jochenalt/Pentapod-Design/Readme.md

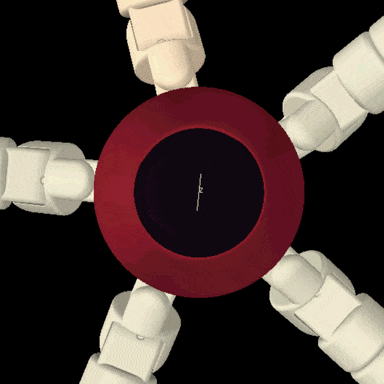
[picture p1: docs/videos/logo.gif]
work in progress
