jochenalt/Pentapod-Design/docs/kinematics.md

Kinematics is about computation of the toe’s point out of the joint angles and vice versa. First is simple, latter is tricky. 

The coordinate systems are illustrated as follows, to properly derive the Denavit Hardenberg transformation. 

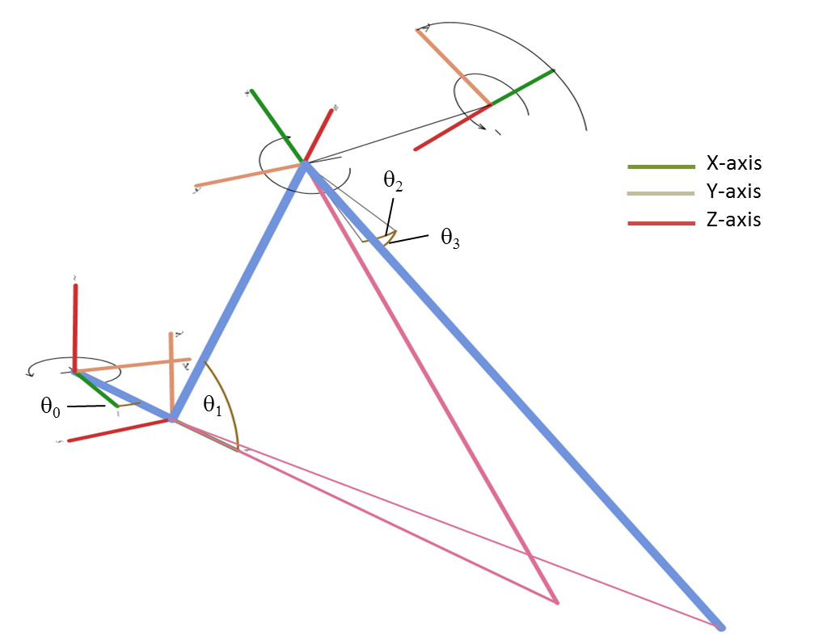
[picture p2: docs/images/image003.png]


The transformation from *angle<sub>i</sub>* to *angle<sub>i+1</sub>* is given via 

1. rotation around the x-axis by *α*

2. translation along the x-axis by *α*

3. translation along the z-axis by *d*, and

4. rotation around the z-axis by *θ*

So, the Denavit Hardenberg parameters are:

| Joint | a[°] | d[mm] | a[mm] | θ[°] |
|---  | ---| --- | --- | --- |
| Hip | *90°* | *d<sub>0</sub>* | *0* | θ<sub>0</sub>  |
| Thigh | *90°* | *d<sub>1</sub>* | *0* | θ<sub>1</sub>  |
| Knee | *90°+θ<sub>2</sub>* | *0* | *0* | *0* | |
| Foot | *0* | *d<sub>3</sub>* | *0* | θ<sub>3</sub>  |

According to the coordinate system above, θ<sub>2</sub> has an offset of 90°. The general definition of a Denavit-Hardenberg (DH) transformation is

&nbsp;&nbsp;&nbsp;&nbsp;  

which is a homogeneous matrix with two rotations (*x*,*z*) and two translations (*x*,*z*).
Combined with the DH parameters, the following DH matrixes define the transformation from one joint to its successor:

  
  
  
  

## Forward Kinematics of a Leg

With the *DH* transformation matrixes at hand, computation of the leg’s pose out of the joint angles is straight forward. The matrix representing the toe’s pose  is 

&nbsp;&nbsp;&nbsp;&nbsp; 

By multiplying the transformation matrix with the origin (as homogeneous vector), we get the absolute coordinates of the toe point (*TP*) centre point in world coordinate system (i.e. relative to the legs’s base).

&nbsp;&nbsp;&nbsp;&nbsp;

That was easy. The tricky part comes now.

## Inverse Kinematics of a Leg

Inverse kinematics denotes the computation of all joint angles out of the toe’s position (*TP*). Since the leg has four joints, it is becomes clear that there is an infinite number of solutions for that, so I need to predefine one angle with an arbitrary definition. Having the objective in mind of moving the higher limbs of the leg as little as possible, I arbitrarily chose *θ<sub>0</sub>* and set it as angle bisector of the toe to the hip (from bird’s perspective):

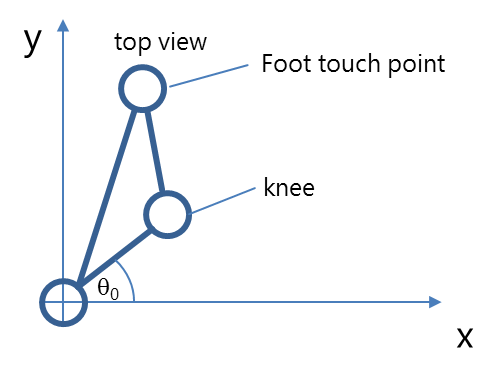
[picture p3: docs/images/image013.png]
&nbsp;&nbsp;&nbsp;&nbsp;

We get 

&nbsp;&nbsp;&nbsp;&nbsp;

Later on, we will need the coordinates of end of the first limb (*A*) which is 

Computation of the second angle *θ<sub>1</sub>*  at point *A* requires a geometric analysis. The leg is denoted in blue, all construction lines are red.

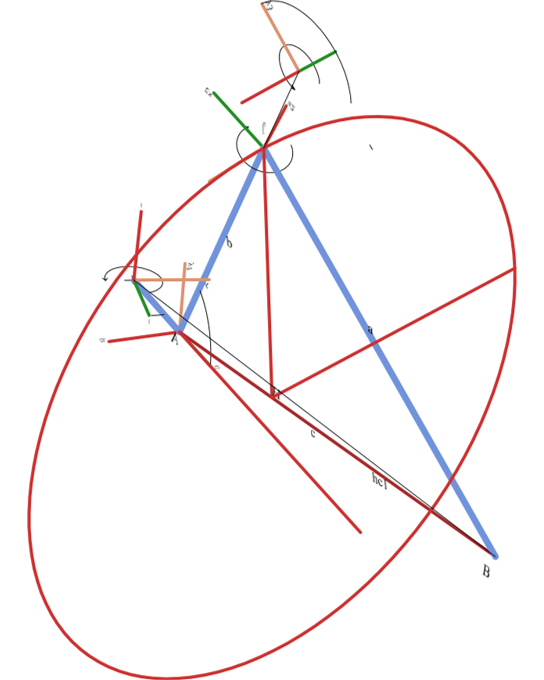
[picture p4: docs/images/image016.png]
&nbsp;&nbsp;&nbsp;&nbsp;

We consider the triangle from *A*, *B* and *C*. The two lines  and  are of fixed length. So, the point *C* is upon the circle with the centre H and the radius of the triangle’s height. Additionally, *C* is defined as function of *θ<sub>0</sub>* and *θ<sub>1</sub>*, so we should be able to derive *θ<sub>1</sub>* by intersecting the circle with *C(θ<sub>0</sub> ,θ<sub>1</sub>)*.

The only thing we need to do is to express that in terms of coordinates. First, we compute the length of *a*, *b* and *c*:

&nbsp;&nbsp;&nbsp;&nbsp;

&nbsp;&nbsp;&nbsp;&nbsp;

&nbsp;&nbsp;&nbsp;&nbsp;

Now that the triangle is defined, we can compute the height  by Herons formula

&nbsp;&nbsp;&nbsp;&nbsp;

The base of the height *H* is defined by 

&nbsp;&nbsp;&nbsp;&nbsp;

Now we need to define the circle *K* with radius *h* and centre *H*. This is done by *K = H sin(α) + T cos(α)* with *S* and *T* orthogonal to  as well as *S* and *T* being orthogonal to each other.

&nbsp;&nbsp;&nbsp;&nbsp;

So, with the arbitrary assumption  and the length  we get 

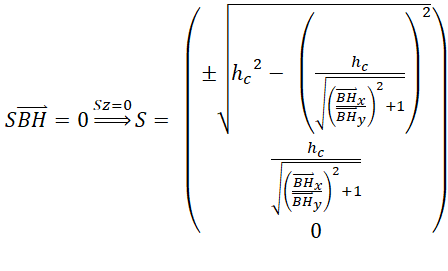
[picture p5: docs/images/image030.png]
&nbsp;&nbsp;&nbsp;&nbsp;

(This equation could be simplified, but this way programming is easier by computing the y coordinate and deriving the x coordinate)
There are two possibilities for *S*, representing two configuration with knee up and knee down. We always take the healthy one where the knee is above the toe point. Finally, T is defined by its orthogonality to *S* and its length :

&nbsp;&nbsp;&nbsp;&nbsp;

Having the circle defined, we need to intersect it with the possible positions of *C*:

&nbsp;&nbsp;&nbsp;&nbsp;

Hereby denotes  . We consider only the equations of *x* and *y* coordinates and solve these for *d<sub>1</sub>c<sub>1<sub>*. Equating gives

&nbsp;&nbsp;&nbsp;&nbsp;

This needs to be solved by in order to get point *C*. Unfortunately, we have *sin* and *cos* in the equation, but luckily with the same parameter. Wikipedia helps with sinusoids:

&nbsp;&nbsp;&nbsp;&nbsp;

This is used to solve the equation above for *α*:

&nbsp;&nbsp;&nbsp;&nbsp;

&nbsp;&nbsp;&nbsp;&nbsp;

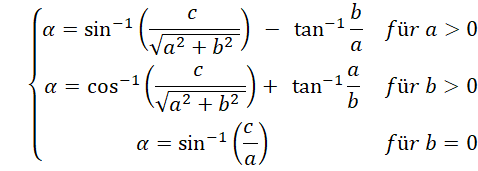
[picture p6: docs/images/image040.png]
&nbsp;&nbsp;&nbsp;&nbsp;

Out of *α* we get *C* by , out of *C* we compute *θ<sub>1</sub>* by considering the z-coordinate of *C*:

&nbsp;&nbsp;&nbsp;&nbsp;

which results in 

&nbsp;&nbsp;&nbsp;&nbsp;

The first angle is always the hardest, time for a beer.

We leave the knee-turn-angle *θ<sub>2</sub>* aside for a while and continue with the tibia *θ<sub>3</sub>*. This is done by considering the triangle *ABC*, and the angle at the point *C* represents *θ<sub>3</sub>*. In a fully elongated leg *θ<sub>3</sub>* is 0.
Therefore,  

The last angle *θ<sub>2</sub>* is computed by use of

&nbsp;&nbsp;&nbsp;&nbsp;

So, let’s have a closer look into the transformation matrix  and check if there are some useful equations considering that we already have all other angles. Annoying multiplication results in

&nbsp;&nbsp;&nbsp;&nbsp;

Since we need to compare this to the toe point, it is not necessary to compute the full matrix, the right column is sufficient. We are lucky, the third line has only one expression that depends on *θ<sub>2</sub>*, so we get

&nbsp;&nbsp;&nbsp;&nbsp;

Again, *arcsin* results in two solutions, so we need the other coordinates as well to check which solution is valid.
That’s it. Surprisingly complex for a leg with only 4 degrees of freedom.

# Body Kinematics

Attaching 5 legs around the body requires a transformation as well, plus we might want to translate and rotate the belly. Since the leg kinematics computes the limb angles out of the toe in the hip's coordinate system, we need to translate each leg’s toe point into the hip’s coordinate system.

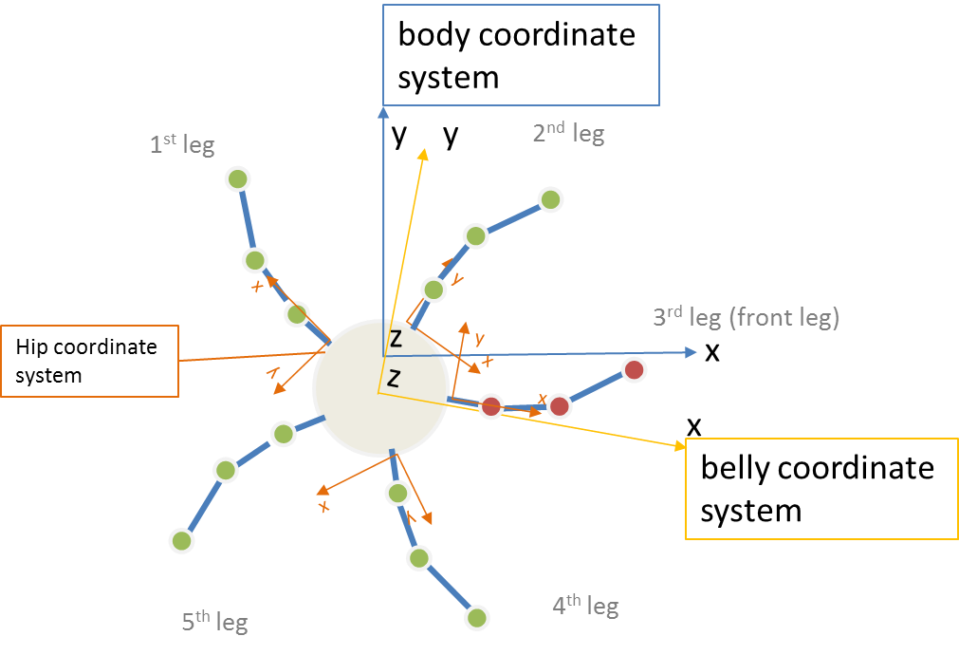
[picture p7: docs/images/image049.png]
&nbsp;&nbsp;&nbsp;&nbsp;

The pentapod’s pose is given in the body’s coordinate system, which origin is on the ground right below the body. The next coordinate system is owned by the belly which origin is the belly button. When the pentapod is in the default position, the belly coordinate system is translated in the z-axis by z-translation along the height of the belly. Finally, we have 5 hip coordinate systems which are x-translated by the distance of the belly to the hip and z-rotated by , where *n* is the number of the leg.
We define the transformation matrix *Belly* that defines the belly coordinate system out of the body coordinate system, that is a 3D rotation matrix plus a translation along the belly coordinates:

&nbsp;&nbsp;&nbsp;&nbsp;

For each leg we have an own transformation matrix which is a rotation θ in the *xy*-pane around the  *z*-axis:

&nbsp;&nbsp;&nbsp;&nbsp;

Having a point in one coordinate system and watching it from another one is done by multiplying it with the inverse transformation matrix. So, the toe point from the hips coordinate system *toe<sub>hip</sub>* is computed out of the toe point from the body’s coordinate system by 

&nbsp;&nbsp;&nbsp;&nbsp;

Computing-wise, the inverse matrix is done by Gauss or similar approaches with a complexity of *o(nm/2)*, which might be bad for the performance. Luckily, the inverse of a symmetric rotation matrix is the transposed matrix, and the rest can be computed by 

&nbsp;&nbsp;&nbsp;&nbsp;

which is much simpler.
