jochenalt/Pentapod-Design/docs/gait.md

Unfortunately, there's no real creature I am aware of that walks with five legs. You need three legs to stand, so two legs can leave the ground at the same time. This means that one leg is 60% of its time in the air above the ground. A tripod gait is not possible, a wave gait is really slow, but a ripple gait in a modified version for 5 legs is reasonable. The order of legs moving is 1,3,5,2,4:

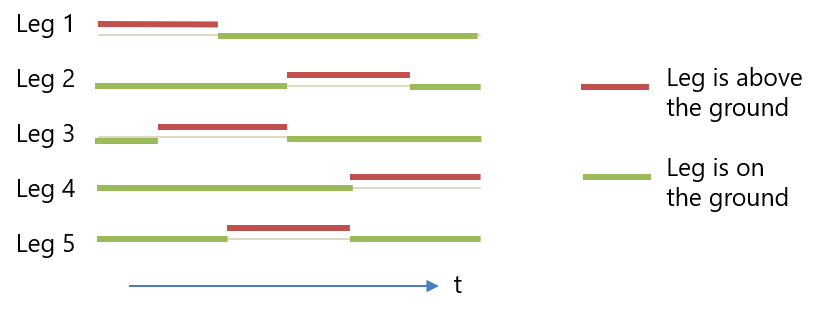
[picture p19: docs/images/ripple-gait.png]


The animation shows a red triangle that indicates the area where the bot is standing on. The sequence above leads to a slowly turning triangle.

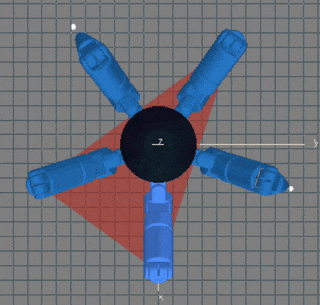
[picture p20: docs/videos/gaittimeshift.gif]


Still, it might be a need to have one spare leg to do something yukky. In that case a wave gait is the only alternative:

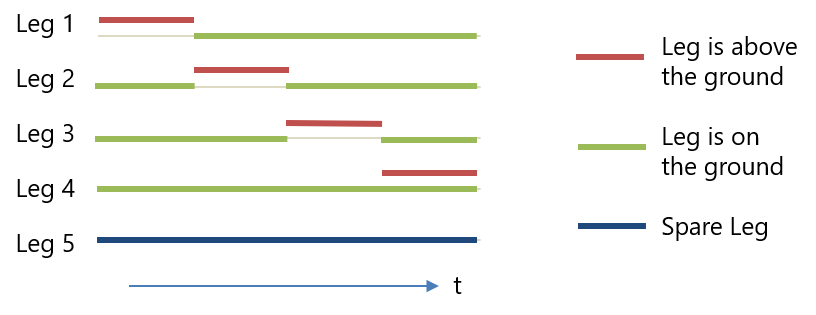
[picture p21: docs/images/wave-gait-with-spare-leg.png]


Being aware that the hips are now asymmetrically arranged, the body needs to be translated to be located above the supporting area. To avoid being on the edge of this area, the body swings towards the middle of this area:

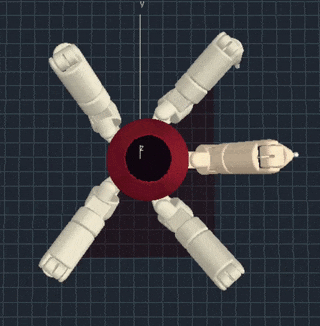
[picture p22: docs/videos/wave-gait-with-one-spare-leg.gif]


The leg movement is modelled with a cubic bezier curve with the first support point in the middle of the gait and the second one right above the touch point. This gives a bent curve accelerating when leaving the ground, and braking before touching the ground again.

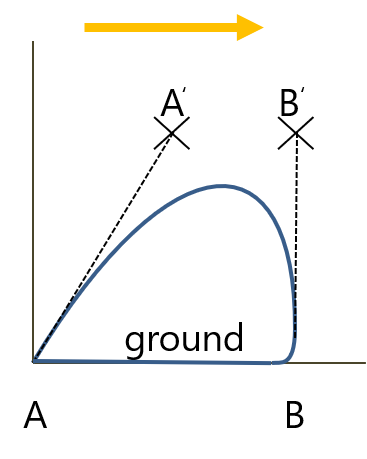
[picture p23: docs/images/leg-movement.png]


In real life this looks like this. Right before touching the ground the leg starts moving backwards. This is helpful to avoid a jolt giving an impulse to the body against the walking direction. 

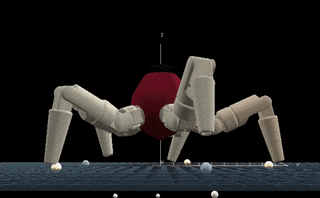
[picture p24: docs/videos/leg-movement.gif]


If the ground is not plain, the distance sensors in the leg detect that. After the zenith of the movement, the current distance to the ground is constantly compared to the expected distance according to the gait curve above2. The z-coordinate of the touch point is adapted accordingly leading to a compressed or stretched second half of the movement:

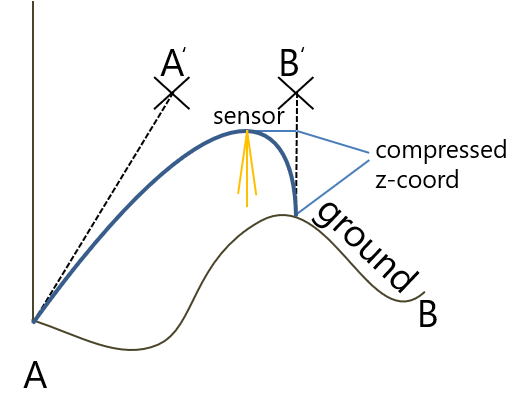
[picture p25: docs/images/leg-movement-terrain.png]
