jochenalt/Pentapod-Design/theory/Kinematic.pptx

lCoxa

m

lfemur

lTibia

ServoFemur

ServoTibia
