jochenalt/Pentapod-Design/docs/Images.pptx

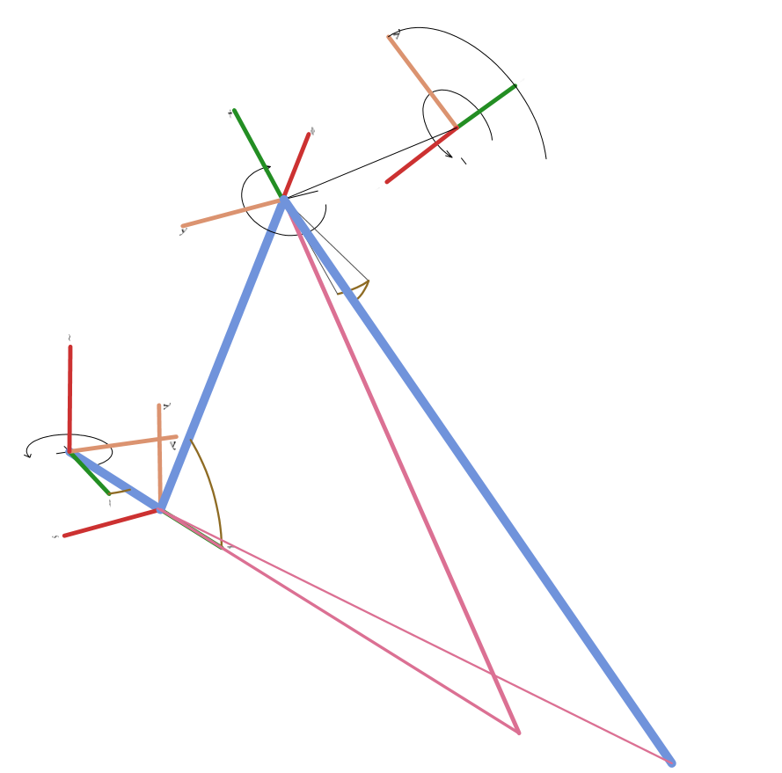
[picture p38: figure]

θ2

X-axis
Y-axis
Z-axis

θ3

θ0

θ1

## Slide 2

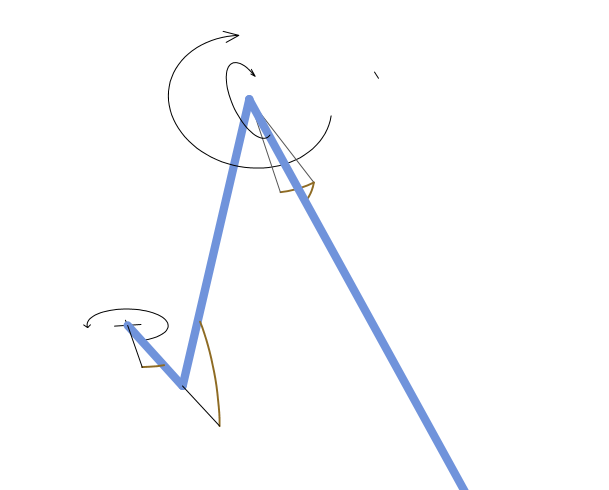
[picture p39: figure]

knee

foot

turning knee

hip

thigh

toe

## Slide 3


## Slide 4

body coordinate
system

z

2nd leg

y

x

y

x

y

x

z

1st leg

y

y

y

x

3rd leg (front leg)

Hip coordinate
system

x

x

belly coordinate
system

5th leg

4th leg

## Slide 5

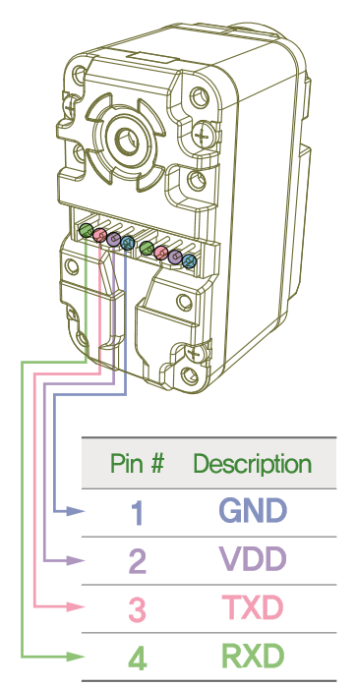
[picture p40: figure]
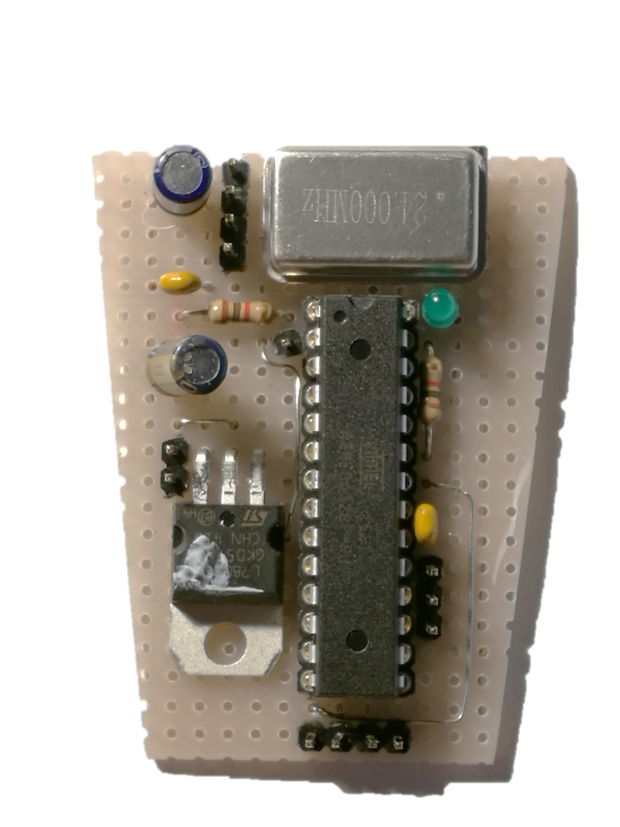
[picture p41: figure]

Herkulex
Servo Out

GND o
VDD o
TXD o
RXD o

RST o

GND o
5V o

AVR-ISP

o SCL
o MISO
o MOSI

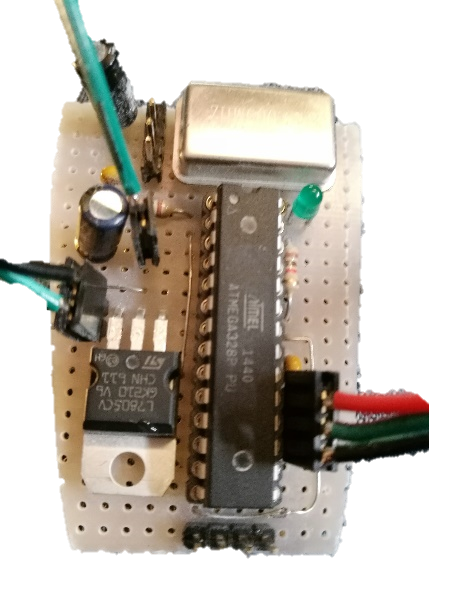
[picture p42: figure]

GND o
5V o
SDA o
Scl o

VL6180X

## Slide 6

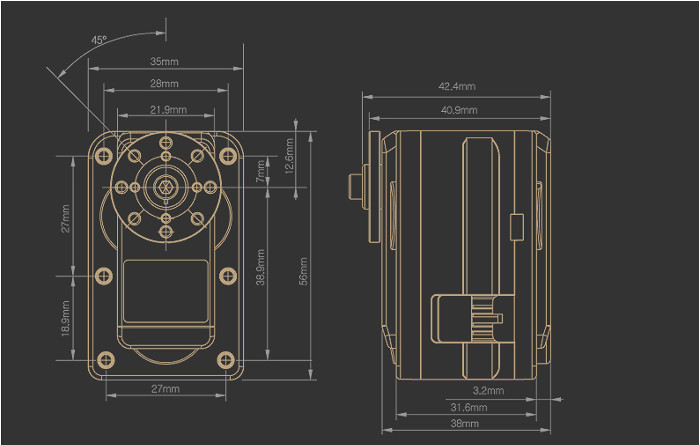
[picture p43: figure]

## Slide 7

Odroid
Linux/ROS

ROS node rplidarNode

ROS node hector_mapping

ROS node pentapod_engine

Teensy 3.5,
Arm M4, 120 Mhz

Legs

Leg 1..5

Leg

Leg

Leg

Leg

ROS node pentapod_server

RPLidar Driver

Hector SLAM

UART
/dev/ttyS1

Lidar

Cortex
Servo Control, IMU Data Grabber,
Distance Sensor Grabber

I2C1

UART2

UART3

Servo Thigh

Servo
Hip

UART4

Distance
Sensor
VL6180

Servo Knee

Servo Foot

Webserver REST
Mongoose

UART5

Servo Sensor
Adapter

UART6

I2C0

IMU
BNO055

Engine

I2C
/dev/i2c-1

Software
Module

Hardware, Sensor, Motor

Protocol,
Adapter

## Slide 8

Odroid
Linux/ROS

node „Server“

node „SLAM“

SLAM

Webserver

map

Lidar

Planning

Odometry

target

move

node „Engine“

Engine

map

state

state

move

move
