jochenalt/Pentapod-Design/theory/Denavit-Hartenberg.pdf

## Denavit-Hartenberg-Konventionen

Die Denavit-Hartenberg-Konventionen sind weit verbreitet und sollen die Durchführung der kinematischen Vorwärts- und Rückwärtstrans-formation erleichtern. Sie bestehen aus folgenden Teilen:

●DH-Konventionen zur Festlegung der Koordinatensysteme
●DH-Transformationen zur Erzeugung der Koordinatensysteme
●DH-Parametern aus den Transformationen

## Denavit-Hartenberg-Konventionen Festlegung der Koordinatensysteme

Die Festlegung der Koordinatensysteme erfolgt nach festen Regeln, um die nachfolgenden Schritte problemlos (?!) durchführen zu können.

Eine gewisse Wahlfreiheit bleibt trotzdem erhalten.

Diese Wahlfreiheit sollte so genutzt werden, dass möglichst viele DH-Parameter gleich Null werden. Dadurch werden die nachfolgenden Gleichungen und Berechnungen vereinfacht.

### Festlegung des Koordinatensystems K0

### (Sockel)

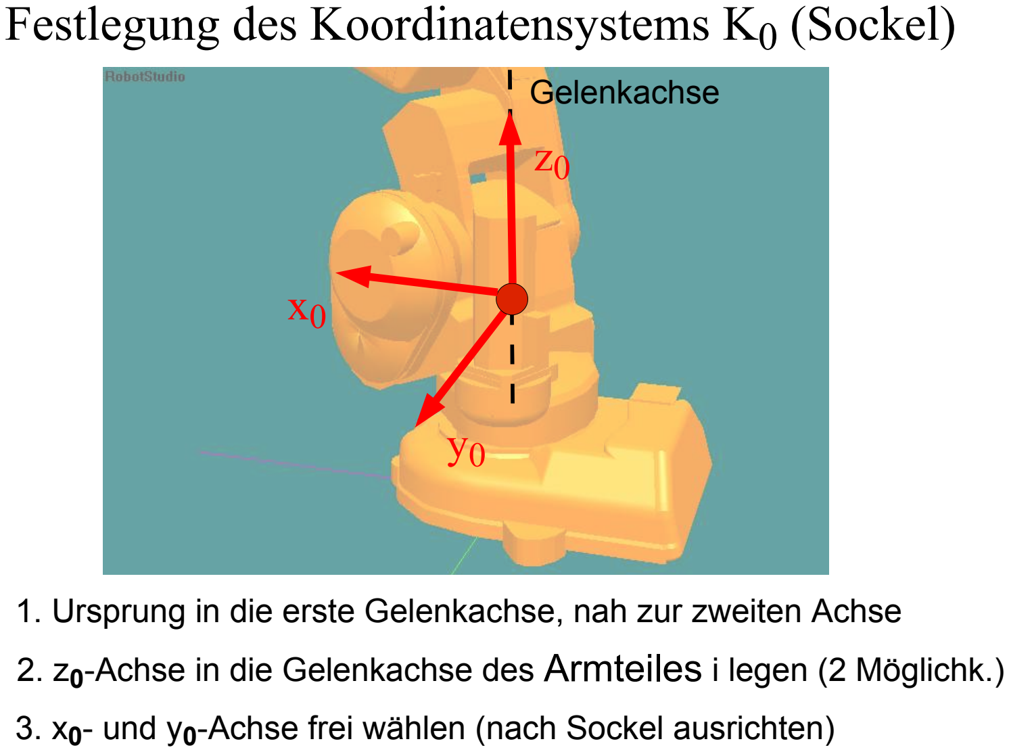
[picture p44: page 3]

Gelenkachse

1. Ursprung in die erste Gelenkachse, nah zur zweiten Achse
2. z0-Achse in die Gelenkachse des Armteiles i legen (2 Möglichk.)

y0

3. x0- und y0-Achse frei wählen (nach Sockel ausrichten)

z0

x0

### Festlegung des Koordinatensystems Ki

### bei

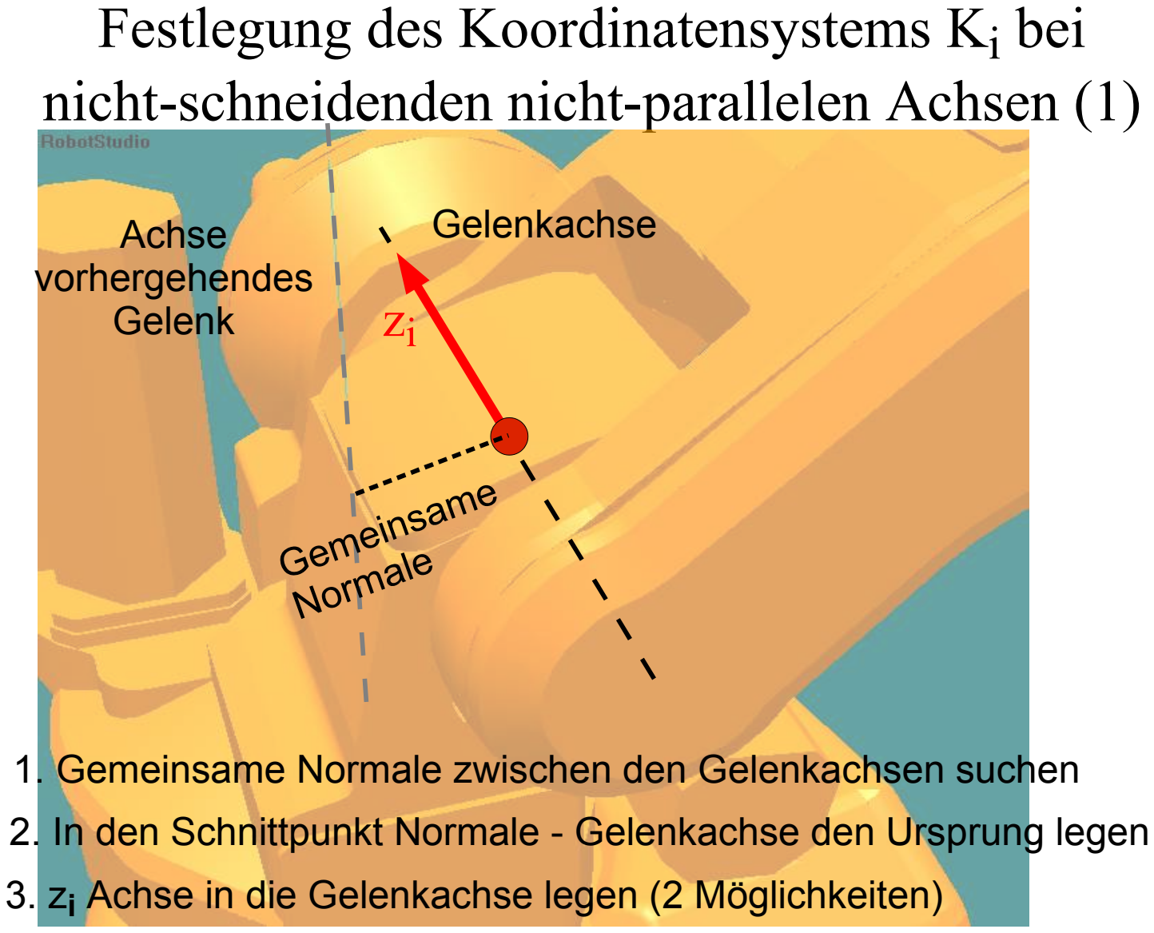
[picture p45: page 4]

### nicht-schneidenden nicht-parallelen Achsen (1)

1. Gemeinsame Normale zwischen den Gelenkachsen suchen
2. In den Schnittpunkt Normale - Gelenkachse den Ursprung legen

Gelenkachse
zi

Achse
vorhergehendes
Gelenk
3. zi Achse in die Gelenkachse legen (2 Möglichkeiten)

Gemeinsame
Normale

### Festlegung des Koordinatensystems Ki

### bei

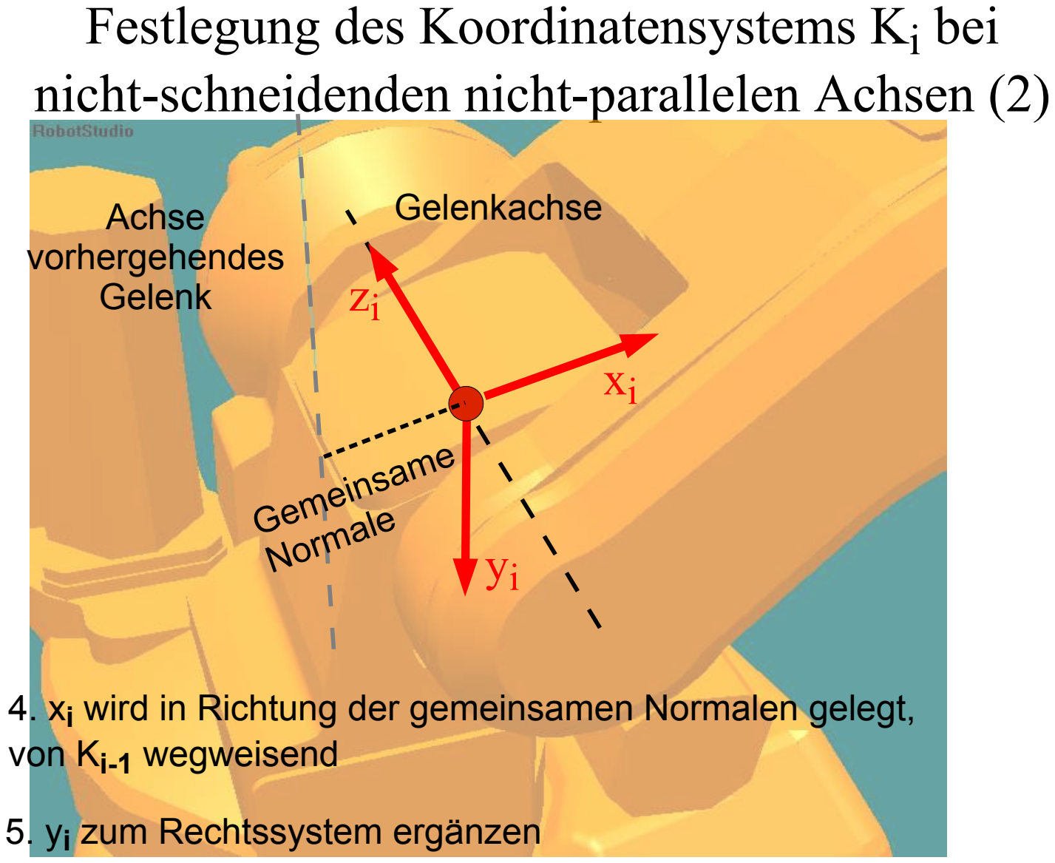
[picture p46: page 5]

### nicht-schneidenden nicht-parallelen Achsen (2)

4. xi wird in Richtung der gemeinsamen Normalen gelegt, von Ki-1 wegweisend
5. yi zum Rechtssystem ergänzen

Gelenkachse

yi

zi
xi

Achse
vorhergehendes
Gelenk

Gemeinsame
Normale

### Festlegung des Koordinatensystems Ki

### bei

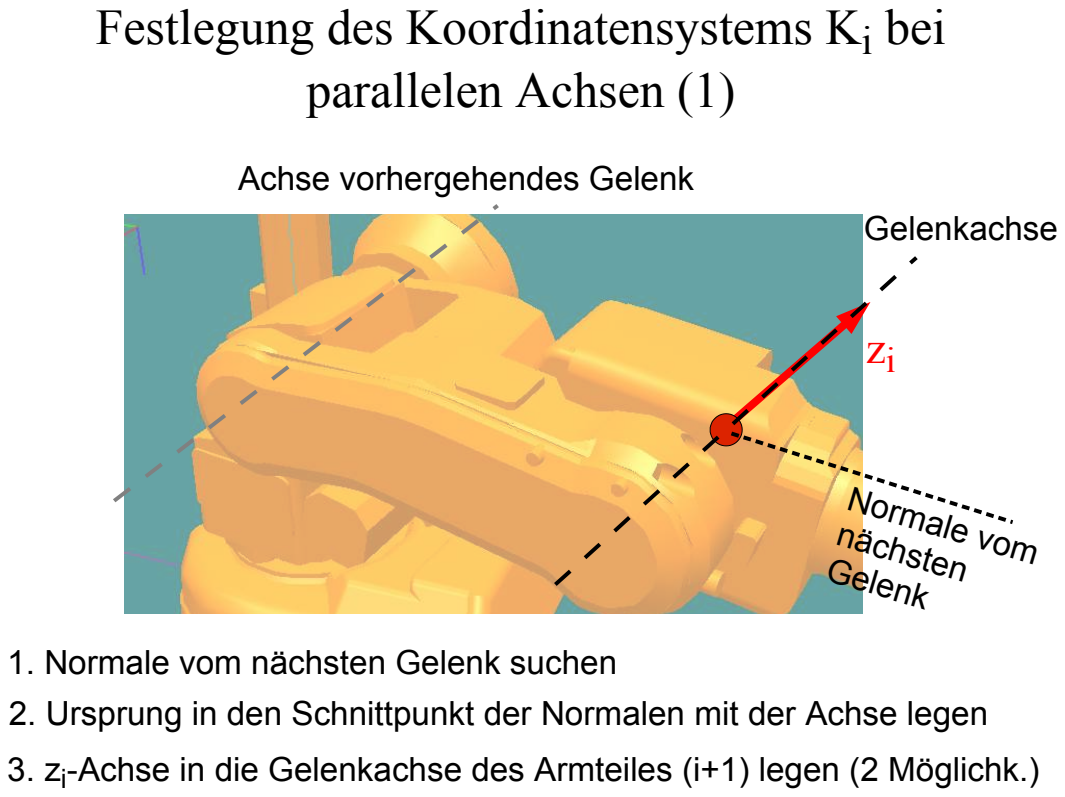
[picture p47: page 6]
parallelen Achsen (1); Gelenkachse; Normal nä; e vom; chst; en elenk

Achse vorhergehendes Gelenk

1. Normale vom nächsten Gelenk suchen
2. Ursprung in den Schnittpunkt der Normalen mit der Achse legen

-Achse in die Gelenkachse des Armteiles (i+1) legen (2 Möglichk.)

### Festlegung des Koordinatensystems Ki

### bei

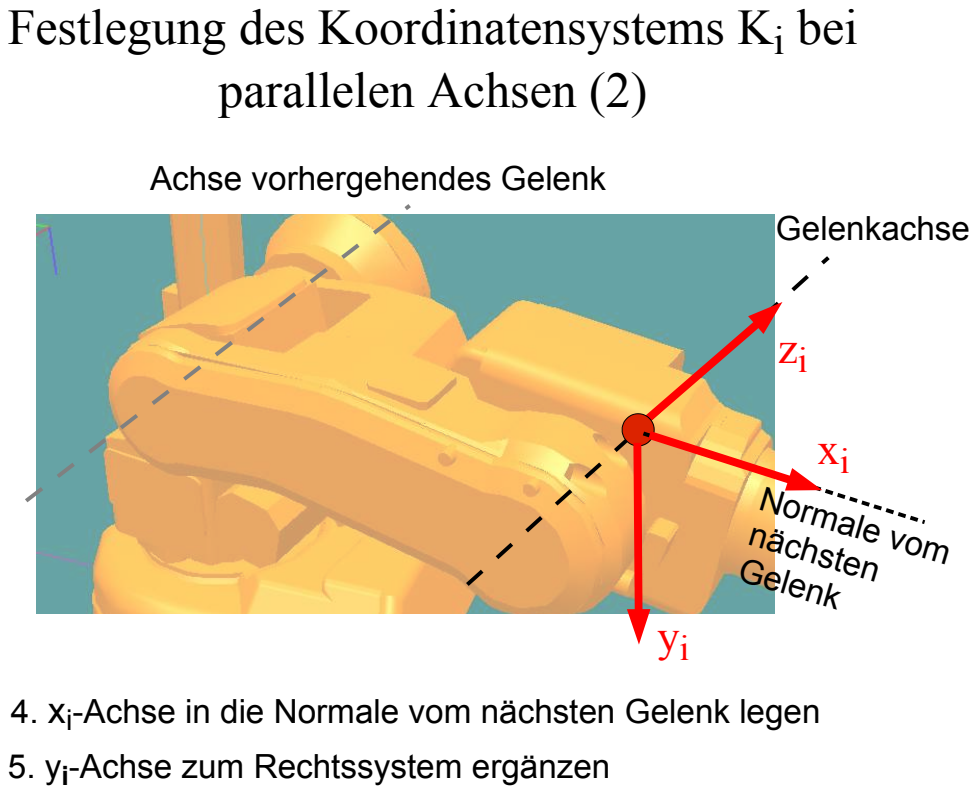
[picture p48: page 7]
parallelen Achsen (2); Gelenkachse; Normal nä; e vom; chst; en elenk

Achse vorhergehendes Gelenk

-Achse in die Normale vom nächsten Gelenk legen

-Achse zum Rechtssystem ergänzen

### Festlegung des Koordinatensystems Ki

### bei

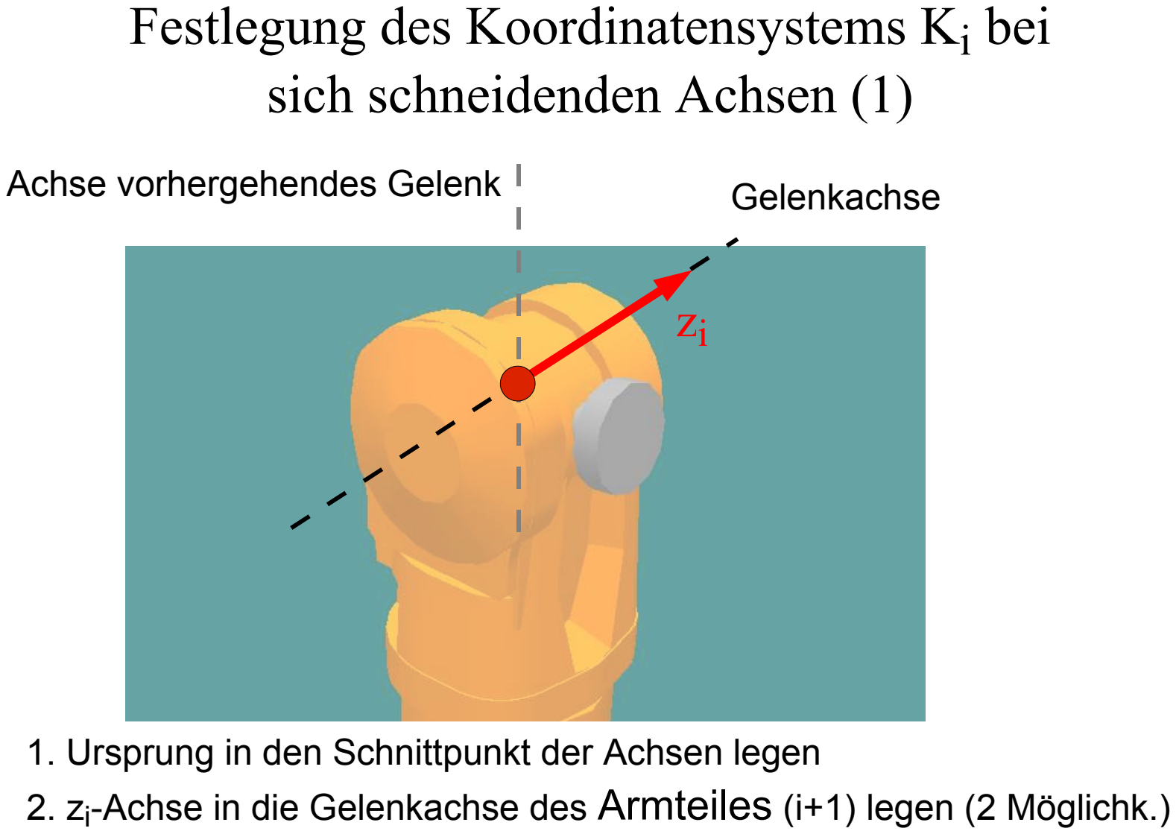
[picture p49: page 8]

### sich schneidenden Achsen (1)

Gelenkachse

zi

Achse vorhergehendes Gelenk

1. Ursprung in den Schnittpunkt der Achsen legen
2. zi

-Achse in die Gelenkachse des Armteiles (i+1) legen (2 Möglichk.)

### Festlegung des Koordinatensystems Ki

### bei

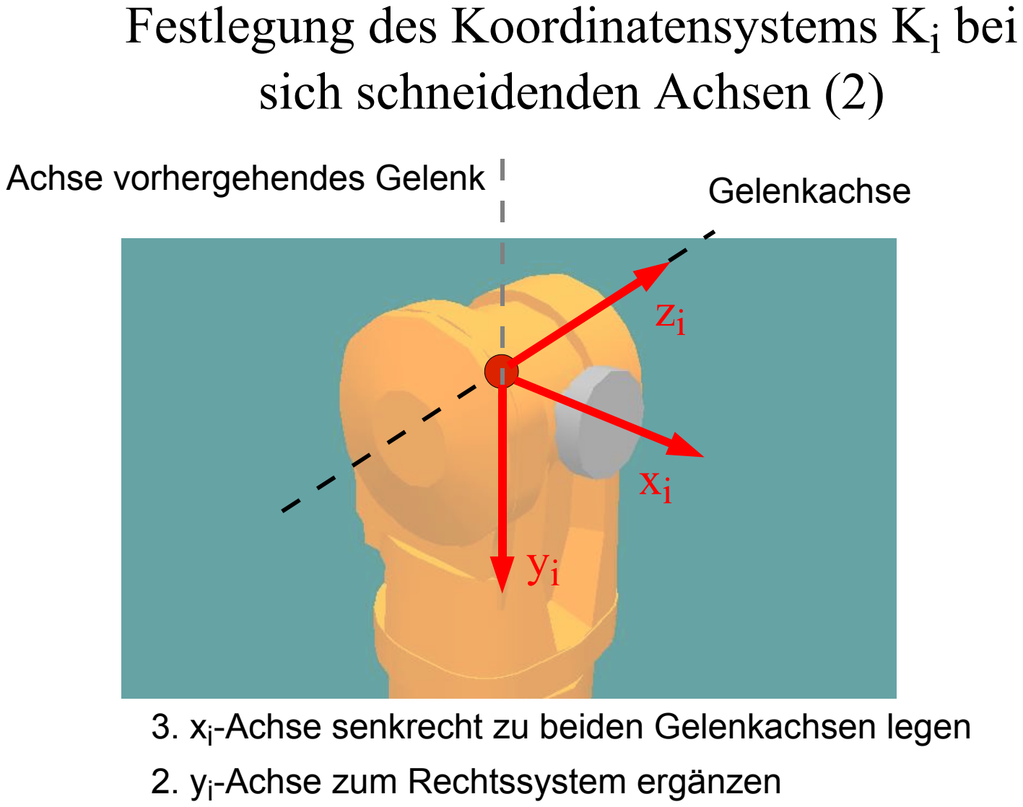
[picture p50: page 9]

### sich schneidenden Achsen (2)

Achse vorhergehendes Gelenk | Gelenkachse

zi

3. xi

-Achse senkrecht zu beiden Gelenkachsen legen
2. yi

-Achse zum Rechtssystem ergänzen

xi
yi

### Festlegung der Handflanschkoordinaten KN

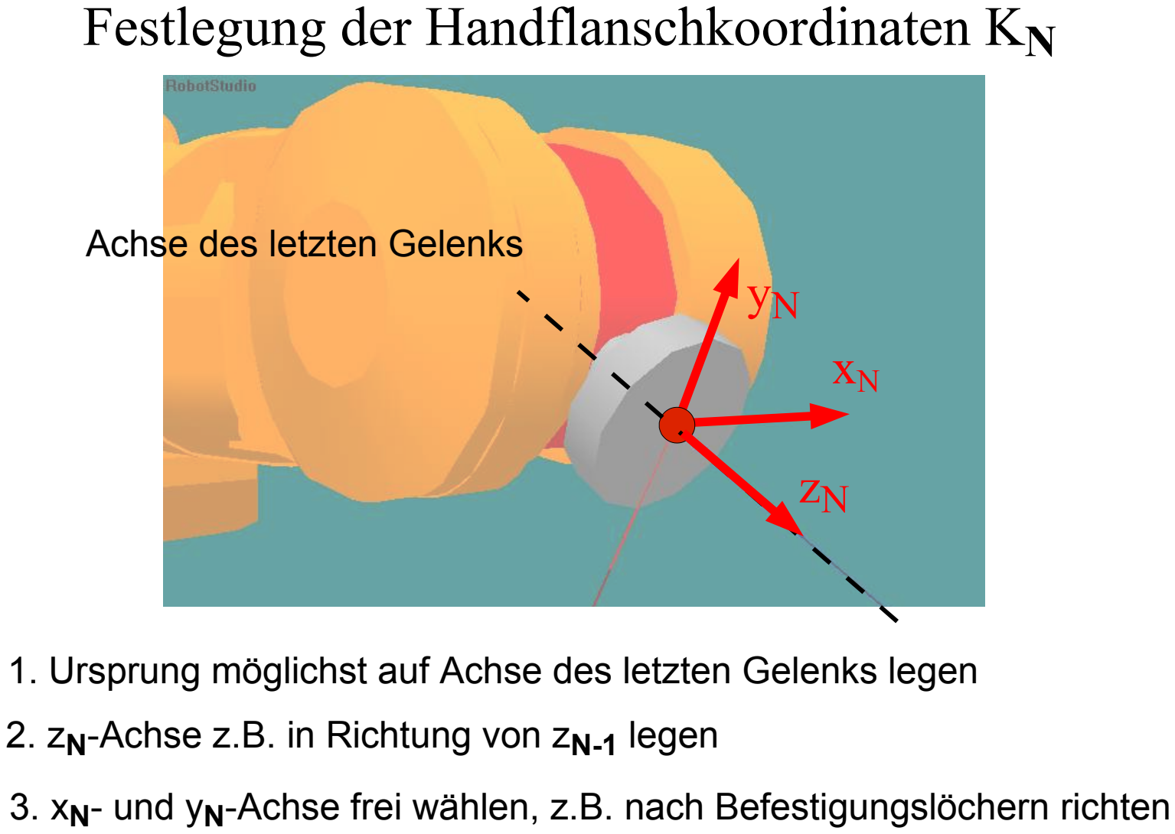
[picture p51: page 10]

1. Ursprung möglichst auf Achse des letzten Gelenks legen
2. zN-Achse z.B. in Richtung von zN-1 legen
3. xN- und yN-Achse frei wählen, z.B. nach Befestigungslöchern richten

xN

yN

Achse des letzten Gelenks

zN

### Die Denavit-Hartenberg- Transformation

Nach der Festlegung der Koordinatensysteme werden die Denavit Hartenberg-Transformationen bestimmt. Sie erzeugen jedes Koordinatensystem (außer dem ersten) aus dem vorhergehenden.

So ergibt sich eine kinematische Kette: AT0 – AT1 – AT2 – AT3 – AT4 – AT5 – AT6

(AT=Armteil)

### Die Denavit-Hartenberg- Transformation

Jede Denavit-Hartenberg-Transformation besteht aus vier elementarenTransformationen:

1. Rotation um die x-Achse um αi
2. Translation entlang x-Achse um ai
3. Translation entlang z-Achse um di
4. Rotation um die z-Achse um θi

xi

zi

yi

### 1. Rotation um die x-Achse um αi

## Denavit-Hartenberg -Transformation

## Denavit-Hartenberg -Transformation

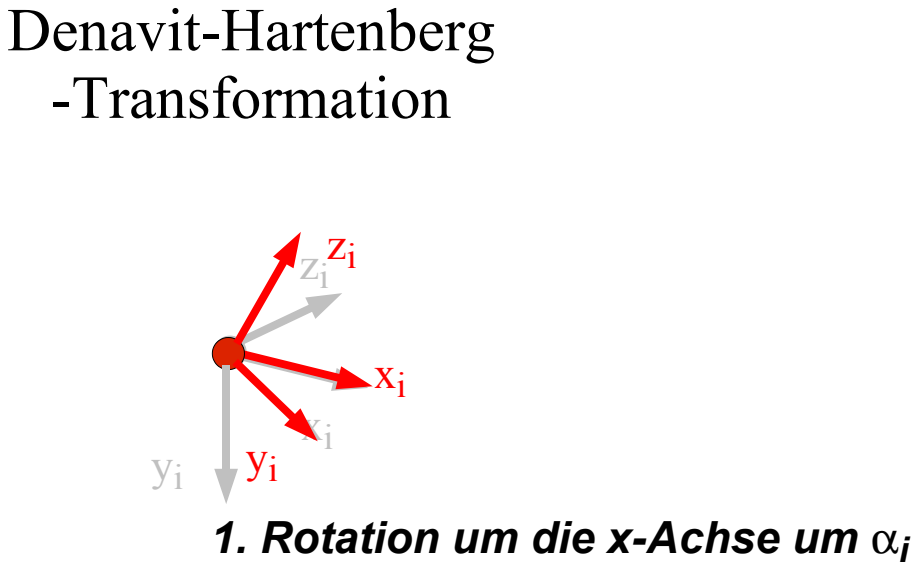
[picture p52: page 14]

1. Rotation um die x-Achse um αi

## Denavit-Hartenberg -Transformation

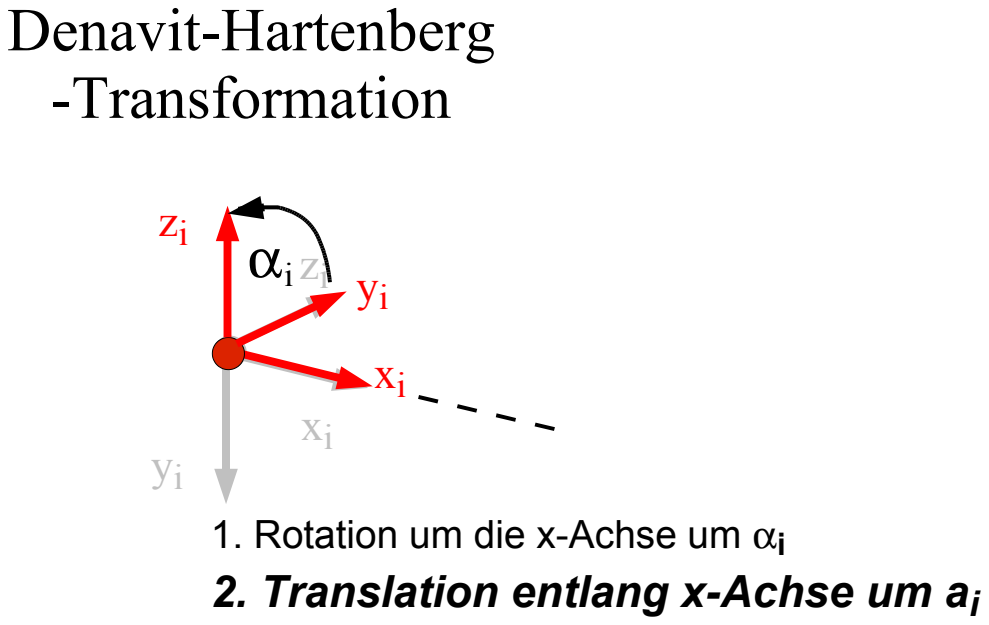
[picture p53: page 15]

1. Rotation um die x-Achse um αi
2. Translation entlang x-Achse um ai

## Denavit-Hartenberg -Transformation

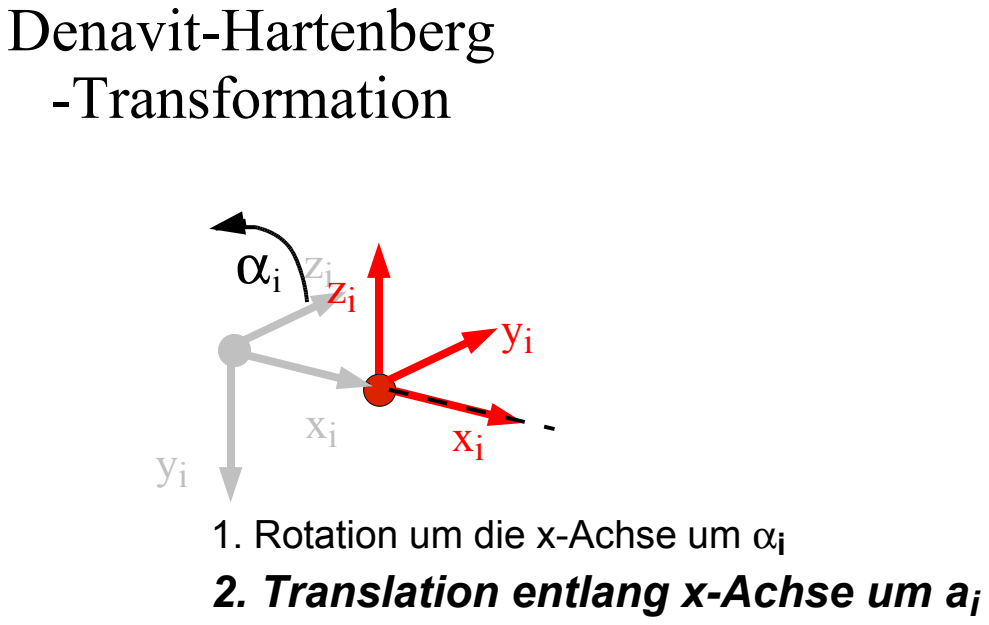
[picture p54: page 16]

1. Rotation um die x-Achse um αi
2. Translation entlang x-Achse um ai

## Denavit-Hartenberg -Transformation

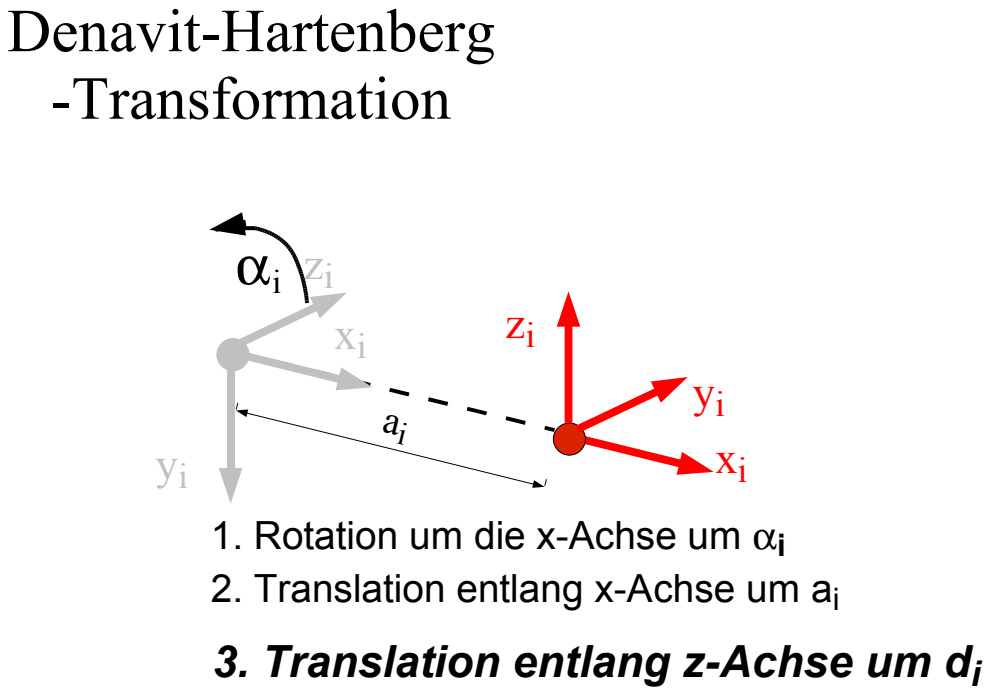
[picture p55: page 17]

1. Rotation um die x-Achse um αi
2. Translation entlang x-Achse um ai
3. Translation entlang z-Achse um di

## Denavit-Hartenberg -Transformation

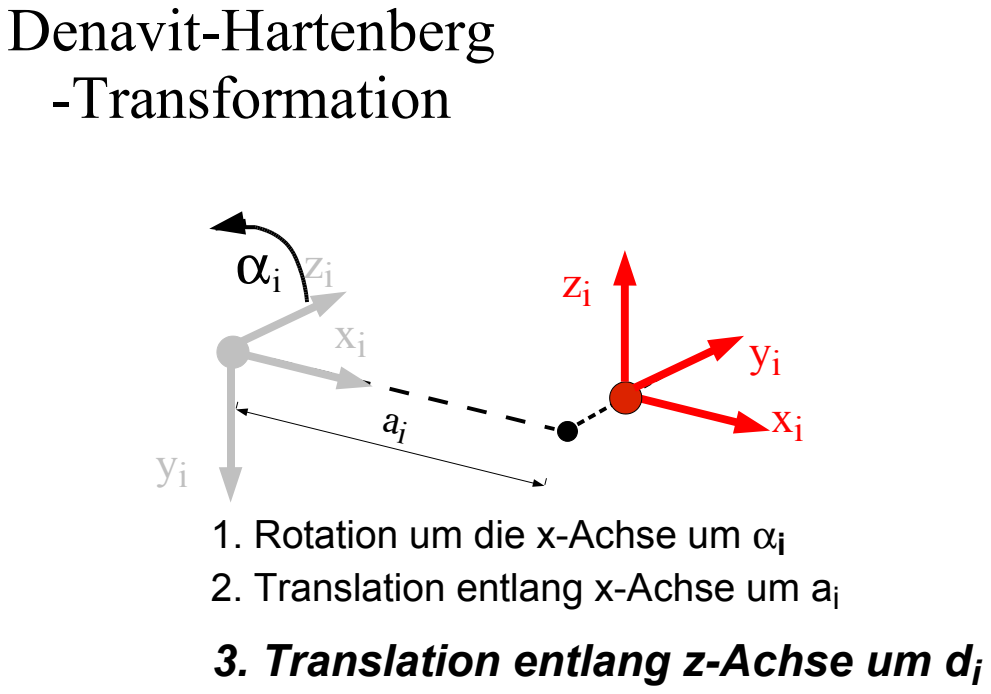
[picture p56: page 18]

1. Rotation um die x-Achse um αi
2. Translation entlang x-Achse um ai
3. Translation entlang z-Achse um di

## Denavit-Hartenberg -Transformation

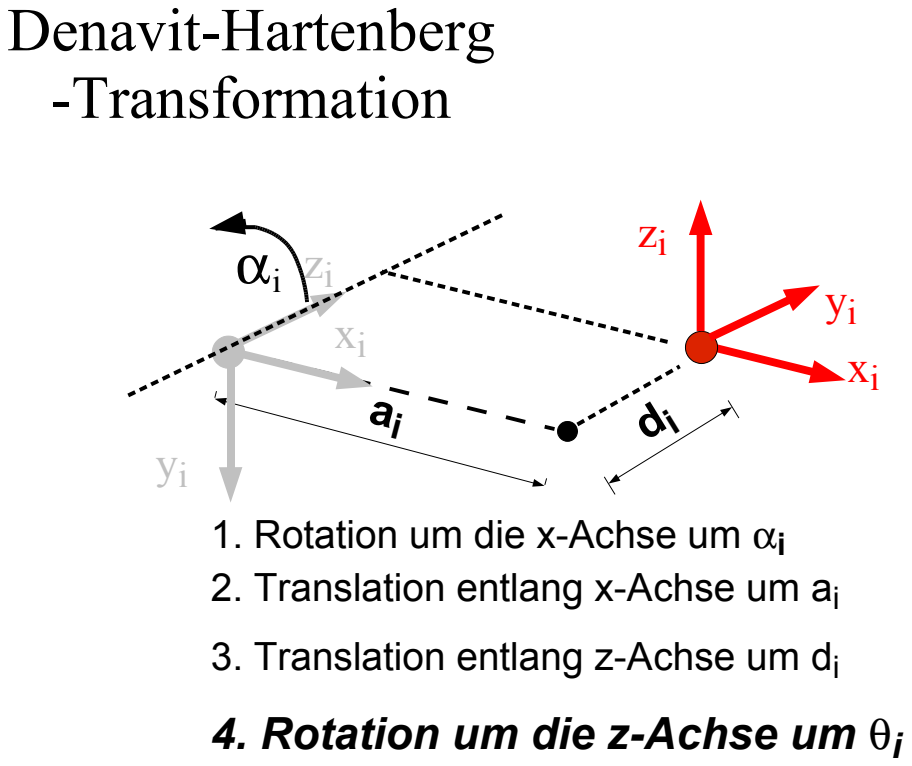
[picture p57: page 19]

1. Rotation um die x-Achse um αi
2. Translation entlang x-Achse um ai
3. Translation entlang z-Achse um di
4. Rotation um die z-Achse um θi

## Denavit-Hartenberg -Transformation

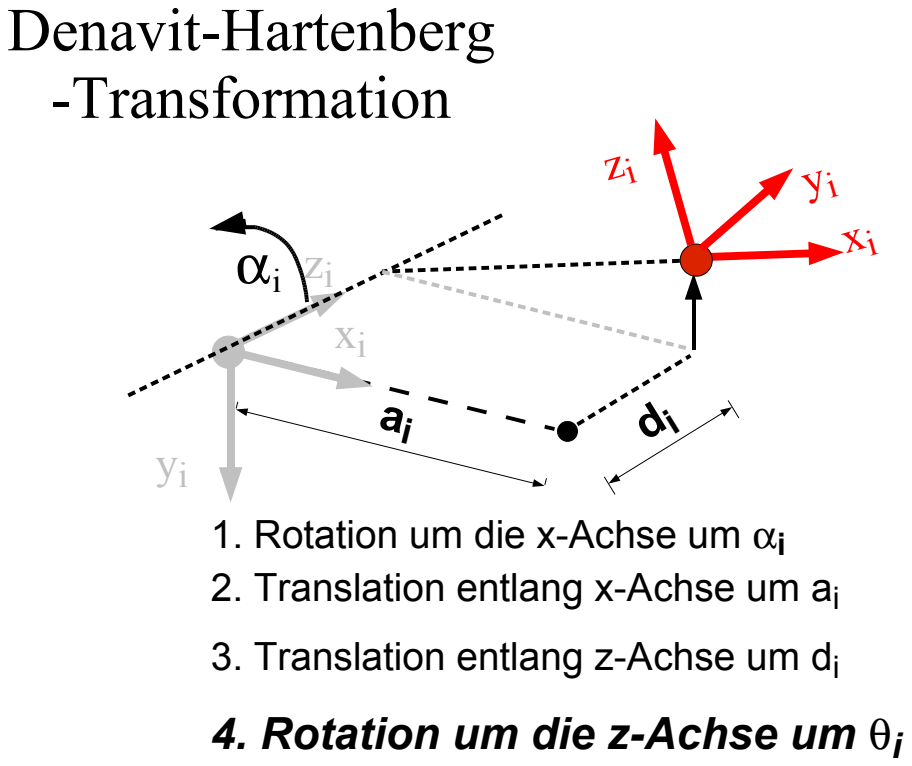
[picture p58: page 20]

1. Rotation um die x-Achse um αi
2. Translation entlang x-Achse um ai
3. Translation entlang z-Achse um di
4. Rotation um die z-Achse um θi

## Denavit-Hartenberg -Transformation

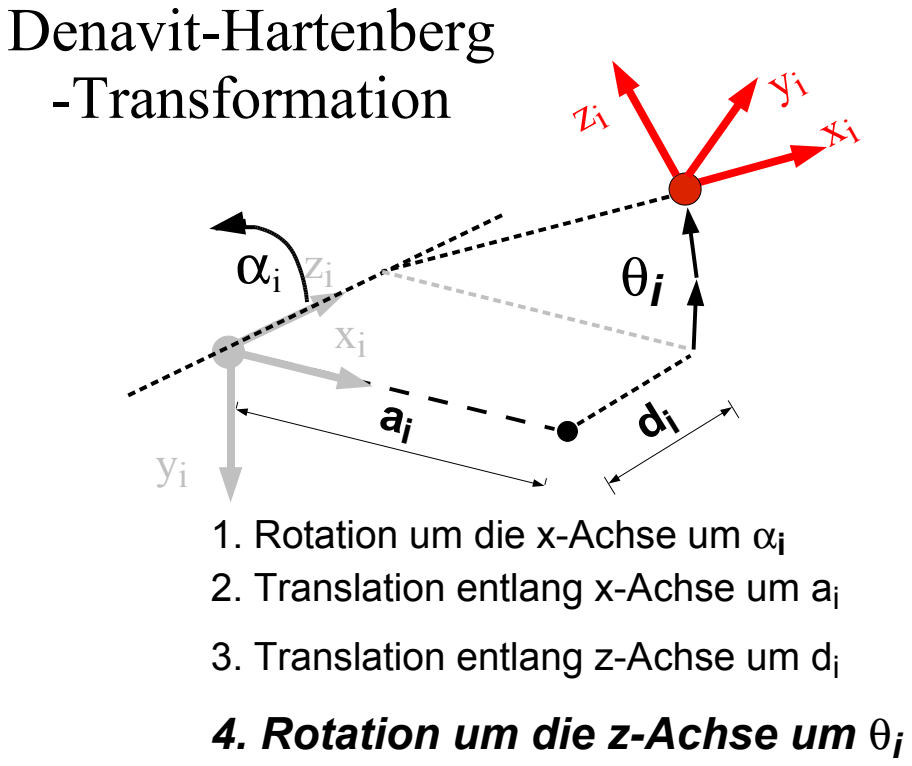
[picture p59: page 21]

1. Rotation um die x-Achse um αi
2. Translation entlang x-Achse um ai
3. Translation entlang z-Achse um di
4. Rotation um die z-Achse um θi

### Die Denavit-Hartenberg-Parameter

Die Denavit-Hartenberg-Transformation wird durch vier Parameter beschrieben:

1. αi : konstruktiver Parameter
2. ai : konstruktiver Parameter
3. di : konstruktiver Parameter bei Rotationsgelenken,

variabel bei Lineargelenken
4. θi : konstruktiver Parameter bei Lineargelenken, variabel

bei Rotationsgelenken

### Die Denavit-Hartenberg-Parameter

Wenn die Koordinatensysteme festgelegt sind, müssen die Denavit-Hartenberg-Parameter bzw. die dazu gehörenden Transformationen gefunden werden.

Tipps:
●Die beiden Translationen werden so gewählt, dass der Ursprung von Ki-1 mit der abschließenden Rotation um zi-1 in den Ursprung von Ki gelangt.
●Die erste Rotation (um xi-1) muss so verlaufen, dass eine evtl. Achse in Richtung von zi-1 schon ihre Endlage erreicht.
