jochenalt/Pentapod-Design/docs/images/coordinatesystem.pdf

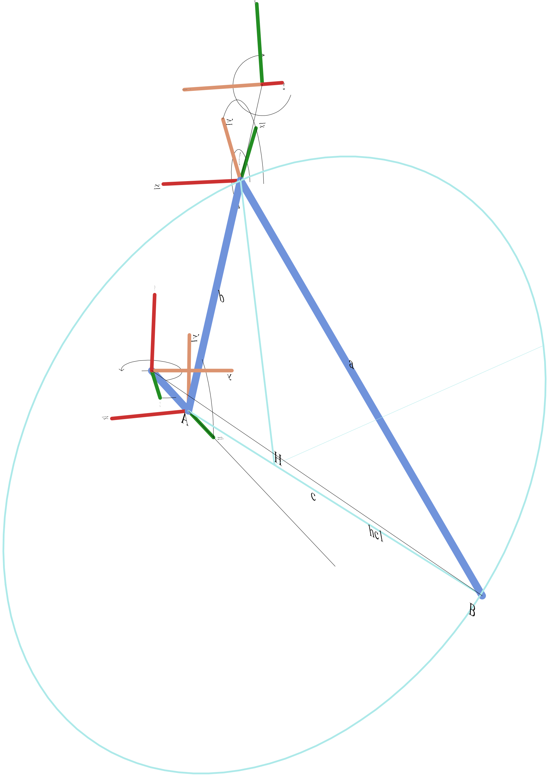
[picture p60: figure]
