jochenalt/Pentapod-Design/docs/images/coordinatesystems.pdf

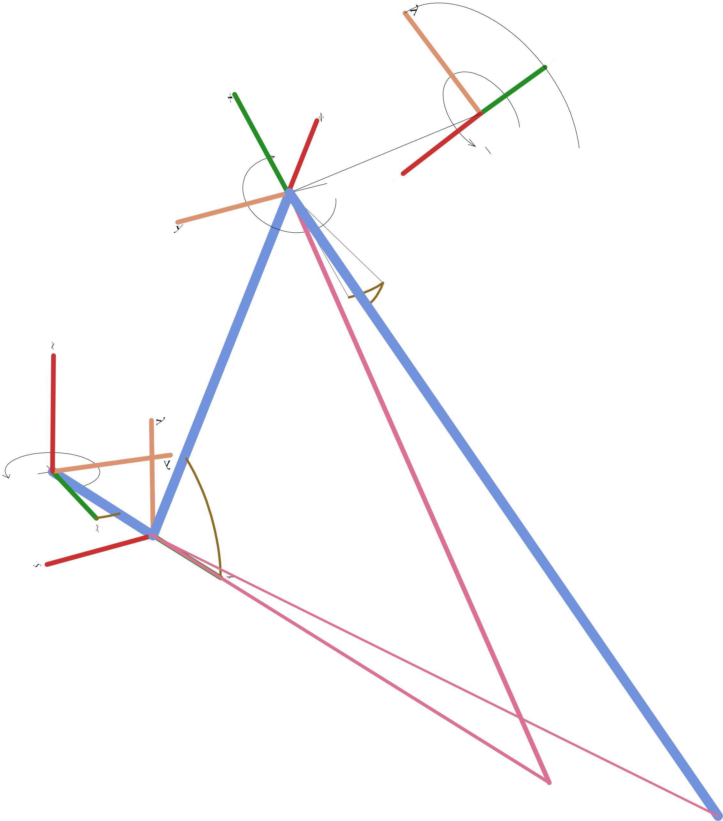
[picture p61: figure]
