jochenalt/Pentapod-Design/docs/images/IK femur computation.pdf

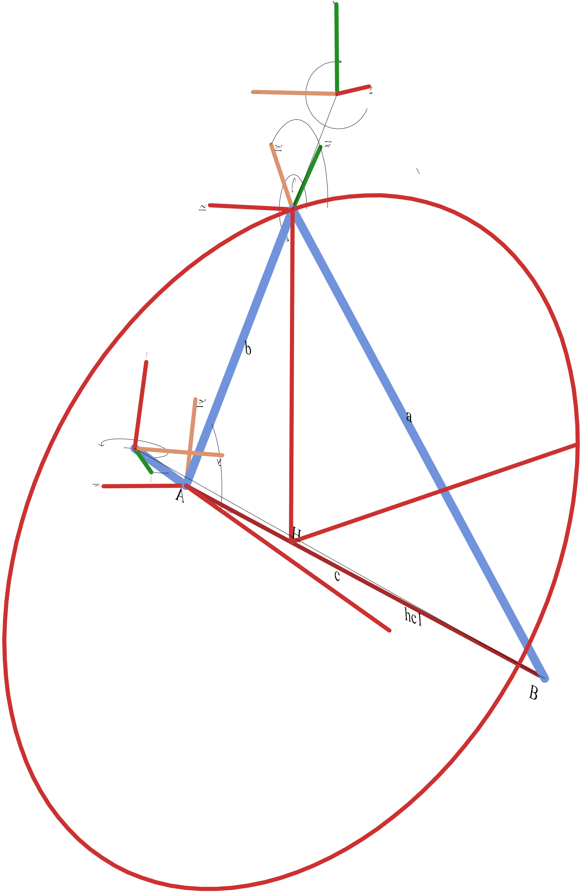
[picture p62: figure]
