jochenalt/Pentapod-Design/docs/images/IK tibia computation.pdf

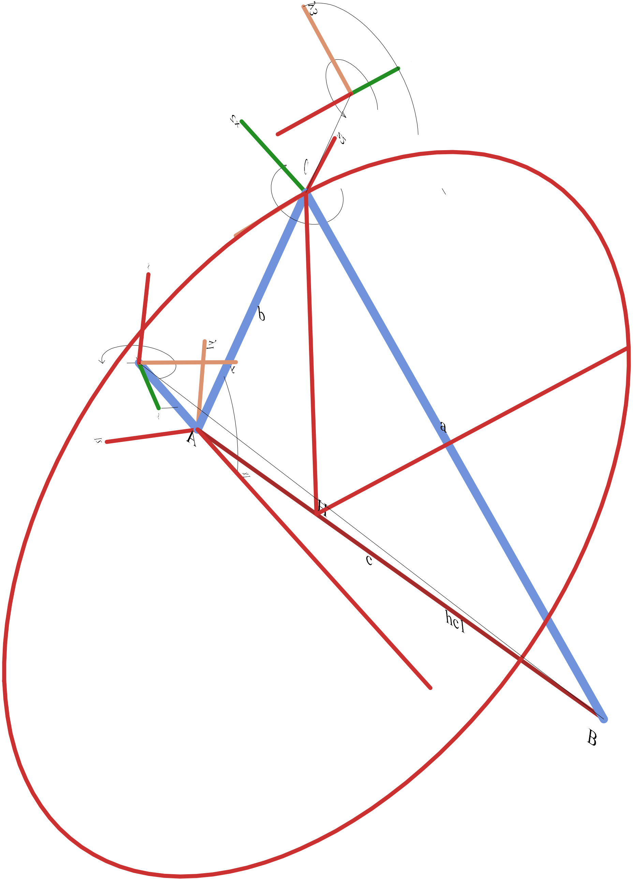
[picture p63: figure]
