jochenalt/Pentapod-Design/docs/images/illustration.pdf

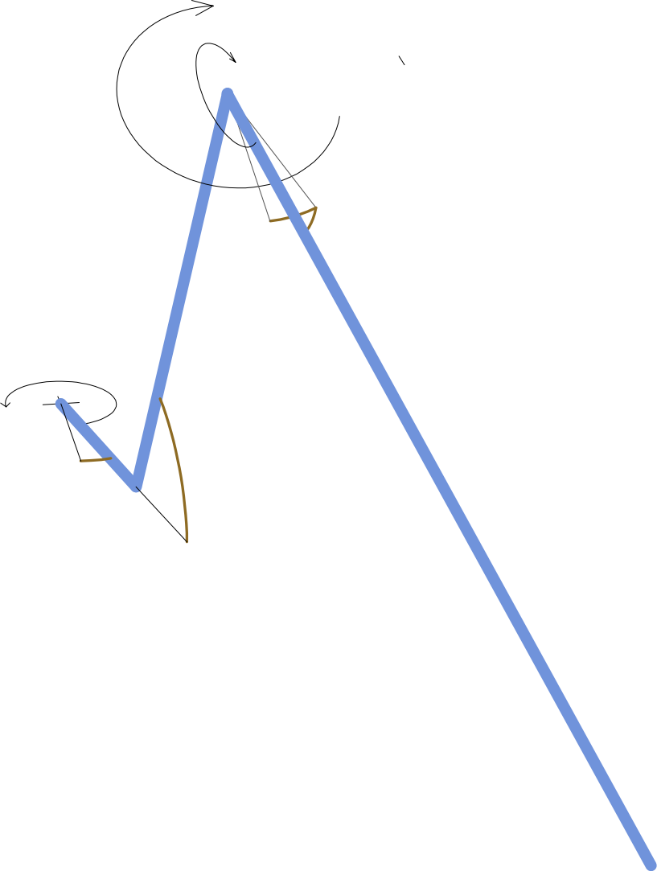
[picture p64: figure]
