jochenalt/Pentapod-Design/theory/Kinematik.xlsx

Sheet: Leg Kinematic 2
Forward kinematics
 |  |  |  |  |  |  |  |  |  |  |  |  |  |  |  |  |  |  |  | Top view
 |  |  |  |  |  |  |  |  |  |  |  |  |  |  |  |  |  |  |  | x | 0 | 29.1 | 87.6 | 87.6 | #VALUE!
 |  |  |  |  |  |  |  |  |  |  |  |  |  |  |  |  |  |  |  | y | 0 | -34.7 | -104.4 | -104.4 | #VALUE!
 |  |  |  |  |  |  |  |  |  |  |  |  |  |  |  |  |  |  |  | Front view
 |  |  |  |  |  |  |  |  |  |  |  |  |  |  |  |  |  |  |  | x | 0 | 29.1 | 87.6 | 87.6 | #VALUE!
 |  |  |  |  |  |  |  |  |  |  |  |  |  |  |  |  |  |  |  | z | 0 | 0.0 | -108.4 | -108.4 | #VALUE!
 |  |  |  |  |  |  |  |  |  |  |  |  |  |  |  |  |  |  |  |  |  | Achtung: in Excel ARCTAN2(x;y) entspricht ARCTAN(y/x) (falschrum!)
 |  |  |  |  |  |  |  |  |  |  |  |  |  |  |  |  |  |  |  |  | H | C | S | T
 |  |  |  |  |  |  |  |  |  |  |  |  |  |  |  |  |  |  |  | x | #VALUE! | #VALUE! | #VALUE! | #VALUE!
 |  |  |  |  |  |  |  |  |  |  |  |  |  |  |  |  |  |  |  | y | #VALUE! | #VALUE! | #VALUE! | #VALUE!
 |  |  |  |  |  |  |  |  |  |  |  |  |  |  |  |  |  |  |  | z | #VALUE! | #VALUE! | #VALUE! | #VALUE!
 |  |  |  |  | Inverse Kinematics |  |  |  | Euler Angles
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
