jochenalt/Pentapod-Design/datasheets/Adafruit_BNO055_Pin_Layout.jpg

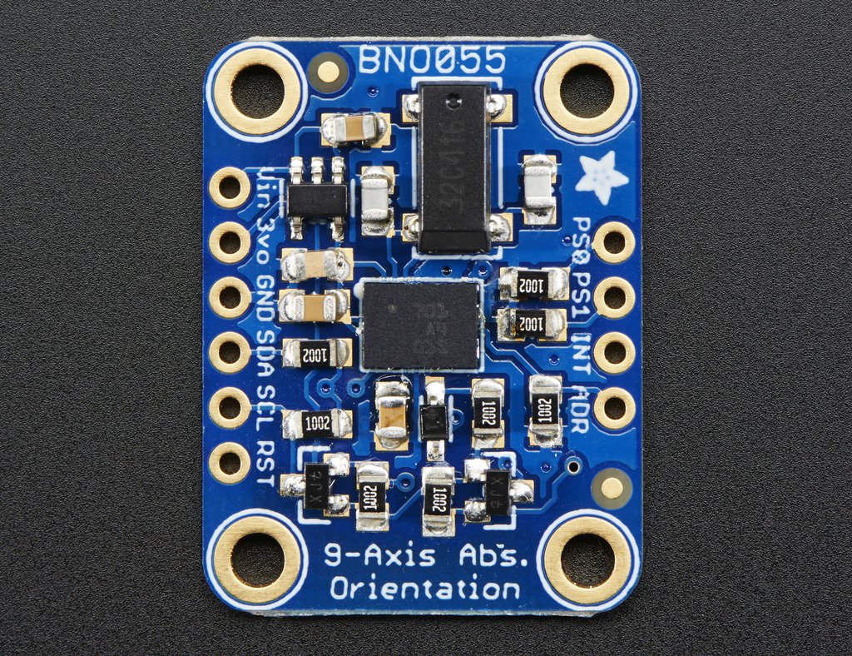
datasheets/Adafruit_BNO055_Pin_Layout.jpg
