jochenalt/Pentapod-Design/datasheets/ATMEGA328-900 PINs.png

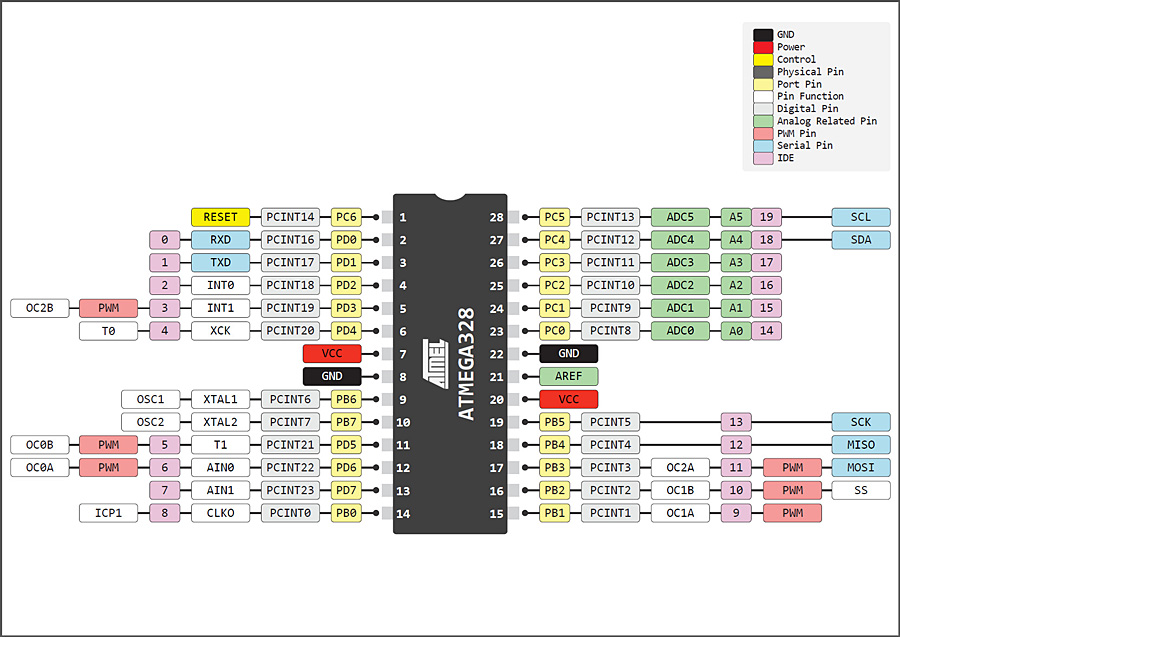
datasheets/ATMEGA328-900 PINs.png
