jochenalt/Pentapod-Design/datasheets/Odroid xu4 con10 30-pin socket Layout.png

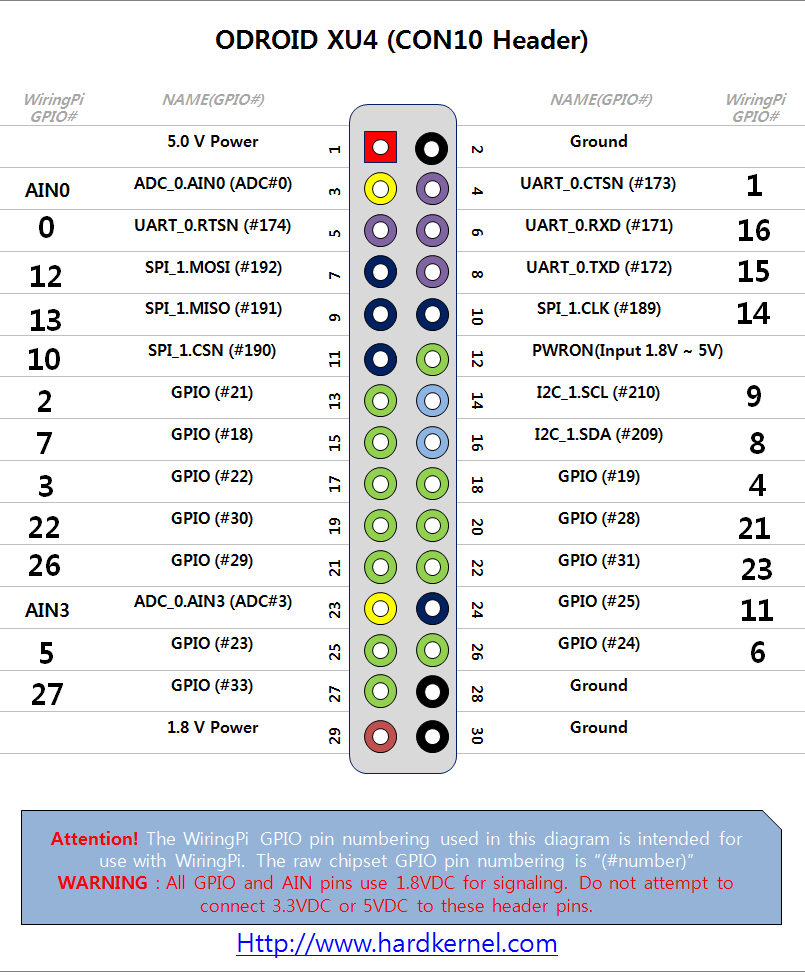
datasheets/Odroid xu4 con10 30-pin socket Layout.png
