jochenalt/Pentapod-Design/datasheets/Odroid xu4 con11 12-pin socket Layout.png

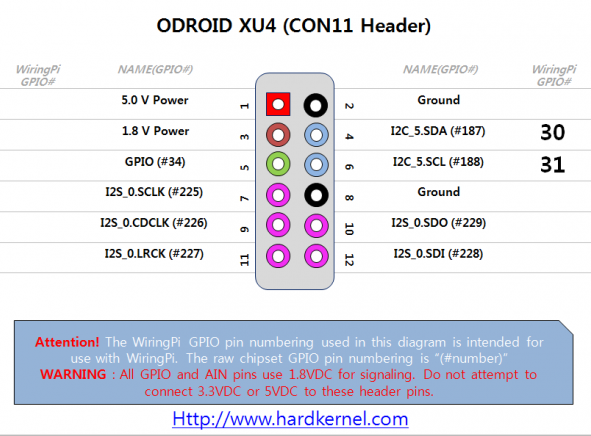
datasheets/Odroid xu4 con11 12-pin socket Layout.png
