jochenalt/Pentapod-Design/docs/images/cad-leg-total-cut.png

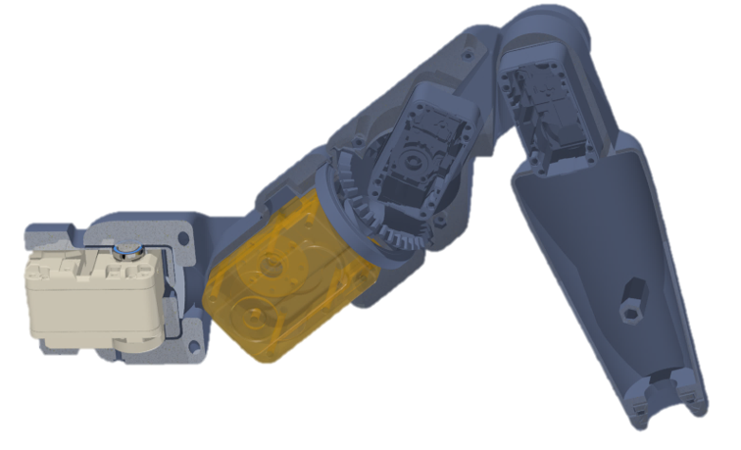
docs/images/cad-leg-total-cut.png
