jochenalt/Pentapod-Design/docs/images/Herkulex-0401-Socket.png

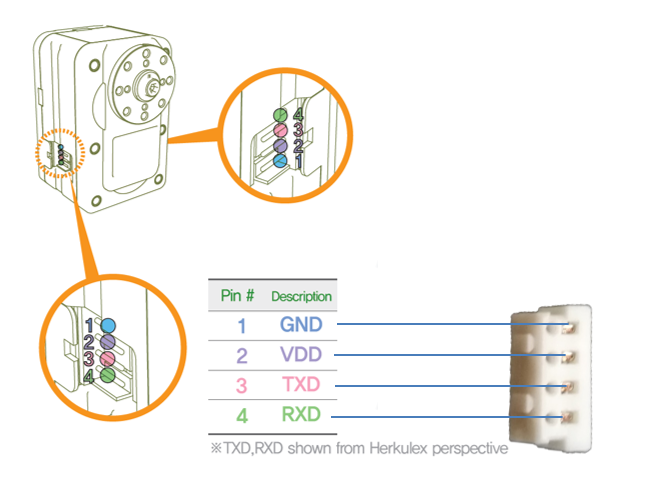
docs/images/Herkulex-0401-Socket.png
