jochenalt/Pentapod-Design/docs/images/SensorAdapter PCB.jpg

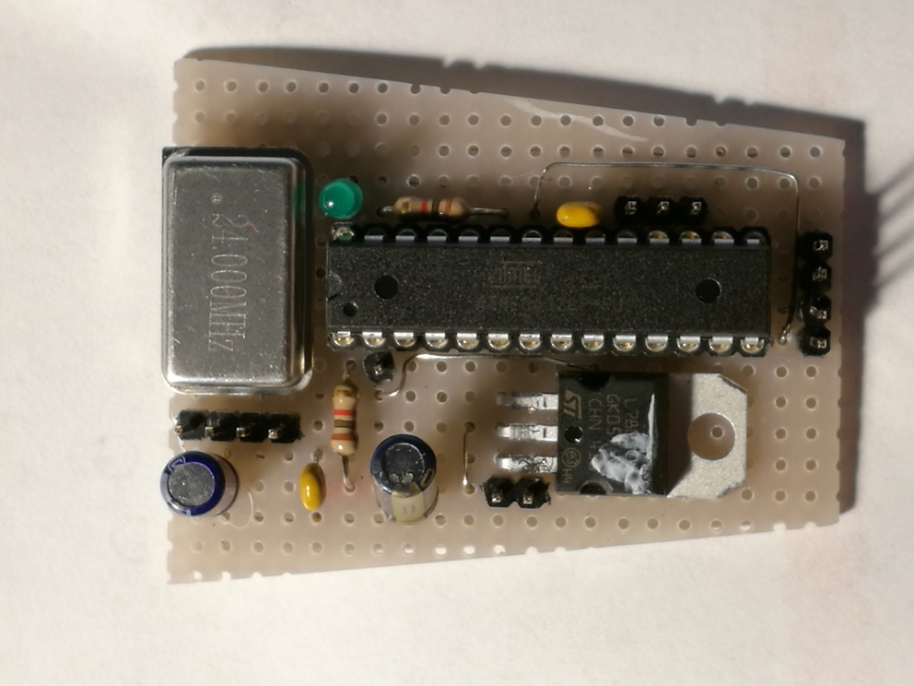
docs/images/SensorAdapter PCB.jpg
