jochenalt/Pentapod-Design/docs/images/wave-gait.png

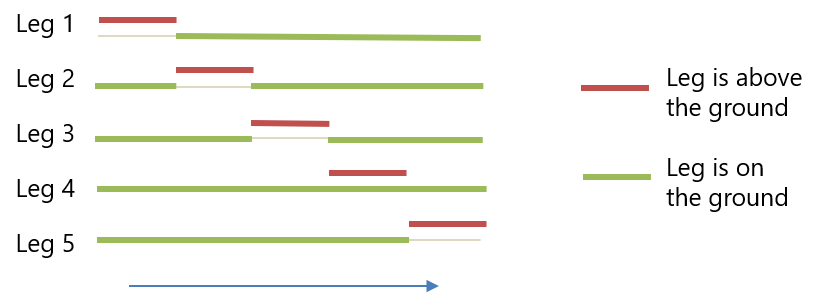
docs/images/wave-gait.png
