jochenalt/Pentapod-Design/docs/bill-of-material.md

## Components

|Category |  #| What | | Supplier |
|:---|--:|:---|:---|:---|
|3D Print | 1 | ABS 3D printer |  | [Zortrax M200](https://store.zortrax.com/M200) |
| | | Petroleum, Acetone |  | Local Dealer | 																																			 |
|Electronics | 1 | ODroid C2, 1.5 GHz Quadcore board |  |  [ODroid C2](http://www.hardkernel.com/main/products/prdt_info.php?g_code=G145457216438) |
| | 1 | Teensy 3.5, Arm M4 board |  | [Teensy 3.5](https://www.pjrc.com/store/teensy35.html ) |
| | 5 | Distance Sensors VL6180X						 |  | [Adafruit VL6180X](https://www.adafruit.com/product/3316  ) |
| | 1 | Step down voltage converter, 5V, 5A |  | [Pololu D24V50F5](https://www.pololu.com/product/2851 )  |
| | 1 | Step down voltage converter, 5A, adjustable | | [XL4016](http://www.xcluma.com/xl4015-5a-dc-dc-step-down-adjustable-power-supply-buck-module)  |
| | 1 | IMU BNO055 |  | [Adafruit  BNO055](https://www.adafruit.com/product/2472 )  |
|Servos |10 | Hip and Knee Servo, 1.2 Nm 						 |  | [HerkuleX DRS-0101](http://www.francerobotique.com/servomoteurs-intelligents/175-herkulex-drs-0101.html )  |
| | 5 | Foot Servo 2.4 Nm 					 |  | [Herkulex DRS-0201](http://www.francerobotique.com/servomoteurs-intelligents/176-herkulex-drs-0201.html) |
| | 5 | Thigh Servo, 5.2Nm 							 |  | [Herkulex DRS-0401](http://www.francerobotique.com/servomoteurs-intelligents/177-herkulex-drs-0401.html)  |
| | 10 | Additional Servo Cables 300mm  					 |  | [Cable 300mm](http://www.francerobotique.com/connectiques-c%C3%A2bles/236-4-c%C3%A2bles-4p-300mm.html) |
| | 10 | Additional Servo Cables 200mm			 	 |  | [Cable 200mm](http://www.francerobotique.com/connectiques-c%C3%A2bles/235-8-c%C3%A2bles-4p-200mm.html) |
|Mechanical Stuff |30 | distance sleeve M2 5mm							 |  | [M2 5mm](https://www.tme.eu/de/details/tff-m2x5_dr111/distanzelemente-aus-metall/dremec/111x05/) |
| |20 | deep groove ball bearing  11x7x3 mm				 |  | [11x7x3](https://www.kugellager-express.de/miniatur-kugellager-mr117-zz-7x11x3-mm) |
| |5 | deep groove ball bearing 35x44x5 mm				 |  | [35x44x5](https://www.kugellager-express.de/rillenkugellager-6707-2rs-61707-2rs-35x44x5-mm) |
| |some| allen screws M2 of length 6,8,10 	 |   | [allen screws](http://www.ebay.de/itm/272073684666?var=571251898594) |
| |40| allen screws M2.6 x 4mm (for DRS-0401 servo, they should be included. They are hard to get, 2.6x5mm works too) |  | [allen screws](https://www.graupner.de/Zylinderkopf-Schraube-M2-6x5-Innensechskant-10-Stueck/H32205/) |
| Batteries |4 | LiPO Battery, size 18650 |  | [3500mAh,3C,10A ](https://www.akkuteile.de/lg-inr18650mj1-3500mah-3-75v-lithium-akku/a-100697/) |
| |4 | battery clips | | [clips](https://www.amazon.de/gp/product/B00GN3PN46/ref=oh_aui_detailpage_o00_s00?ie=UTF8&psc=1) |

## Source code

|Category |  Description | Source |
|:---|:---|:---|
|CAD Model | Inventor: Body and leg design | [Github Pentapod CAD](https://github.com/jochenalt/Pentapod-Design/tree/master/cad/Inventor) |
| | 3D printable files of body and legs parts | [Github Pentapod STL](https://github.com/jochenalt/Pentapod-Design/tree/master/cad/stl) |
| | Simplified STL files to be used in openGL | [Github Pentapod Simplified STL](https://github.com/jochenalt/Pentapod-Design/tree/master/cad/simplified) |
|Electronics | KiCad Schematics and PCB of Cortex and Power Supply | [Github Cortex Schematics](https://github.com/jochenalt/Pentapod-Design/tree/master/schematics/CortexBoard%2040x) |
| | KiCad Schematics and PCB of Sensor Board | [Github Sensor Schematics](https://github.com/jochenalt/Pentapod-Design/tree/master/schematics/SensorAdapter) |
|Source Code | Sensor: Arduino C++ code running on ATMega8, IDE Atmel Studio | [Github SensorAdapter](https://github.com/jochenalt/Pentapod-Code/tree/master/Sensor) |
| | Cortex: Arduino C++ code running on Teensy 3.5, IDE Eclipse Sloeber | [Github Cortex](https://github.com/jochenalt/Pentapod-Code/tree/master/Cortex) |
| | Brain: ROS/Ubuntu C++ code running on Odroid C2, IDE Eclipse | [Github ROS Nodes](https://github.com/jochenalt/Pentapod-Code/tree/master/ros/src) |

## Tools
|Category |  Description | Source |
|:---|:---|:---|
|Herkulex Manager | Tool to setup a HerkuleX servo. |  [HerkuleX Manager](http://www.dongburobot.com/jsp/board/boardDown.jsp?bseq=6783)  |
|IDE for Teensy | Eclipse derivate to develop and deploy in C++ on Teensy |  [Eclipse Sloeber](http://eclipse.baeyens.it) |
|IDE for Senor Board | Visual Studio derivate to develop on Atmel/AVR |  [Atmel Studio](http://www.atmel.com/microsite/atmel-studio/) |
|ROS Kinetic | ROS Version I used. Although the newer *lunar* is out for a while, some tools required (e.g. hector slam) are not yet available on Lunar. So, I went with the elder version |  [ROS Kinetic](http://wiki.ros.org/kinetic) |
