jochenalt/Pentapod-Design/Pentapod Bom.xlsx

Sheet: BOM
# | What | What for | Source | Pieces in Pack | Price | Sum
1 | Odroid C2 Quadcore 1.5Ghz | SLAM, trajectory planning | http://www.pollin.de/shop/dt/ODA1OTgxOTk-/Bauelemente_Bauteile/Entwicklerboards/Odroid/ODROID_C2_Einplatinen_Computer_1_5_GHz_QuadCore_2_GB_RAM_4x_USB.html | 1 | 59.00 € | 59.00 €
5 | Proximity Sensor | Foot distance sensor | http://www.exp-tech.de/adafruit-vl6180x-time-of-flight-distance-ranging-sensor-vl6180 | 1 | 13.95 € | 69.75 €
1 | Adafruit BNO055 | IMU to keep lidar horizontal | http://www.exp-tech.de/adafruit-9-dof-absolute-orientation-imu-fusion-breakout-bno055 | 1 | 39.95 € | 39.95 €
1 | Teensy 3.5 | Servo control | http://www.exp-tech.de/teensy-3-5 | 1 | 29.95 € | 29.95 €
1 | Step Down Voltage Regulator 5V 5A | Odroid and Teensy power supply | http://www.exp-tech.de/pololu-5v-5a-step-down-voltage-regulator-d24v50f5 | 1 | 14.95 € | 14.95 €
1 | Step Down Voltage Regulator adjustable 5A, approx. 10V for all servos besides DRS-0401 | Odroid and Teensy power supply | http://www.ebay.de/itm/DC-DC-5V-36V-to-3-3V-6V-9V-12V-24V-5A-Adjustable-Buck-Module-Step-down-Converter-/272794310331 | 1 | 14.95 € | 14.95 €
5 | Herkulex Servo DRS-0401 | Servo Thigh | http://www.francerobotique.com/servomoteurs-intelligents/177-herkulex-drs-0401.html | 1 | 212.40 € | 1062.00 €
5 | Herkulex Servo DRS-0201 | Servo Foot | http://www.francerobotique.com/servomoteurs-intelligents/176-herkulex-drs-0201.html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 | 1 | 132.00 € | 660.00 €
10 | Herkulex Servo DRS-0101 | Servo Hip and Knee | http://www.francerobotique.com/servomoteurs-intelligents/175-herkulex-drs-0101.html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 | 1 | 36.90 € | 369.00 €
2 | Servo Cables | Additional Servo cables for customized wires | http://www.francerobotique.com/connectiques-c%C3%A2bles/235-8-c%C3%A2bles-4p-200mm.html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 | 8 | 12.00 € | 24.00 €
30 | M2 10mm Distanzmuffe |  | http://www.tme.eu/de/details/tff-m2x10_dr121/distanzelemente-aus-metall/dremec/121x10/ | 1 | 0.10 € | 3.00 €
40 | M2 5mm Distanzmuffe |  | http://www.tme.eu/de/details/tff-m2x5_dr111/distanzelemente-aus-metall/dremec/111x05/ | 1 | 0.10 € | 4.00 €
20 | Rillenkugellager 11x7x3 | bearing of servo axes | https://www.kugellager-express.de/miniatur-kugellager-mr117-zz-7x11x3-mm | 1 | 1.01 € | 20.20 €
5 | Rillenkugellager 35x44x5 mm | bearing of knee | https://www.kugellager-express.de/rillenkugellager-6707-2rs-61707-2rs-35x44x5-mm | 5 | 5.66 € | 28.30 €
1 | M2 Innensechskantschrauben DIN 912 8mm |  | http://www.ebay.de/itm/272073684666?var=571251898594 | 50 | 1.49 € | 1.49 €
1 | M2 Innensechskantschrauben DIN 912 12mm |  | http://www.ebay.de/itm/272073684666?var=571251898594 | 50 | 1.49 € | 1.49 €
1 | M2 Innensechskantschrauben DIN 912 16mm |  | http://www.ebay.de/itm/272073684666?var=571251898594 | 50 | 1.49 € | 1.49 €
1 | M2 Innensechskantschrauben DIN 912 16mm |  | http://www.ebay.de/itm/272073684666?var=571251898594 | 50 | 1.49 € | 1.49 €
1 | M2 Innensechskantschrauben DIN 912 20mm |  | http://www.ebay.de/itm/272073684666?var=571251898594 | 50 | 1.49 € | 1.49 €
4 | LiPO Battery size 18650 3,7V, 3500mAh, 3C/10A continous load |  | https://www.akkuteile.de/lg-inr18650mj1-3500mah-3-75v-lithium-akku/a-100697/ | 4 | 5.90 € | 23.60 €
1 | Battery clips |  | https://www.amazon.de/gp/product/B00GN3PN46/ref=oh_aui_detailpage_o00_s00?ie=UTF8&psc=1 | 10 | 3.38 | 3.38 €
 |  |  | https://www.akkuteile.de/lithium-ionen-akkus/18650/efest/efest-purple-imr-18650-3500mah-3-6v-3-7v-li-ionen-flattop-ungeschuetzt/a-100612/
2 | hammertone paint black |  | https://spraydosen-online.de/epages/163795ab-5a18-407e-a089-66d03db69af9.sf/de_DE/ | 1 | 6.10 € | 12.20 €
1 | hammertone paint copper |  | https://spraydosen-online.de/epages/163795ab-5a18-407e-a089-66d03db69af9.sf/de_DE/ | 1 | 6.10 € | 6.10 €
 |  |  |  |  |  | 2451.78 €

Sheet: FootPrint
Computation of footprint (used in _common_params.yaml)
Radius | 0.4 | [m]
 | alpha
leg | 0 | 1 | 2 | 3 | 4
 | -144 | -72 | 0 | 72 | 144
x | -0.32 | 0.12 | 0.40 | 0.12 | -0.32
y | -0.24 | -0.38 | 0.00 | 0.38 | 0.24
footprint: [ [-0,32,-0,24], [0,12,-0,38], [0,4,0], [0,12,0,38], [-0,32,0,24]]

Sheet: DIN
Kugelkopf M3 2 mm Duraluminium

Sheet: RAL-Basic
1000 | Green beige | 204 204 153
 |  | CCCC99
1001 | Beige | 210 170 90
 |  | D2AA5A
1002 | Sand yellow | 208 168 24
 |  | D0A818
1003 | Signal yellow | 255 204 0
 |  | FFCC00
1004 | Golden yellow | 224 176 0
 |  | E0B000
1005 | Honey yellow | 201 135 33
 |  | C98721
1006 | Maize yellow | 227 167 41
 |  | E3A729
1007 | Daffodil yellow | 221 159 35
 |  | DD9F23
1011 | Brown beige | 173 122 41
 |  | AD7A29
1012 | Lemon yellow | 227 184 56
 |  | E3B838
1013 | Oyster white | 255 245 227
 |  | FFF5E3
1014 | Ivory | 240 214 171
 |  | F0D6AB
1015 | Light ivory | 252 235 204
 |  | FCEBCC
1016 | Sulfur yellow | 255 245 66
 |  | FFF542
1017 | Saffron yellow | 255 171 89
 |  | FFAB59
1018 | Zinc yellow | 255 214 77
 |  | FFD64D
1019 | Grey beige | 163 140 122
 |  | A38C7A
1020 | Olive yellow | 156 143 97
 |  | 9C8F61
1021 | Rape yellow | 252 189 31
 |  | FCBD1F
1023 | Traffic yellow | 252 189 31
 |  | FCBD1F
1024 | Ochre yellow | 181 140 79
 |  | B58C4F
1026 | Luminous yellow | 255 255 10
 |  | FFFF0A
1027 | Curry | 153 117 33
 |  | 997521
1028 | Melon yellow | 255 140 26
 |  | FF8C1A
1032 | Broom yellow | 227 163 41
 |  | E3A329
1033 | Dahlia yellow | 255 148 54
 |  | FF9436
1034 | Pastel yellow | 247 153 92
 |  | F7995C
2000 | Yellow orange | 224 94 31
 |  | E05E1F
2001 | Red orange | 186 46 33
 |  | BA2E21
2002 | Vermilion | 204 36 28
 |  | CC241C
2003 | Pastel orange | 255 99 54
 |  | FF6336
2004 | Pure orange | 242 59 28
 |  | F23B1C
2005 | Luminous orange | 252 28 20
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
 |  | A6ABB5
9007 | Grey aluminium | 125 122 120
 |  | 7D7A78
9010 | Pure white | 250 255 255
 |  | FAFFFF
9011 | Graphite black | 13 18 26
 |  | 0D121A
9016 | Traffic white | 252 255 255
 |  | FCFFFF
9017 | Traffic black | 20 23 28
 |  | 14171C
9018 | Papyrus white | 219 227 222
 |  | DBE3DE

Sheet: RAL
# | Name | Name | Name |  | Red | Blue | Green
1000 | Green beige | GreenBeige | GreenBeige | 204 204 153 | 204 | 204 | 153 | Green beige | #define GreenBeige ((204<<16) + ( 204<<8) + 153 )
1001 | Beige | Beige | Beige | 210 170 90 | 210 | 170 | 90 | Beige | #define Beige ((210<<16) + ( 170<<8) + 90 )
1002 | Sand yellow | SandYellow | SandYellow | 208 168 24 | 208 | 168 | 24 | Sand yellow | #define SandYellow ((208<<16) + ( 168<<8) + 24 )
1003 | Signal yellow | SignalYellow | SignalYellow | 255 204 0 | 255 | 204 | 0 | Signal yellow | #define SignalYellow ((255<<16) + ( 204<<8) + 0 )
1004 | Golden yellow | GoldenYellow | GoldenYellow | 224 176 0 | 224 | 176 | 0 | Golden yellow | #define GoldenYellow ((224<<16) + ( 176<<8) + 0 )
1005 | Honey yellow | HoneyYellow | HoneyYellow | 201 135 33 | 201 | 135 | 33 | Honey yellow | #define HoneyYellow ((201<<16) + ( 135<<8) + 33 )
1006 | Maize yellow | MaizeYellow | MaizeYellow | 227 167 41 | 227 | 167 | 41 | Maize yellow | #define MaizeYellow ((227<<16) + ( 167<<8) + 41 )
1007 | Daffodil yellow | DaffodilYellow | DaffodilYellow | 221 159 35 | 221 | 159 | 35 | Daffodil yellow | #define DaffodilYellow ((221<<16) + ( 159<<8) + 35 )
1011 | Brown beige | BrownBeige | BrownBeige | 173 122 41 | 173 | 122 | 41 | Brown beige | #define BrownBeige ((173<<16) + ( 122<<8) + 41 )
1012 | Lemon yellow | LemonYellow | LemonYellow | 227 184 56 | 227 | 184 | 56 | Lemon yellow | #define LemonYellow ((227<<16) + ( 184<<8) + 56 )
1013 | Oyster white | OysterWhite | OysterWhite | 255 245 227 | 255 | 245 | 227 | Oyster white | #define OysterWhite ((255<<16) + ( 245<<8) + 227 )
1014 | Ivory | Ivory | Ivory | 240 214 171 | 240 | 214 | 171 | Ivory | #define Ivory ((240<<16) + ( 214<<8) + 171 )
1015 | Light ivory | LightIvory | LightIvory | 252 235 204 | 252 | 235 | 204 | Light ivory | #define LightIvory ((252<<16) + ( 235<<8) + 204 )
1016 | Sulfur yellow | SulfurYellow | SulfurYellow | 255 245 66 | 255 | 245 | 66 | Sulfur yellow | #define SulfurYellow ((255<<16) + ( 245<<8) + 66 )
1017 | Saffron yellow | SaffronYellow | SaffronYellow | 255 171 89 | 255 | 171 | 89 | Saffron yellow | #define SaffronYellow ((255<<16) + ( 171<<8) + 89 )
1018 | Zinc yellow | ZincYellow | ZincYellow | 255 214 77 | 255 | 214 | 77 | Zinc yellow | #define ZincYellow ((255<<16) + ( 214<<8) + 77 )
1019 | Grey beige | GreyBeige | GreyBeige | 163 140 122 | 163 | 140 | 122 | Grey beige | #define GreyBeige ((163<<16) + ( 140<<8) + 122 )
1020 | Olive yellow | OliveYellow | OliveYellow | 156 143 97 | 156 | 143 | 97 | Olive yellow | #define OliveYellow ((156<<16) + ( 143<<8) + 97 )
1021 | Rape yellow | RapeYellow | RapeYellow | 252 189 31 | 252 | 189 | 31 | Rape yellow | #define RapeYellow ((252<<16) + ( 189<<8) + 31 )
1023 | Traffic yellow | TrafficYellow | TrafficYellow | 252 189 31 | 252 | 189 | 31 | Traffic yellow | #define TrafficYellow ((252<<16) + ( 189<<8) + 31 )
1024 | Ochre yellow | OchreYellow | OchreYellow | 181 140 79 | 181 | 140 | 79 | Ochre yellow | #define OchreYellow ((181<<16) + ( 140<<8) + 79 )
1026 | Luminous yellow | LuminousYellow | LuminousYellow | 255 255 10 | 255 | 255 | 10 | Luminous yellow | #define LuminousYellow ((255<<16) + ( 255<<8) + 10 )
1027 | Curry | Curry | Curry | 153 117 33 | 153 | 117 | 33 | Curry | #define Curry ((153<<16) + ( 117<<8) + 33 )
1028 | Melon yellow | MelonYellow | MelonYellow | 255 140 26 | 255 | 140 | 26 | Melon yellow | #define MelonYellow ((255<<16) + ( 140<<8) + 26 )
1032 | Broom yellow | BroomYellow | BroomYellow | 227 163 41 | 227 | 163 | 41 | Broom yellow | #define BroomYellow ((227<<16) + ( 163<<8) + 41 )
1033 | Dahlia yellow | DahliaYellow | DahliaYellow | 255 148 54 | 255 | 148 | 54 | Dahlia yellow | #define DahliaYellow ((255<<16) + ( 148<<8) + 54 )
1034 | Pastel yellow | PastelYellow | PastelYellow | 247 153 92 | 247 | 153 | 92 | Pastel yellow | #define PastelYellow ((247<<16) + ( 153<<8) + 92 )
2000 | Yellow orange | YellowOrange | YellowOrange | 224 94 31 | 224 | 94 | 31 | Yellow orange | #define YellowOrange ((224<<16) + ( 94<<8) + 31 )
2001 | Red orange | RedOrange | RedOrange | 186 46 33 | 186 | 46 | 33 | Red orange | #define RedOrange ((186<<16) + ( 46<<8) + 33 )
2002 | Vermilion | Vermilion | Vermilion | 204 36 28 | 204 | 36 | 28 | Vermilion | #define Vermilion ((204<<16) + ( 36<<8) + 28 )
2003 | Pastel orange | PastelOrange | PastelOrange | 255 99 54 | 255 | 99 | 54 | Pastel orange | #define PastelOrange ((255<<16) + ( 99<<8) + 54 )
2004 | Pure orange | PureOrange | PureOrange | 242 59 28 | 242 | 59 | 28 | Pure orange | #define PureOrange ((242<<16) + ( 59<<8) + 28 )
2005 | Luminous orange | LuminousOrange | LuminousOrange | 252 28 20 | 252 | 28 | 20 | Luminous orange | #define LuminousOrange ((252<<16) + ( 28<<8) + 20 )
2007 | Luminous bright orange | LuminousBright orange | LuminousBrightOrange | 255 117 33 | 255 | 117 | 33 | Luminous bright orange | #define LuminousBrightOrange ((255<<16) + ( 117<<8) + 33 )
2008 | Bright red orange | BrightRed orange | BrightRedOrange | 250 79 41 | 250 | 79 | 41 | Bright red orange | #define BrightRedOrange ((250<<16) + ( 79<<8) + 41 )
2009 | Traffic orange | TrafficOrange | TrafficOrange | 235 59 28 | 235 | 59 | 28 | Traffic orange | #define TrafficOrange ((235<<16) + ( 59<<8) + 28 )
2010 | Signal orange | SignalOrange | SignalOrange | 212 69 41 | 212 | 69 | 41 | Signal orange | #define SignalOrange ((212<<16) + ( 69<<8) + 41 )
2011 | Deep orange | DeepOrange | DeepOrange | 237 92 0 | 237 | 92 | 0 | Deep orange | #define DeepOrange ((237<<16) + ( 92<<8) + 0 )
2012 | Salmon orange | SalmonOrange | SalmonOrange | 222 82 71 | 222 | 82 | 71 | Salmon orange | #define SalmonOrange ((222<<16) + ( 82<<8) + 71 )
3000 | Flame red | FlameRed | FlameRed | 171 31 28 | 171 | 31 | 28 | Flame red | #define FlameRed ((171<<16) + ( 31<<8) + 28 )
3001 | Signal red | SignalRed | SignalRed | 163 23 26 | 163 | 23 | 26 | Signal red | #define SignalRed ((163<<16) + ( 23<<8) + 26 )
3002 | Carmine red | CarmineRed | CarmineRed | 163 26 26 | 163 | 26 | 26 | Carmine red | #define CarmineRed ((163<<16) + ( 26<<8) + 26 )
3003 | Ruby red | RubyRed | RubyRed | 138 18 20 | 138 | 18 | 20 | Ruby red | #define RubyRed ((138<<16) + ( 18<<8) + 20 )
3004 | Purple red | PurpleRed | PurpleRed | 105 15 20 | 105 | 15 | 20 | Purple red | #define PurpleRed ((105<<16) + ( 15<<8) + 20 )
3005 | Wine red | WineRed | WineRed | 79 18 26 | 79 | 18 | 26 | Wine red | #define WineRed ((79<<16) + ( 18<<8) + 26 )
3007 | Black red | BlackRed | BlackRed | 46 18 26 | 46 | 18 | 26 | Black red | #define BlackRed ((46<<16) + ( 18<<8) + 26 )
3009 | Oxide red | OxideRed | OxideRed | 94 33 33 | 94 | 33 | 33 | Oxide red | #define OxideRed ((94<<16) + ( 33<<8) + 33 )
3011 | Brown red | BrownRed | BrownRed | 120 20 23 | 120 | 20 | 23 | Brown red | #define BrownRed ((120<<16) + ( 20<<8) + 23 )
3012 | Beige red | BeigeRed | BeigeRed | 204 130 115 | 204 | 130 | 115 | Beige red | #define BeigeRed ((204<<16) + ( 130<<8) + 115 )
3013 | Tomato red | TomatoRed | TomatoRed | 150 31 28 | 150 | 31 | 28 | Tomato red | #define TomatoRed ((150<<16) + ( 31<<8) + 28 )
3014 | Antique pink | AntiquePink | AntiquePink | 217 102 117 | 217 | 102 | 117 | Antique pink | #define AntiquePink ((217<<16) + ( 102<<8) + 117 )
3015 | Light pink | LightPink | LightPink | 232 156 181 | 232 | 156 | 181 | Light pink | #define LightPink ((232<<16) + ( 156<<8) + 181 )
3016 | Coral red | CoralRed | CoralRed | 166 36 38 | 166 | 36 | 38 | Coral red | #define CoralRed ((166<<16) + ( 36<<8) + 38 )
3017 | Rose | Rose | Rose | 209 54 84 | 209 | 54 | 84 | Rose | #define Rose ((209<<16) + ( 54<<8) + 84 )
3018 | Strawberry red | StrawberryRed | StrawberryRed | 207 41 66 | 207 | 41 | 66 | Strawberry red | #define StrawberryRed ((207<<16) + ( 41<<8) + 66 )
3020 | Traffic red | TrafficRed | TrafficRed | 199 23 18 | 199 | 23 | 18 | Traffic red | #define TrafficRed ((199<<16) + ( 23<<8) + 18 )
3022 | Salmon pink | SalmonPink | SalmonPink | 217 89 79 | 217 | 89 | 79 | Salmon pink | #define SalmonPink ((217<<16) + ( 89<<8) + 79 )
3024 | Luminous red | LuminousRed | LuminousRed | 252 10 28 | 252 | 10 | 28 | Luminous red | #define LuminousRed ((252<<16) + ( 10<<8) + 28 )
3026 | Luminous bright red | LuminousBright red | LuminousBrightRed | 252 20 20 | 252 | 20 | 20 | Luminous bright red | #define LuminousBrightRed ((252<<16) + ( 20<<8) + 20 )
3027 | Raspberry red | RaspberryRed | RaspberryRed | 181 18 51 | 181 | 18 | 51 | Raspberry red | #define RaspberryRed ((181<<16) + ( 18<<8) + 51 )
3031 | Orient red | OrientRed | OrientRed | 166 28 46 | 166 | 28 | 46 | Orient red | #define OrientRed ((166<<16) + ( 28<<8) + 46 )
4001 | Red lilac | RedLilac | RedLilac | 130 64 48 | 130 | 64 | 48 | Red lilac | #define RedLilac ((130<<16) + ( 64<<8) + 48 )
4002 | Red violet | RedViolet | RedViolet | 143 38 64 | 143 | 38 | 64 | Red violet | #define RedViolet ((143<<16) + ( 38<<8) + 64 )
4003 | Heather violet | HeatherViolet | HeatherViolet | 201 56 140 | 201 | 56 | 140 | Heather violet | #define HeatherViolet ((201<<16) + ( 56<<8) + 140 )
4004 | Claret violet | ClaretViolet | ClaretViolet | 92 8 43 | 92 | 8 | 43 | Claret violet | #define ClaretViolet ((92<<16) + ( 8<<8) + 43 )
4005 | Blue lilac | BlueLilac | BlueLilac | 99 61 156 | 99 | 61 | 156 | Blue lilac | #define BlueLilac ((99<<16) + ( 61<<8) + 156 )
4006 | Traffic purple | TrafficPurple | TrafficPurple | 145 15 102 | 145 | 15 | 102 | Traffic purple | #define TrafficPurple ((145<<16) + ( 15<<8) + 102 )
4007 | Purple violet | PurpleViolet | PurpleViolet | 56 10 46 | 56 | 10 | 46 | Purple violet | #define PurpleViolet ((56<<16) + ( 10<<8) + 46 )
4008 | Signal violet | SignalViolet | SignalViolet | 125 31 122 | 125 | 31 | 122 | Signal violet | #define SignalViolet ((125<<16) + ( 31<<8) + 122 )
4009 | Pastel violet | PastelViolet | PastelViolet | 158 115 148 | 158 | 115 | 148 | Pastel violet | #define PastelViolet ((158<<16) + ( 115<<8) + 148 )
4010 | Telemagenta | Telemagenta | Telemagenta | 191 23 115 | 191 | 23 | 115 | Telemagenta | #define Telemagenta ((191<<16) + ( 23<<8) + 115 )
5000 | Violet blue | VioletBlue | VioletBlue | 23 51 107 | 23 | 51 | 107 | Violet blue | #define VioletBlue ((23<<16) + ( 51<<8) + 107 )
5001 | Green blue | GreenBlue | GreenBlue | 10 51 84 | 10 | 51 | 84 | Green blue | #define GreenBlue ((10<<16) + ( 51<<8) + 84 )
5002 | Ultramarine blue | UltramarineBlue | UltramarineBlue | 0 15 117 | 0 | 15 | 117 | Ultramarine blue | #define UltramarineBlue ((0<<16) + ( 15<<8) + 117 )
5003 | Sapphire blue | SapphireBlue | SapphireBlue | 0 23 69 | 0 | 23 | 69 | Sapphire blue | #define SapphireBlue ((0<<16) + ( 23<<8) + 69 )
5004 | Black blue | BlackBlue | BlackBlue | 3 13 31 | 3 | 13 | 31 | Black blue | #define BlackBlue ((3<<16) + ( 13<<8) + 31 )
5005 | Signal blue | SignalBlue | SignalBlue | 0 46 122 | 0 | 46 | 122 | Signal blue | #define SignalBlue ((0<<16) + ( 46<<8) + 122 )
5007 | Brillant blue | BrillantBlue | BrillantBlue | 38 79 135 | 38 | 79 | 135 | Brillant blue | #define BrillantBlue ((38<<16) + ( 79<<8) + 135 )
5008 | Gray blue | GrayBlue | GrayBlue | 26 41 56 | 26 | 41 | 56 | Gray blue | #define GrayBlue ((26<<16) + ( 41<<8) + 56 )
5009 | Azure blue | AzureBlue | AzureBlue | 23 69 112 | 23 | 69 | 112 | Azure blue | #define AzureBlue ((23<<16) + ( 69<<8) + 112 )
5011 | Steel blue | SteelBlue | SteelBlue | 0 43 112 | 0 | 43 | 112 | Steel blue | #define SteelBlue ((0<<16) + ( 43<<8) + 112 )
5012 | Light blue | LightBlue | LightBlue | 41 115 184 | 41 | 115 | 184 | Light blue | #define LightBlue ((41<<16) + ( 115<<8) + 184 )
5013 | Cobalt blue | CobaltBlue | CobaltBlue | 0 18 69 | 0 | 18 | 69 | Cobalt blue | #define CobaltBlue ((0<<16) + ( 18<<8) + 69 )
5014 | Pigeon blue | PigeonBlue | PigeonBlue | 77 105 153 | 77 | 105 | 153 | Pigeon blue | #define PigeonBlue ((77<<16) + ( 105<<8) + 153 )
5015 | Sky blue | SkyBlue | SkyBlue | 23 97 171 | 23 | 97 | 171 | Sky blue | #define SkyBlue ((23<<16) + ( 97<<8) + 171 )
5017 | Traffic blue | TrafficBlue | TrafficBlue | 0 59 128 | 0 | 59 | 128 | Traffic blue | #define TrafficBlue ((0<<16) + ( 59<<8) + 128 )
5018 | Turquoise blue | TurquoiseBlue | TurquoiseBlue | 56 148 130 | 56 | 148 | 130 | Turquoise blue | #define TurquoiseBlue ((56<<16) + ( 148<<8) + 130 )
5019 | Capri blue | CapriBlue | CapriBlue | 10 66 120 | 10 | 66 | 120 | Capri blue | #define CapriBlue ((10<<16) + ( 66<<8) + 120 )
5020 | Steel blue | SteelBlue | SteelBlue | 5 51 51 | 5 | 51 | 51 | Steel blue | #define SteelBlue ((5<<16) + ( 51<<8) + 51 )
5021 | Water blue | WaterBlue | WaterBlue | 26 122 99 | 26 | 122 | 99 | Water blue | #define WaterBlue ((26<<16) + ( 122<<8) + 99 )
5022 | Night blue | NightBlue | NightBlue | 0 8 79 | 0 | 8 | 79 | Night blue | #define NightBlue ((0<<16) + ( 8<<8) + 79 )
5023 | Distant blue | DistantBlue | DistantBlue | 46 82 143 | 46 | 82 | 143 | Distant blue | #define DistantBlue ((46<<16) + ( 82<<8) + 143 )
5024 | Pastel blue | PastelBlue | PastelBlue | 87 140 171 | 87 | 140 | 171 | Pastel blue | #define PastelBlue ((87<<16) + ( 140<<8) + 171 )
6000 | Patina green | PatinaGreen | PatinaGreen | 51 120 84 | 51 | 120 | 84 | Patina green | #define PatinaGreen ((51<<16) + ( 120<<8) + 84 )
6001 | Emerald green | EmeraldGreen | EmeraldGreen | 38 102 81 | 38 | 102 | 81 | Emerald green | #define EmeraldGreen ((38<<16) + ( 102<<8) + 81 )
6002 | Leaf green | LeafGreen | LeafGreen | 38 87 33 | 38 | 87 | 33 | Leaf green | #define LeafGreen ((38<<16) + ( 87<<8) + 33 )
6003 | Olive green | OliveGreen | OliveGreen | 61 69 46 | 61 | 69 | 46 | Olive green | #define OliveGreen ((61<<16) + ( 69<<8) + 46 )
6004 | Blue green | BlueGreen | BlueGreen | 13 59 46 | 13 | 59 | 46 | Blue green | #define BlueGreen ((13<<16) + ( 59<<8) + 46 )
6005 | Moss green | MossGreen | MossGreen | 10 56 31 | 10 | 56 | 31 | Moss green | #define MossGreen ((10<<16) + ( 56<<8) + 31 )
6006 | Grey olive | GreyOlive | GreyOlive | 41 43 46 | 41 | 43 | 46 | Grey olive | #define GreyOlive ((41<<16) + ( 43<<8) + 46 )
6007 | Bottle green | BottleGreen | BottleGreen | 28 38 23 | 28 | 38 | 23 | Bottle green | #define BottleGreen ((28<<16) + ( 38<<8) + 23 )
6008 | Brown green | BrownGreen | BrownGreen | 33 33 26 | 33 | 33 | 26 | Brown green | #define BrownGreen ((33<<16) + ( 33<<8) + 26 )
6009 | Fir green | FirGreen | FirGreen | 23 41 28 | 23 | 41 | 28 | Fir green | #define FirGreen ((23<<16) + ( 41<<8) + 28 )
6010 | Grass green | GrassGreen | GrassGreen | 54 105 38 | 54 | 105 | 38 | Grass green | #define GrassGreen ((54<<16) + ( 105<<8) + 38 )
6011 | Reseda green | ResedaGreen | ResedaGreen | 94 125 79 | 94 | 125 | 79 | Reseda green | #define ResedaGreen ((94<<16) + ( 125<<8) + 79 )
6012 | Black green | BlackGreen | BlackGreen | 31 46 43 | 31 | 46 | 43 | Black green | #define BlackGreen ((31<<16) + ( 46<<8) + 43 )
6013 | Reed green | ReedGreen | ReedGreen | 117 115 79 | 117 | 115 | 79 | Reed green | #define ReedGreen ((117<<16) + ( 115<<8) + 79 )
6014 | Yellow olive | YellowOlive | YellowOlive | 51 48 38 | 51 | 48 | 38 | Yellow olive | #define YellowOlive ((51<<16) + ( 48<<8) + 38 )
6015 | Black olive | BlackOlive | BlackOlive | 41 43 38 | 41 | 43 | 38 | Black olive | #define BlackOlive ((41<<16) + ( 43<<8) + 38 )
6016 | Turquoise green | TurquoiseGreen | TurquoiseGreen | 15 112 51 | 15 | 112 | 51 | Turquoise green | #define TurquoiseGreen ((15<<16) + ( 112<<8) + 51 )
6017 | Yellow green | YellowGreen | YellowGreen | 64 130 54 | 64 | 130 | 54 | Yellow green | #define YellowGreen ((64<<16) + ( 130<<8) + 54 )
6018 | May green | MayGreen | MayGreen | 79 168 51 | 79 | 168 | 51 | May green | #define MayGreen ((79<<16) + ( 168<<8) + 51 )
6019 | Pastel green | PastelGreen | PastelGreen | 191 227 186 | 191 | 227 | 186 | Pastel green | #define PastelGreen ((191<<16) + ( 227<<8) + 186 )
6020 | Chrome green | ChromeGreen | ChromeGreen | 38 56 41 | 38 | 56 | 41 | Chrome green | #define ChromeGreen ((38<<16) + ( 56<<8) + 41 )
6021 | Pale green | PaleGreen | PaleGreen | 133 166 122 | 133 | 166 | 122 | Pale green | #define PaleGreen ((133<<16) + ( 166<<8) + 122 )
6022 | Olive drab | OliveDrab | OliveDrab | 43 38 28 | 43 | 38 | 28 | Olive drab | #define OliveDrab ((43<<16) + ( 38<<8) + 28 )
6024 | Traffic green | TrafficGreen | TrafficGreen | 36 145 64 | 36 | 145 | 64 | Traffic green | #define TrafficGreen ((36<<16) + ( 145<<8) + 64 )
6025 | Fern green | FernGreen | FernGreen | 74 110 51 | 74 | 110 | 51 | Fern green | #define FernGreen ((74<<16) + ( 110<<8) + 51 )
6026 | Opal green | OpalGreen | OpalGreen | 10 92 51 | 10 | 92 | 51 | Opal green | #define OpalGreen ((10<<16) + ( 92<<8) + 51 )
6027 | Light green | LightGreen | LightGreen | 125 204 189 | 125 | 204 | 189 | Light green | #define LightGreen ((125<<16) + ( 204<<8) + 189 )
6028 | Pine green | PineGreen | PineGreen | 38 74 51 | 38 | 74 | 51 | Pine green | #define PineGreen ((38<<16) + ( 74<<8) + 51 )
6029 | Mint green | MintGreen | MintGreen | 18 120 38 | 18 | 120 | 38 | Mint green | #define MintGreen ((18<<16) + ( 120<<8) + 38 )
6032 | Signal green | SignalGreen | SignalGreen | 41 138 64 | 41 | 138 | 64 | Signal green | #define SignalGreen ((41<<16) + ( 138<<8) + 64 )
6033 | Mint turquoise | MintTurquoise | MintTurquoise | 66 140 120 | 66 | 140 | 120 | Mint turquoise | #define MintTurquoise ((66<<16) + ( 140<<8) + 120 )
6034 | Pastel turquoise | PastelTurquoise | PastelTurquoise | 125 189 181 | 125 | 189 | 181 | Pastel turquoise | #define PastelTurquoise ((125<<16) + ( 189<<8) + 181 )
7000 | Squirrel grey | SquirrelGrey | SquirrelGrey | 115 133 145 | 115 | 133 | 145 | Squirrel grey | #define SquirrelGrey ((115<<16) + ( 133<<8) + 145 )
7001 | Silver grey | SilverGrey | SilverGrey | 135 148 166 | 135 | 148 | 166 | Silver grey | #define SilverGrey ((135<<16) + ( 148<<8) + 166 )
7002 | Olive grey | OliveGrey | OliveGrey | 122 117 97 | 122 | 117 | 97 | Olive grey | #define OliveGrey ((122<<16) + ( 117<<8) + 97 )
7003 | Moss grey | MossGrey | MossGrey | 112 112 97 | 112 | 112 | 97 | Moss grey | #define MossGrey ((112<<16) + ( 112<<8) + 97 )
7004 | Signal grey | SignalGrey | SignalGrey | 156 156 166 | 156 | 156 | 166 | Signal grey | #define SignalGrey ((156<<16) + ( 156<<8) + 166 )
7005 | Mouse grey | MouseGrey | MouseGrey | 97 105 105 | 97 | 105 | 105 | Mouse grey | #define MouseGrey ((97<<16) + ( 105<<8) + 105 )
7006 | Beige grey | BeigeGrey | BeigeGrey | 107 97 87 | 107 | 97 | 87 | Beige grey | #define BeigeGrey ((107<<16) + ( 97<<8) + 87 )
7008 | Khaki grey | KhakiGrey | KhakiGrey | 105 84 56 | 105 | 84 | 56 | Khaki grey | #define KhakiGrey ((105<<16) + ( 84<<8) + 56 )
7009 | Green grey | GreenGrey | GreenGrey | 77 82 74 | 77 | 82 | 74 | Green grey | #define GreenGrey ((77<<16) + ( 82<<8) + 74 )
7010 | Tarpaulin grey | TarpaulinGrey | TarpaulinGrey | 74 79 74 | 74 | 79 | 74 | Tarpaulin grey | #define TarpaulinGrey ((74<<16) + ( 79<<8) + 74 )
7011 | Iron grey | IronGrey | IronGrey | 64 74 84 | 64 | 74 | 84 | Iron grey | #define IronGrey ((64<<16) + ( 74<<8) + 84 )
7012 | Basalt grey | BasaltGrey | BasaltGrey | 74 84 89 | 74 | 84 | 89 | Basalt grey | #define BasaltGrey ((74<<16) + ( 84<<8) + 89 )
7013 | Brown grey | BrownGrey | BrownGrey | 71 66 56 | 71 | 66 | 56 | Brown grey | #define BrownGrey ((71<<16) + ( 66<<8) + 56 )
7015 | Slate grey | SlateGrey | SlateGrey | 61 66 82 | 61 | 66 | 82 | Slate grey | #define SlateGrey ((61<<16) + ( 66<<8) + 82 )
7016 | Anthracite grey | AnthraciteGrey | AnthraciteGrey | 38 46 56 | 38 | 46 | 56 | Anthracite grey | #define AnthraciteGrey ((38<<16) + ( 46<<8) + 56 )
7021 | Black grey | BlackGrey | BlackGrey | 26 33 41 | 26 | 33 | 41 | Black grey | #define BlackGrey ((26<<16) + ( 33<<8) + 41 )
7022 | Umbra grey | UmbraGrey | UmbraGrey | 61 61 59 | 61 | 61 | 59 | Umbra grey | #define UmbraGrey ((61<<16) + ( 61<<8) + 59 )
7023 | Concrete grey | ConcreteGrey | ConcreteGrey | 122 125 117 | 122 | 125 | 117 | Concrete grey | #define ConcreteGrey ((122<<16) + ( 125<<8) + 117 )
7024 | Graphite grey | GraphiteGrey | GraphiteGrey | 48 56 69 | 48 | 56 | 69 | Graphite grey | #define GraphiteGrey ((48<<16) + ( 56<<8) + 69 )
7026 | Granite grey | GraniteGrey | GraniteGrey | 38 51 56 | 38 | 51 | 56 | Granite grey | #define GraniteGrey ((38<<16) + ( 51<<8) + 56 )
7030 | Stone grey | StoneGrey | StoneGrey | 145 143 135 | 145 | 143 | 135 | Stone grey | #define StoneGrey ((145<<16) + ( 143<<8) + 135 )
7031 | Blue grey | BlueGrey | BlueGrey | 77 92 107 | 77 | 92 | 107 | Blue grey | #define BlueGrey ((77<<16) + ( 92<<8) + 107 )
7032 | Pebble grey | PebbleGrey | PebbleGrey | 189 186 171 | 189 | 186 | 171 | Pebble grey | #define PebbleGrey ((189<<16) + ( 186<<8) + 171 )
7033 | Cement grey | CementGrey | CementGrey | 122 130 117 | 122 | 130 | 117 | Cement grey | #define CementGrey ((122<<16) + ( 130<<8) + 117 )
7034 | Yellow grey | YellowGrey | YellowGrey | 143 135 112 | 143 | 135 | 112 | Yellow grey | #define YellowGrey ((143<<16) + ( 135<<8) + 112 )
7035 | Light grey | LightGrey | LightGrey | 212 217 219 | 212 | 217 | 219 | Light grey | #define LightGrey ((212<<16) + ( 217<<8) + 219 )
7036 | Platinum grey | PlatinumGrey | PlatinumGrey | 158 150 156 | 158 | 150 | 156 | Platinum grey | #define PlatinumGrey ((158<<16) + ( 150<<8) + 156 )
7037 | Dusty grey | DustyGrey | DustyGrey | 122 125 128 | 122 | 125 | 128 | Dusty grey | #define DustyGrey ((122<<16) + ( 125<<8) + 128 )
7038 | Agate grey | AgateGrey | AgateGrey | 186 189 186 | 186 | 189 | 186 | Agate grey | #define AgateGrey ((186<<16) + ( 189<<8) + 186 )
7039 | Quartz grey | QuartzGrey | QuartzGrey | 97 94 89 | 97 | 94 | 89 | Quartz grey | #define QuartzGrey ((97<<16) + ( 94<<8) + 89 )
7040 | Window grey | WindowGrey | WindowGrey | 158 163 176 | 158 | 163 | 176 | Window grey | #define WindowGrey ((158<<16) + ( 163<<8) + 176 )
7042 | Verkehrsgrau A | VerkehrsgrauA | VerkehrsgrauA | 143 150 153 | 143 | 150 | 153 | Verkehrsgrau A | #define VerkehrsgrauA ((143<<16) + ( 150<<8) + 153 )
7043 | Verkehrsgrau B | VerkehrsgrauB | VerkehrsgrauB | 64 69 69 | 64 | 69 | 69 | Verkehrsgrau B | #define VerkehrsgrauB ((64<<16) + ( 69<<8) + 69 )
7044 | Silk grey | SilkGrey | SilkGrey | 194 191 184 | 194 | 191 | 184 | Silk grey | #define SilkGrey ((194<<16) + ( 191<<8) + 184 )
7045 | Telegrau 1 | Telegrau1 | Telegrau1 | 143 148 158 | 143 | 148 | 158 | Telegrau 1 | #define Telegrau1 ((143<<16) + ( 148<<8) + 158 )
7046 | Telegrau 2 | Telegrau2 | Telegrau2 | 120 130 140 | 120 | 130 | 140 | Telegrau 2 | #define Telegrau2 ((120<<16) + ( 130<<8) + 140 )
7047 | Telegrau 4 | Telegrau4 | Telegrau4 | 217 214 219 | 217 | 214 | 219 | Telegrau 4 | #define Telegrau4 ((217<<16) + ( 214<<8) + 219 )
8000 | Green brown | GreenBrown | GreenBrown | 125 92 56 | 125 | 92 | 56 | Green brown | #define GreenBrown ((125<<16) + ( 92<<8) + 56 )
8001 | Ocher brown | OcherBrown | OcherBrown | 145 82 46 | 145 | 82 | 46 | Ocher brown | #define OcherBrown ((145<<16) + ( 82<<8) + 46 )
8002 | Signal brown | SignalBrown | SignalBrown | 110 59 58 | 110 | 59 | 58 | Signal brown | #define SignalBrown ((110<<16) + ( 59<<8) + 58 )
8003 | Clay brown | ClayBrown | ClayBrown | 115 59 36 | 115 | 59 | 36 | Clay brown | #define ClayBrown ((115<<16) + ( 59<<8) + 36 )
8004 | Copper brown | CopperBrown | CopperBrown | 133 56 43 | 133 | 56 | 43 | Copper brown | #define CopperBrown ((133<<16) + ( 56<<8) + 43 )
8007 | Fawn brown | FawnBrown | FawnBrown | 94 51 33 | 94 | 51 | 33 | Fawn brown | #define FawnBrown ((94<<16) + ( 51<<8) + 33 )
8008 | Olive brown | OliveBrown | OliveBrown | 99 61 36 | 99 | 61 | 36 | Olive brown | #define OliveBrown ((99<<16) + ( 61<<8) + 36 )
8011 | Nut brown | NutBrown | NutBrown | 71 38 28 | 71 | 38 | 28 | Nut brown | #define NutBrown ((71<<16) + ( 38<<8) + 28 )
8012 | Red brown | RedBrown | RedBrown | 84 31 31 | 84 | 31 | 31 | Red brown | #define RedBrown ((84<<16) + ( 31<<8) + 31 )
8014 | Sepia brown | SepiaBrown | SepiaBrown | 56 38 28 | 56 | 38 | 28 | Sepia brown | #define SepiaBrown ((56<<16) + ( 38<<8) + 28 )
8015 | Chestnut brown | ChestnutBrown | ChestnutBrown | 77 31 28 | 77 | 31 | 28 | Chestnut brown | #define ChestnutBrown ((77<<16) + ( 31<<8) + 28 )
8016 | Mahogany brown | MahoganyBrown | MahoganyBrown | 61 31 28 | 61 | 31 | 28 | Mahogany brown | #define MahoganyBrown ((61<<16) + ( 31<<8) + 28 )
8017 | Chocolate brown | ChocolateBrown | ChocolateBrown | 46 28 28 | 46 | 28 | 28 | Chocolate brown | #define ChocolateBrown ((46<<16) + ( 28<<8) + 28 )
8019 | Grey brown | GreyBrown | GreyBrown | 43 38 41 | 43 | 38 | 41 | Grey brown | #define GreyBrown ((43<<16) + ( 38<<8) + 41 )
8022 | Black brown | BlackBrown | BlackBrown | 13 8 13 | 13 | 8 | 13 | Black brown | #define BlackBrown ((13<<16) + ( 8<<8) + 13 )
8023 | Orange brown | OrangeBrown | OrangeBrown | 156 69 41 | 156 | 69 | 41 | Orange brown | #define OrangeBrown ((156<<16) + ( 69<<8) + 41 )
8024 | Beige brown | BeigeBrown | BeigeBrown | 110 64 48 | 110 | 64 | 48 | Beige brown | #define BeigeBrown ((110<<16) + ( 64<<8) + 48 )
8025 | Pale brown | PaleBrown | PaleBrown | 102 74 61 | 102 | 74 | 61 | Pale brown | #define PaleBrown ((102<<16) + ( 74<<8) + 61 )
8028 | Terra brown | TerraBrown | TerraBrown | 64 46 33 | 64 | 46 | 33 | Terra brown | #define TerraBrown ((64<<16) + ( 46<<8) + 33 )
9001 | Cream | Cream | Cream | 252 252 240 | 252 | 252 | 240 | Cream | #define Cream ((252<<16) + ( 252<<8) + 240 )
9002 | Grey white | GreyWhite | GreyWhite | 240 237 230 | 240 | 237 | 230 | Grey white | #define GreyWhite ((240<<16) + ( 237<<8) + 230 )
9003 | Signal white | SignalWhite | SignalWhite | 255 255 255 | 255 | 255 | 255 | Signal white | #define SignalWhite ((255<<16) + ( 255<<8) + 255 )
9004 | Signal black | SignalBlack | SignalBlack | 28 28 33 | 28 | 28 | 33 | Signal black | #define SignalBlack ((28<<16) + ( 28<<8) + 33 )
9005 | Jet black | JetBlack | JetBlack | 3 5 10 | 3 | 5 | 10 | Jet black | #define JetBlack ((3<<16) + ( 5<<8) + 10 )
9006 | White aluminium | WhiteAluminium | WhiteAluminium | 166 171 181 | 166 | 171 | 181 | White aluminium | #define WhiteAluminium ((166<<16) + ( 171<<8) + 181 )
9007 | Grey aluminium | GreyAluminium | GreyAluminium | 125 122 120 | 125 | 122 | 120 | Grey aluminium | #define GreyAluminium ((125<<16) + ( 122<<8) + 120 )
9010 | Pure white | PureWhite | PureWhite | 250 255 255 | 250 | 255 | 255 | Pure white | #define PureWhite ((250<<16) + ( 255<<8) + 255 )
9011 | Graphite black | GraphiteBlack | GraphiteBlack | 13 18 26 | 13 | 18 | 26 | Graphite black | #define GraphiteBlack ((13<<16) + ( 18<<8) + 26 )
9016 | Traffic white | TrafficWhite | TrafficWhite | 252 255 255 | 252 | 255 | 255 | Traffic white | #define TrafficWhite ((252<<16) + ( 255<<8) + 255 )
9017 | Traffic black | TrafficBlack | TrafficBlack | 20 23 28 | 20 | 23 | 28 | Traffic black | #define TrafficBlack ((20<<16) + ( 23<<8) + 28 )
9018 | Papyrus white | PapyrusWhite | PapyrusWhite | 219 227 222 | 219 | 227 | 222 | Papyrus white | #define PapyrusWhite ((219<<16) + ( 227<<8) + 222 )
