jochenalt/Pentapod-Design/cad/Inventor/Pololu Step down 5V 5A/Pololu 2843 5V Step Down Regulator.STEP

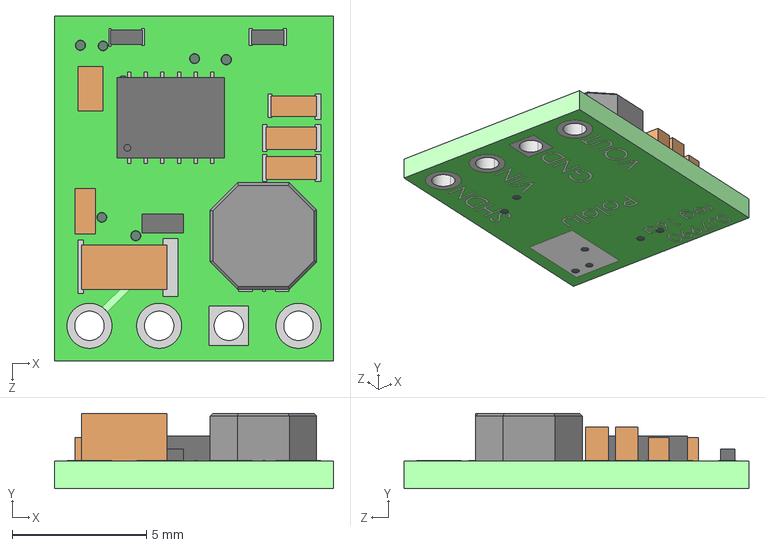
[picture p74: CAD file, 2017-08-30]
cad/Inventor/Pololu Step down 5V 5A/Pololu 2843 5V Step Down Regulator.STEP
10.4 x 2.80 x 12.8 mm
