jochenalt/Pentapod-Design/cad/Inventor/Teensy 3.5-3.6/Teensy 3.5 - 3.6.step

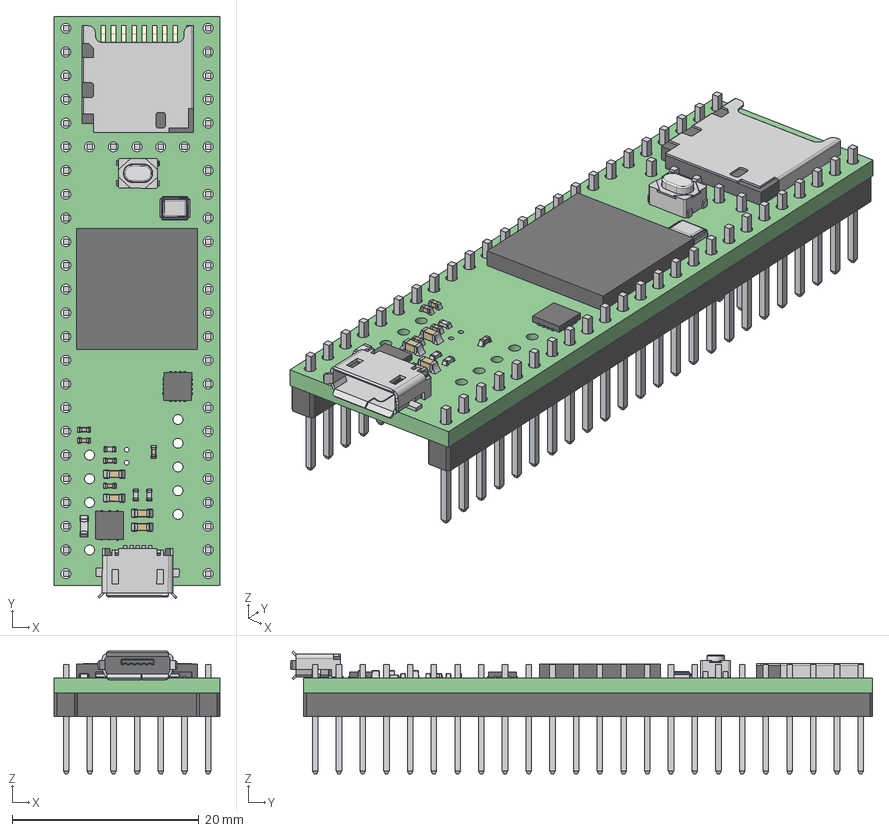
[picture p75: CAD file, 2017-08-30]
cad/Inventor/Teensy 3.5-3.6/Teensy 3.5 - 3.6.step
17.8 x 62.4 x 13.1 mm
micro_usb_plastic (1)
micro_usb_shell (1)
package
lead (1)
lead (2)
diode_0402 v1 x 4
cap0603_03 v3 x 5
cap0402 v2 (1) x 2
smt_led_0805 v2
cap0402 v2 x 5
resistor_0603 v3
Full Board
lead
Base
Case
