jochenalt/Pentapod-Design/cad/Inventor/VL6180X/VL6180X-Time_of_Flight_Sensor.stp

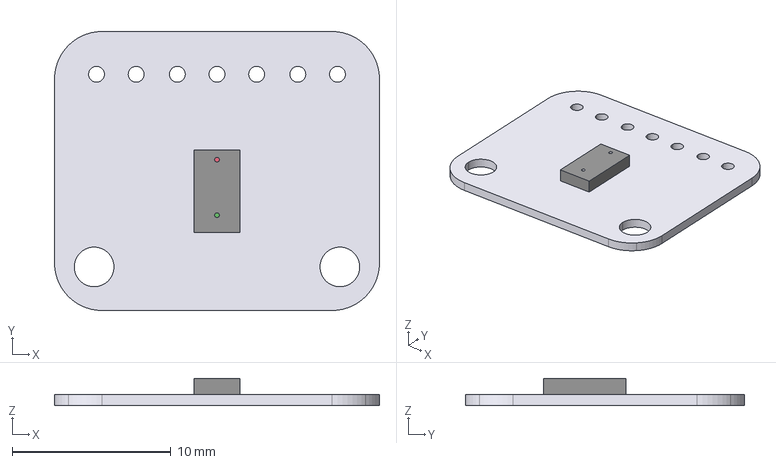
[picture p76: CAD file, 2017-08-30]
cad/Inventor/VL6180X/VL6180X-Time_of_Flight_Sensor.stp
20.5 x 17.6 x 1.71 mm
