jochenalt/Pentapod-Design/cad/stl/Knee-right.stl

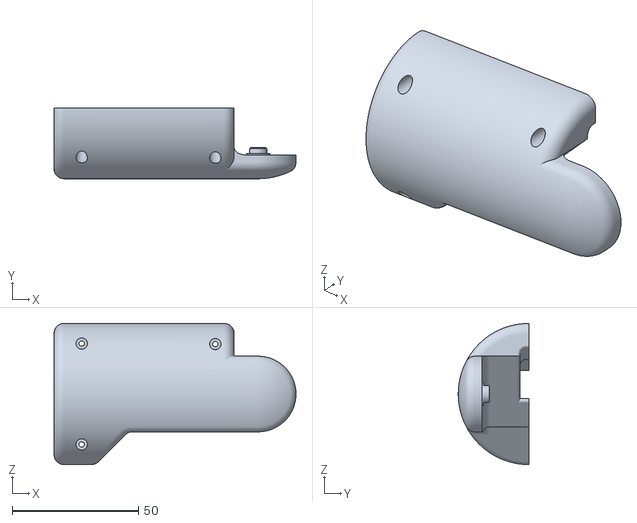
[picture p77: CAD file, 2017-12-29]
cad/stl/Knee-right.stl
96.0 x 28.0 x 56.0
