jochenalt/Pentapod-Design/cad/Inventor/Rillenkugellager 11x7x3 inafag smr117.stp

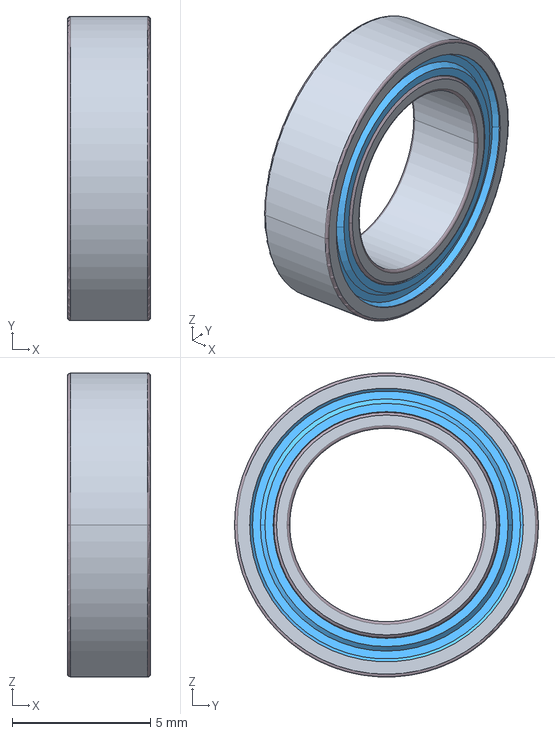
[picture p78: CAD file, 2017-08-30]
cad/Inventor/Rillenkugellager 11x7x3 inafag smr117.stp
3.00 x 11.0 x 11.0 mm
