jochenalt/Pentapod-Design/cad/stl/Foot-right.stl

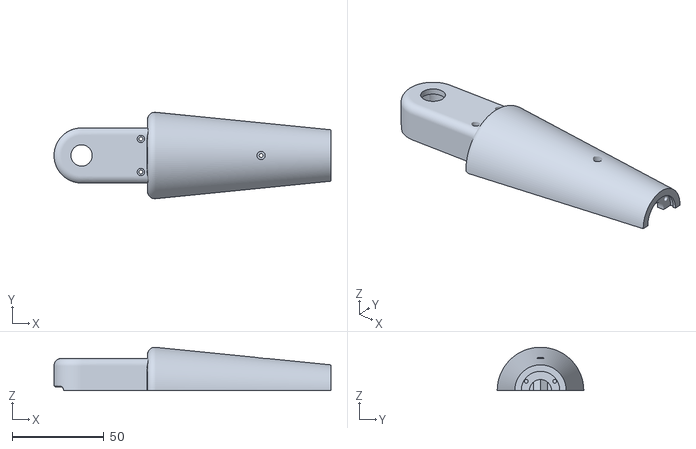
[picture p79: CAD file, 2017-12-29]
cad/stl/Foot-right.stl
150.9 x 47.2 x 23.7
