jochenalt/Pentapod-Design/cad/Inventor/W 61707-2RS1.stp

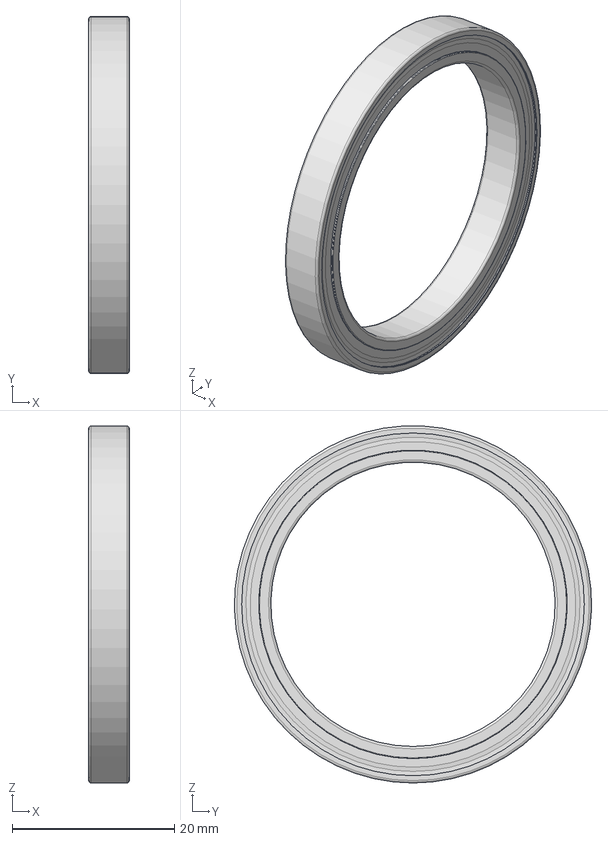
[picture p80: CAD file, 2017-08-30]
cad/Inventor/W 61707-2RS1.stp
5.00 x 44.0 x 44.0 mm
_W 61707-2RS1_PART1
_W 61707-2RS1_PART2
_W 61707-2RS1_PART3 x 26
