jochenalt/Pentapod-Design/cad/stl/Hip-bottom.stl

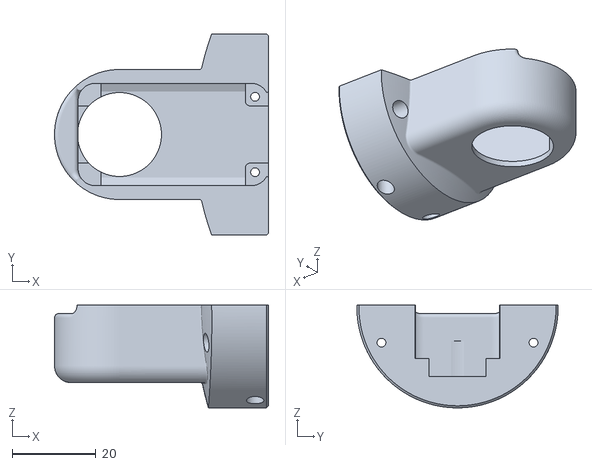
[picture p81: CAD file, 2017-12-29]
cad/stl/Hip-bottom.stl
51.0 x 48.0 x 24.5
