jochenalt/Pentapod-Design/cad/Inventor/Herkulex DRS-040x.dxf

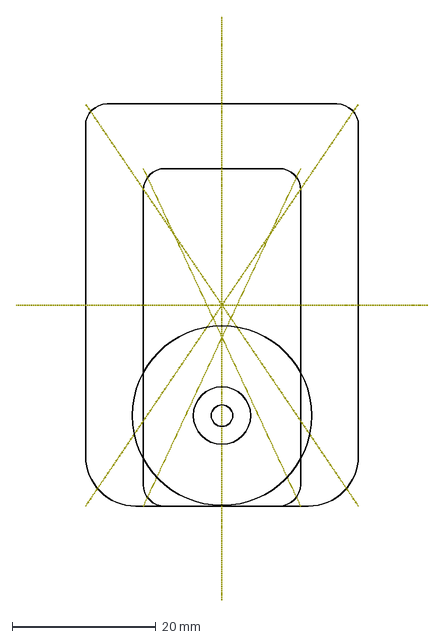
[picture p82: CAD file, 2017-08-30]
cad/Inventor/Herkulex DRS-040x.dxf
57.3 x 81.3 mm
