jochenalt/Pentapod-Design/cad/stl/HipJoint-right.stl

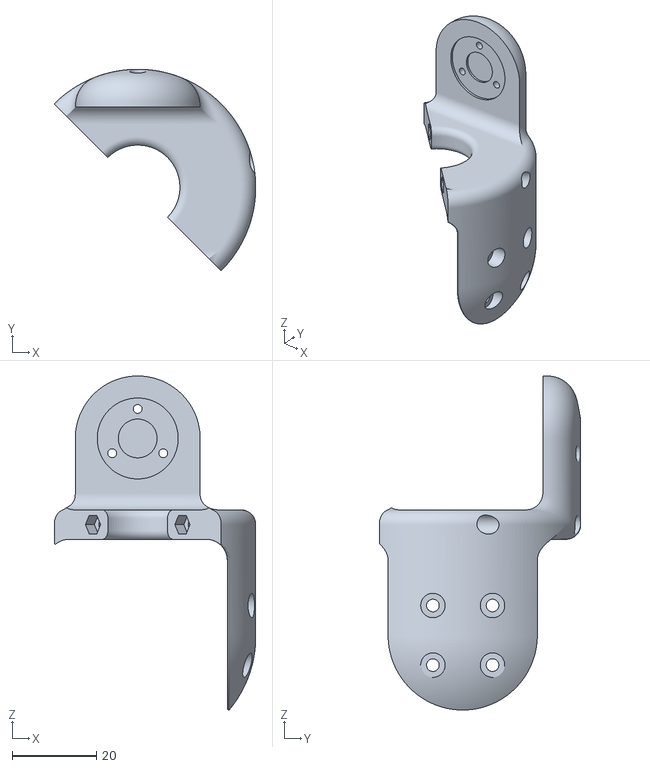
[picture p83: CAD file, 2017-12-29]
cad/stl/HipJoint-right.stl
47.8 x 47.8 x 79.2
