jochenalt/Pentapod-Design/cad/stl/Hip-top.stl

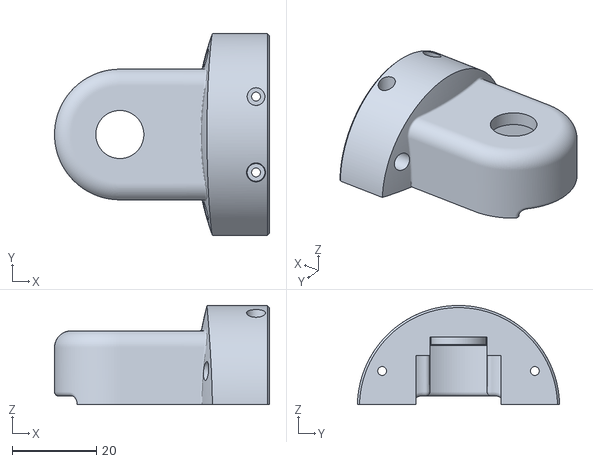
[picture p84: CAD file, 2017-12-29]
cad/stl/Hip-top.stl
51.0 x 48.0 x 23.5
