jochenalt/Pentapod-Design/cad/stl/Foot-left.stl

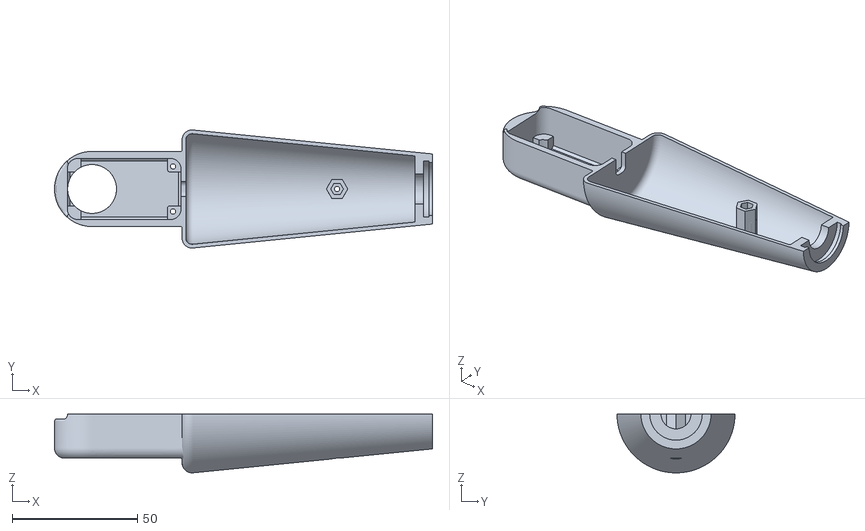
[picture p85: CAD file, 2017-12-29]
cad/stl/Foot-left.stl
150.9 x 47.2 x 23.5
