jochenalt/Pentapod-Design/cad/stl/Small-Bevel-Gear.stl

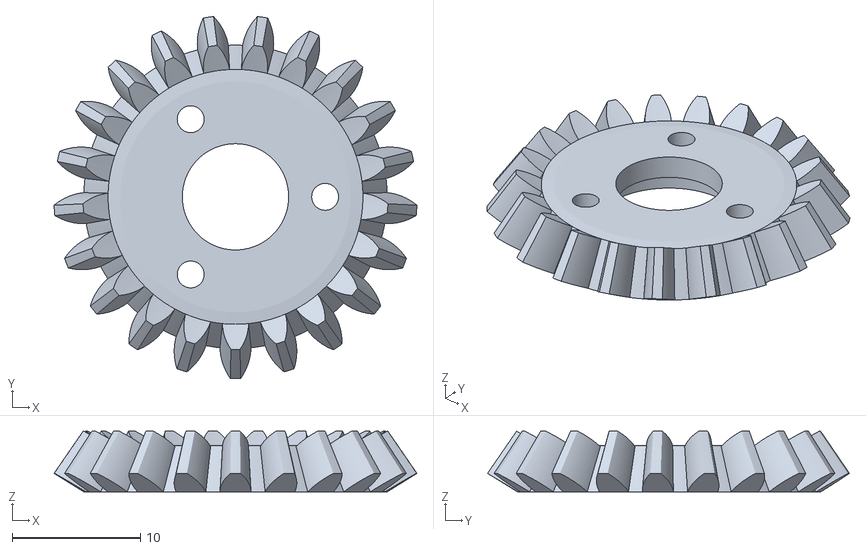
[picture p86: CAD file, 2017-12-09]
cad/stl/Small-Bevel-Gear.stl
28.3 x 28.3 x 4.74
