jochenalt/Pentapod-Design/cad/stl/Dampener-Holder.stl

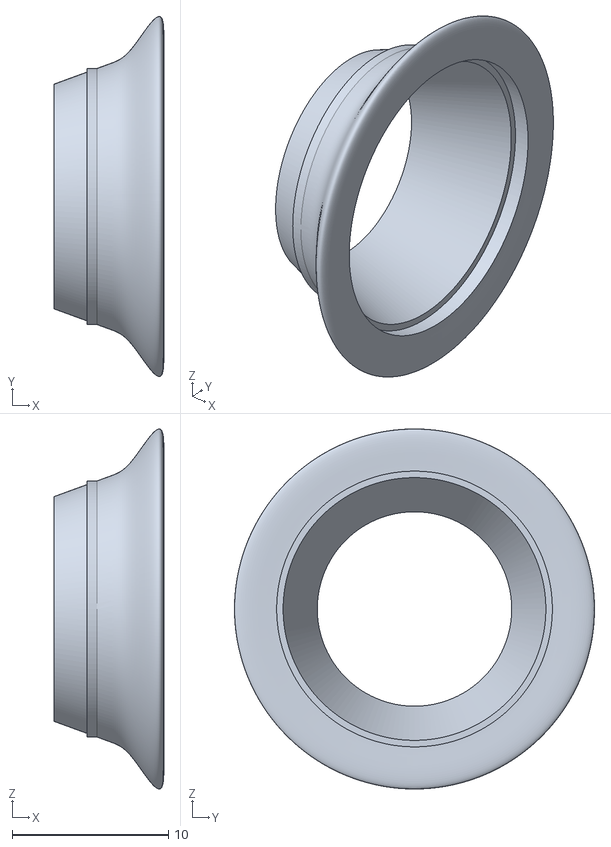
[picture p87: CAD file, 2017-11-05]
cad/stl/Dampener-Holder.stl
7.01 x 23.0 x 23.0
