jochenalt/Pentapod-Design/cad/stl/Dampener-disk.stl

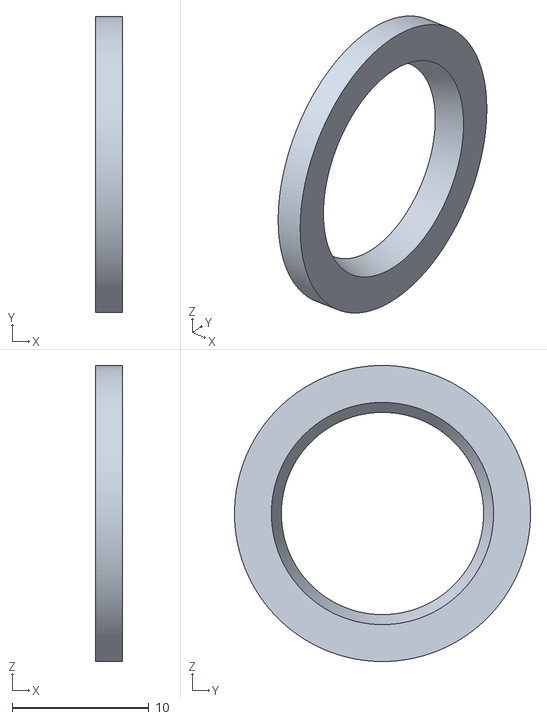
[picture p88: CAD file, 2017-11-05]
cad/stl/Dampener-disk.stl
2.00 x 21.7 x 21.7
