jochenalt/Pentapod-Design/cad/stl/Dampener-Shape-1.stl

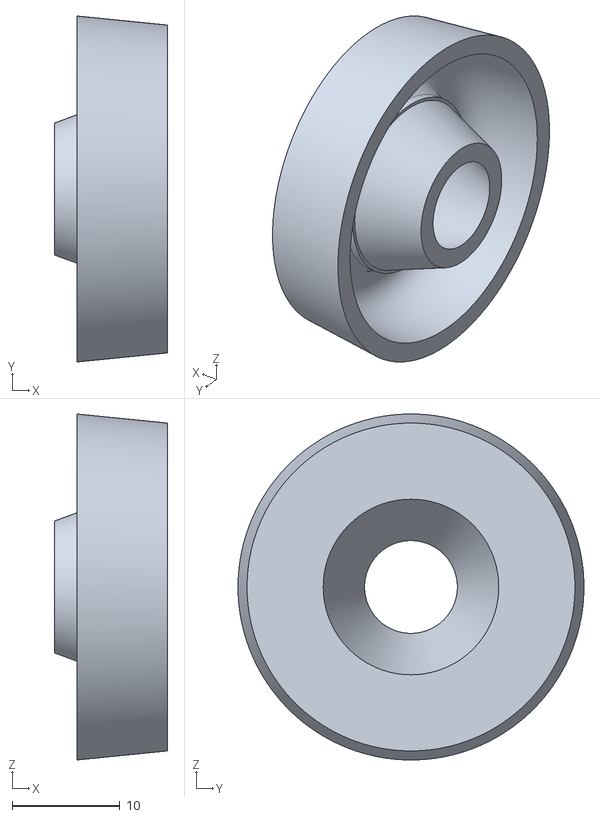
[picture p89: CAD file, 2017-11-05]
cad/stl/Dampener-Shape-1.stl
10.5 x 32.1 x 32.2
