jochenalt/Pentapod-Design/cad/stl/Dampener-Shape-2.stl

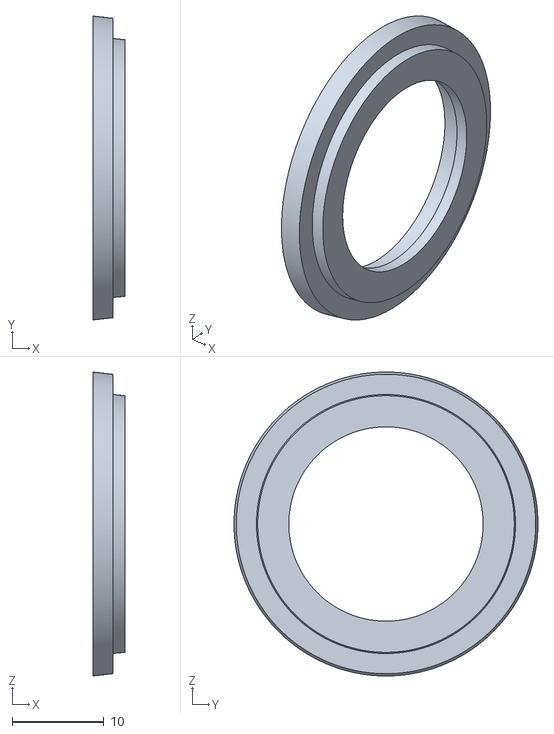
[picture p90: CAD file, 2017-10-28]
cad/stl/Dampener-Shape-2.stl
3.50 x 33.1 x 33.1
