jochenalt/Pentapod-Design/cad/stl/Lidar-Holder.stl

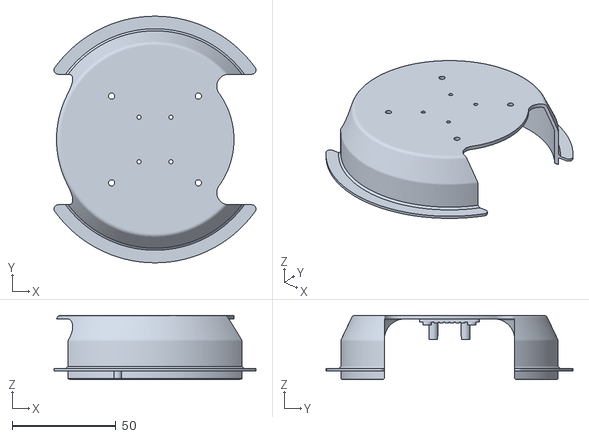
[picture p91: CAD file, 2017-10-27]
cad/stl/Lidar-Holder.stl
97.1 x 118.6 x 31.0
