jochenalt/Pentapod-Design/cad/stl/HipJoint-left.stl

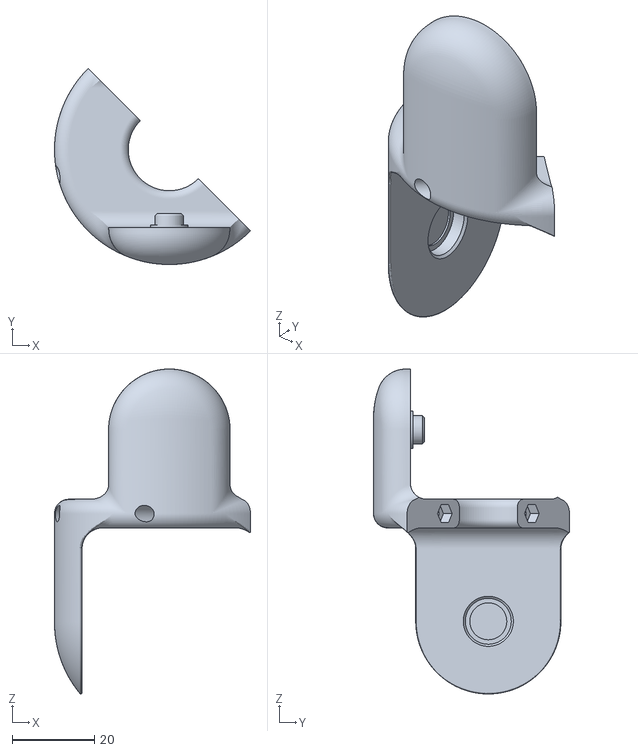
[picture p92: CAD file, 2017-10-27]
cad/stl/HipJoint-left.stl
47.8 x 47.8 x 79.2
