jochenalt/Pentapod-Design/cad/stl/Thigh-bottom.stl

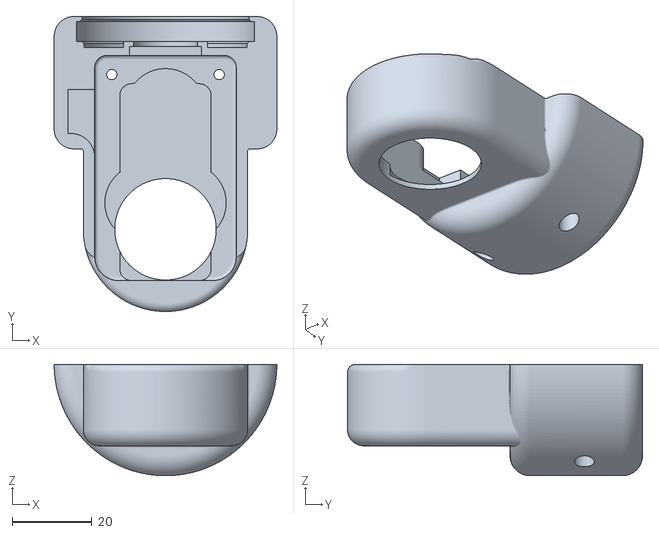
[picture p93: CAD file, 2017-10-07]
cad/stl/Thigh-bottom.stl
56.0 x 74.2 x 28.0
