jochenalt/Pentapod-Design/cad/stl/Big-Bevel-Gear.stl

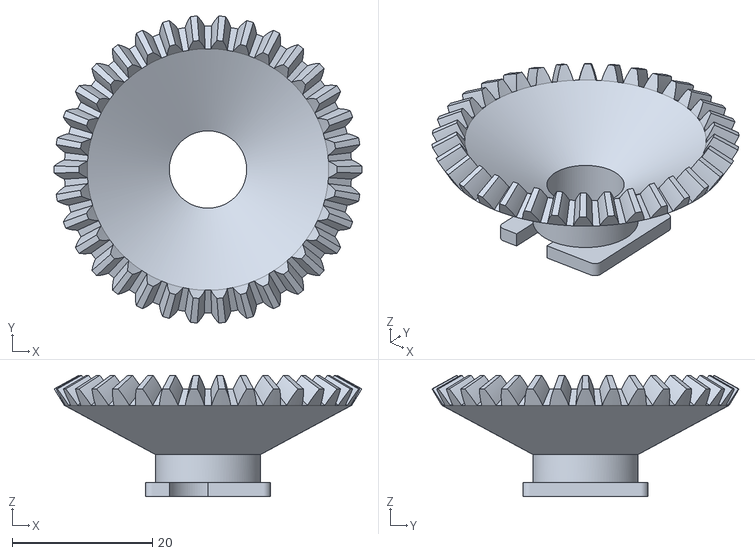
[picture p94: CAD file, 2017-10-07]
cad/stl/Big-Bevel-Gear.stl
43.8 x 43.7 x 17.3
