jochenalt/Pentapod-Design/cad/stl/Thigh-Bushing-Inside.stl

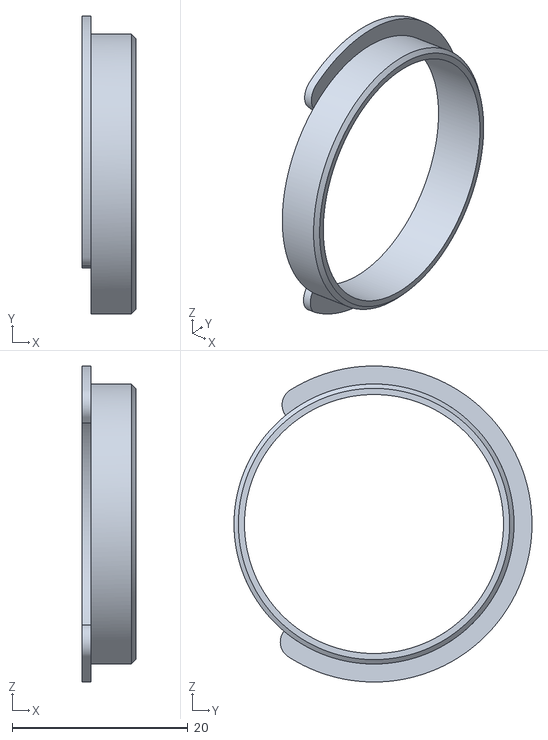
[picture p95: CAD file, 2017-10-07]
cad/stl/Thigh-Bushing-Inside.stl
6.10 x 33.9 x 36.0
