jochenalt/Pentapod-Design/cad/stl/Thigh-Bushing-Outside.stl

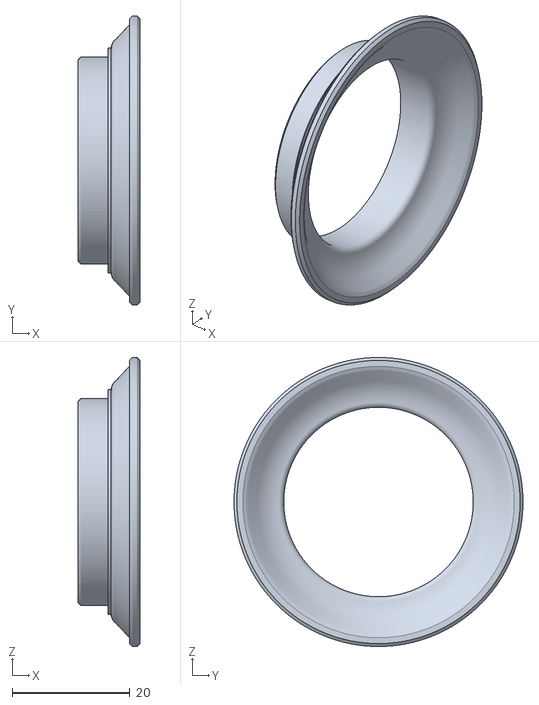
[picture p96: CAD file, 2017-10-07]
cad/stl/Thigh-Bushing-Outside.stl
10.5 x 49.0 x 49.0
