jochenalt/Pentapod-Design/(list of files, cad)

Other CAD files:
cad/Inventor/BatterPackHolder.dwg
cad/stl/Knee-left.stl
cad/stl/Thigh-top.stl
cad/Inventor/BNO055.ipt
cad/Inventor/BatterPackHolder.ipt
cad/Inventor/Battery 18650.ipt
cad/Inventor/Battery 26500.ipt
cad/Inventor/Battery Pack.iam
cad/Inventor/BatteryPack 2S.iam
cad/Inventor/BatteryPack 3S.iam
cad/Inventor/Body Inside.iam
cad/Inventor/Body Xu4.iam
cad/Inventor/Body.iam
cad/Inventor/Body.ipt
cad/Inventor/Converter XL4015/3296W.ipt
cad/Inventor/Converter XL4015/CAPAE-D10.0x10.2.ipt
cad/Inventor/Converter XL4015/Enzotech-BMR-C1.ipt
cad/Inventor/Converter XL4015/SC-76A.ipt
cad/Inventor/Converter XL4015/SDown PCB.ipt
cad/Inventor/Converter XL4015/TO263-5-1.ipt
cad/Inventor/CortexHalter.ipt
cad/Inventor/CortexPCB.ipt
cad/Inventor/Foot-V2.ipt
cad/Inventor/Foot.iam
cad/Inventor/Foot.ipt
cad/Inventor/Herkulex DRS-010x/BOTTOM_CASE_290.ipt
cad/Inventor/Herkulex DRS-010x/CASE_228.ipt
cad/Inventor/Herkulex DRS-010x/HORN_44.ipt
cad/Inventor/Herkulex DRS-010x/HerkuleX DRS-0101.iam
cad/Inventor/Herkulex DRS-010x/HerkuleX DRS-0201.iam
cad/Inventor/Herkulex DRS-010x/INNER_NUT_14.ipt
cad/Inventor/Herkulex DRS-010x/KSB1023A_M2_5X8Z_147.ipt
cad/Inventor/Herkulex DRS-010x/KSB1023A_T2X25NI_147.ipt
cad/Inventor/Herkulex DRS-010x/LED_LENSE_101.ipt
cad/Inventor/Herkulex DRS-010x/MR106_9.ipt
cad/Inventor/Herkulex DRS-010x/TOP_191.ipt
cad/Inventor/Herkulex DRS-010x/TORQUE_VERSION_12_017_ASM_223_A_ASM.iam
cad/Inventor/Herkulex DRS-010x/TORQUE_VERSION_12_017_ASM_ASM_ASM.iam
cad/Inventor/Herkulex DRS-010x/W 61707-2RS1.ipt
cad/Inventor/Herkulex DRS-040x.ipt
cad/Inventor/Hip.iam
cad/Inventor/Hip.ipt
cad/Inventor/HipJoint.ipt
cad/Inventor/Kegelräder 040x/Konstruktions-Assistent/Kegelrad11.ipt
cad/Inventor/Kegelräder 040x/Konstruktions-Assistent/Kegelrad21.ipt
cad/Inventor/Kegelräder 040x/Konstruktions-Assistent/Kegelräder1.iam
cad/Inventor/Kegelräder Construction.iam
cad/Inventor/Knee.ipt
cad/Inventor/Leg.iam
cad/Inventor/Lidar-Holder-xu4.ipt
cad/Inventor/Lidar-Holder.ipt
cad/Inventor/ODroid Holder.ipt
cad/Inventor/ODroid Xu4 Holder.ipt
cad/Inventor/Oberschenkel/Konstruktions-Assistent/Kegelrad12.ipt
cad/Inventor/Oberschenkel/Konstruktions-Assistent/Kegelrad13.ipt
cad/Inventor/Oberschenkel/Konstruktions-Assistent/Kegelrad23.ipt
cad/Inventor/Oberschenkel/Konstruktions-Assistent/Kegelräder1.iam
cad/Inventor/PCB Slamtec RPLidar A2.ipt
cad/Inventor/PKCell 3.7V 2500mAh.ipt
cad/Inventor/Pololu 2843 5V Step Down Regulator.ipt
cad/Inventor/Pololu Step down 5V 5A/Pololu 2843 5V Step Down Regulator.ipt
cad/Inventor/RPLidar A2.ipt
cad/Inventor/Rillenkugellager 11x7x3 inafag smr117.ipt
cad/Inventor/SimplifiedBody.ipt
cad/Inventor/SimplifiedBody2.ipt
cad/Inventor/SimplifiedLeg.iam
cad/Inventor/Thigh Bushing.ipt
cad/Inventor/Thigh.iam
cad/Inventor/Thigh.ipt
cad/Inventor/ThighKneeGear.iam
cad/Inventor/VL6180X/SensorAdapter.ipt
cad/Inventor/VL6180X/VL6180X-Time_of_Flight_Sensor.ipt
cad/Inventor/W 61707-2RS1.iam
cad/Inventor/XL4015 DC-DC StepDown Assembly.iam
cad/Inventor/abstandsbolzen M2 10mm.ipt
cad/Inventor/abstandsbolzen M2 20mm.ipt
cad/Inventor/abstandsbolzen M2 5mm.ipt
cad/simplified/DrehAchse.ipt
cad/simplified/SimplifiedBody.ipt
cad/simplified/SimplifiedBody040x.ipt
cad/simplified/SimplifiedFoot.ipt
cad/simplified/SimplifiedFoot040x.ipt
cad/simplified/SimplifiedHip.ipt
cad/simplified/SimplifiedHip040x.ipt
cad/simplified/SimplifiedHipJoint.ipt
cad/simplified/SimplifiedHipJoint040x.ipt
cad/simplified/SimplifiedKnee.ipt
cad/simplified/SimplifiedKnee040x.ipt
cad/simplified/SimplifiedLeg.iam
cad/simplified/SimplifiedThigh.ipt
cad/simplified/SimplifiedThigh040x.ipt
