jochenalt/Pentapod-Design/theory/rbpf-slam-tutorial-2007.pdf

Giorgio Grisetti and Cyrill Stachniss

University of Freiburg, Germany

Special thanks to Dirk Haehnel

## ECMR 2007 Tutorial Learning Grid Maps with Rao-Blackwellized Particle Filters

## What is this Talk About?

mapping

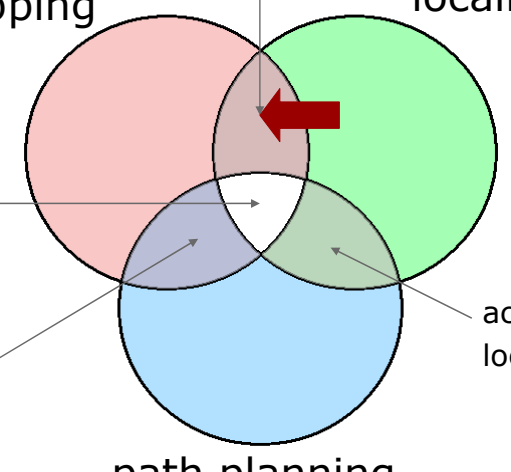
[picture p140: figure]

path planning

localization

SLAM

active
localization
exploration

integrated
approaches

## What is “SLAM” ?

ß Estimate the pose and the map of a mobile robot at the same time

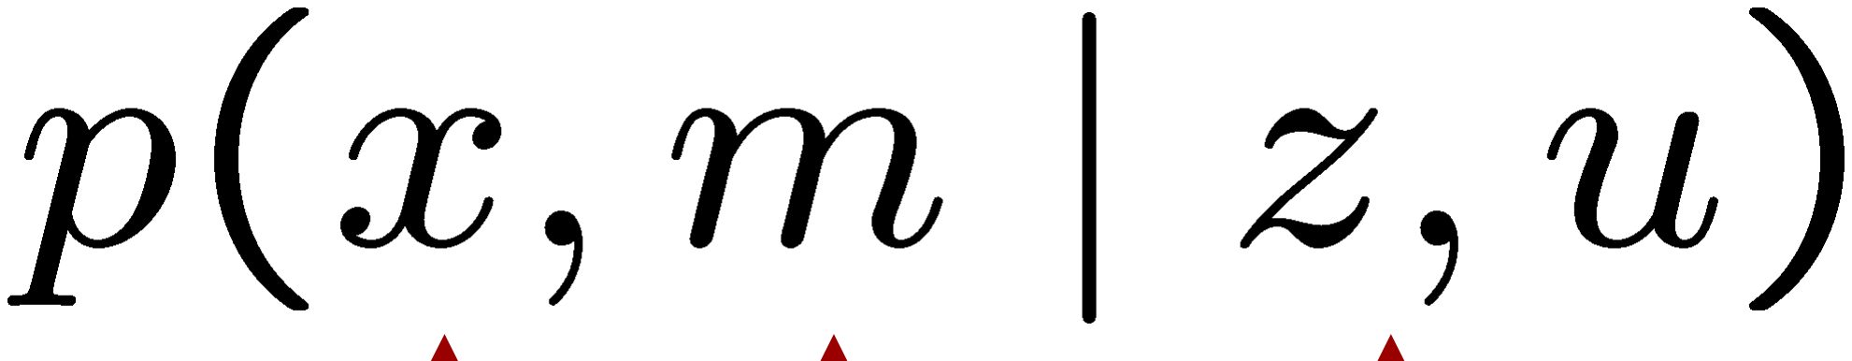
[picture p141: figure]
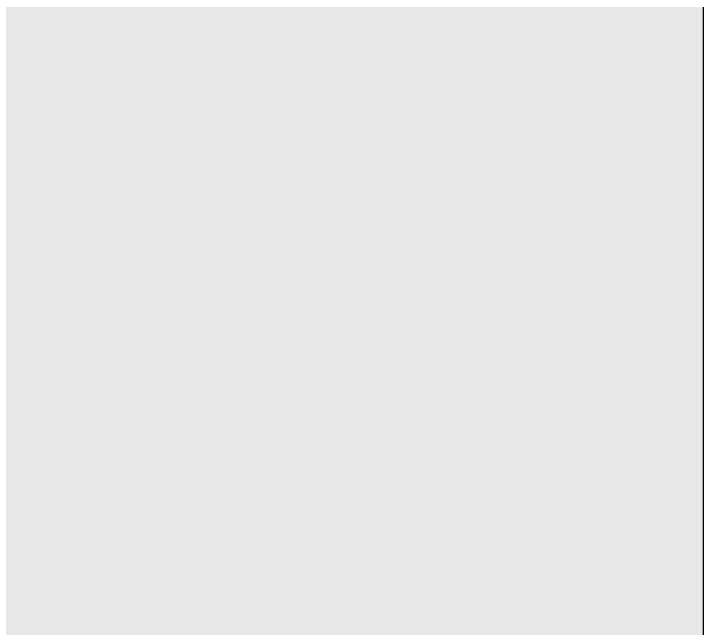
[picture p142: figure]

Courtesy of Dirk Haehnel

poses map observations & movements

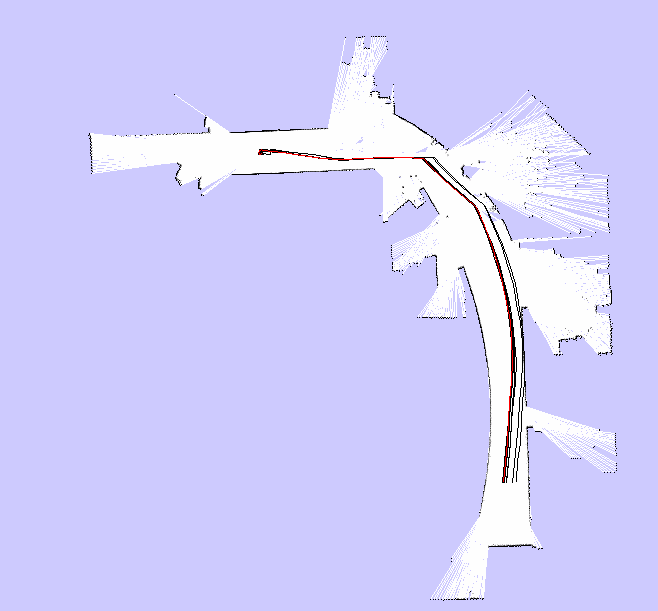
[picture p143: figure]

[video]

## Particle Filters

## Who knows how a particle filter works

Explain Particle Filters | Skip Explanation

## Introduction to Particle Filters

What is a particle filter?
ß It is a Bayes filter
ß Particle filters are a way to efficiently represent non-Gaussian distribution

Basic principle
ß Set of state hypotheses (“particles”) ß Survival-of-the-fittest

## Sample-based Localization (sonar)

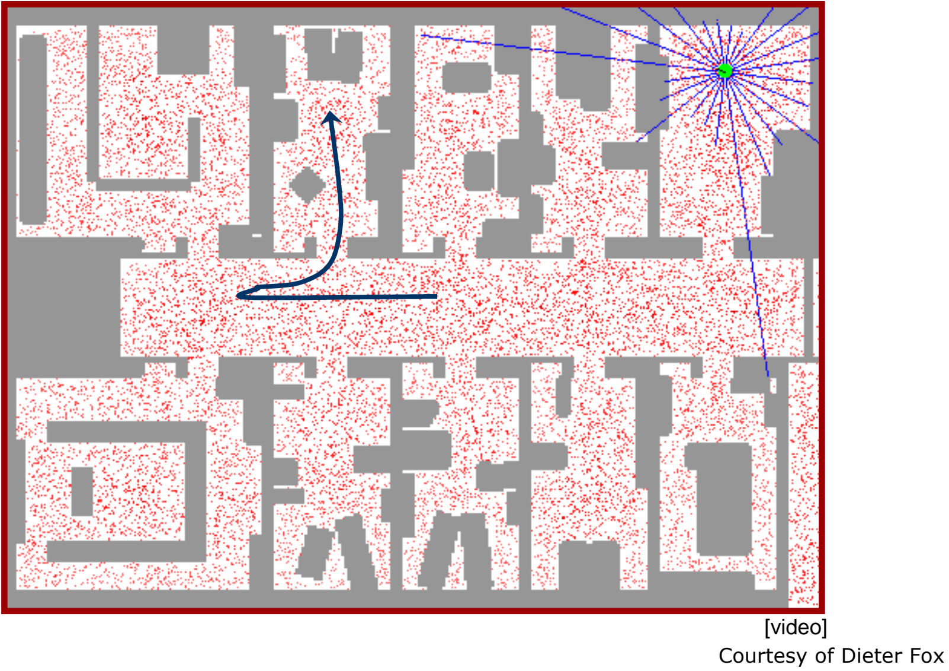
[picture p144: figure]
Courtesy of Dieter Fox; [video]

ß Set of weighted samples

## Sample-based Posteriors

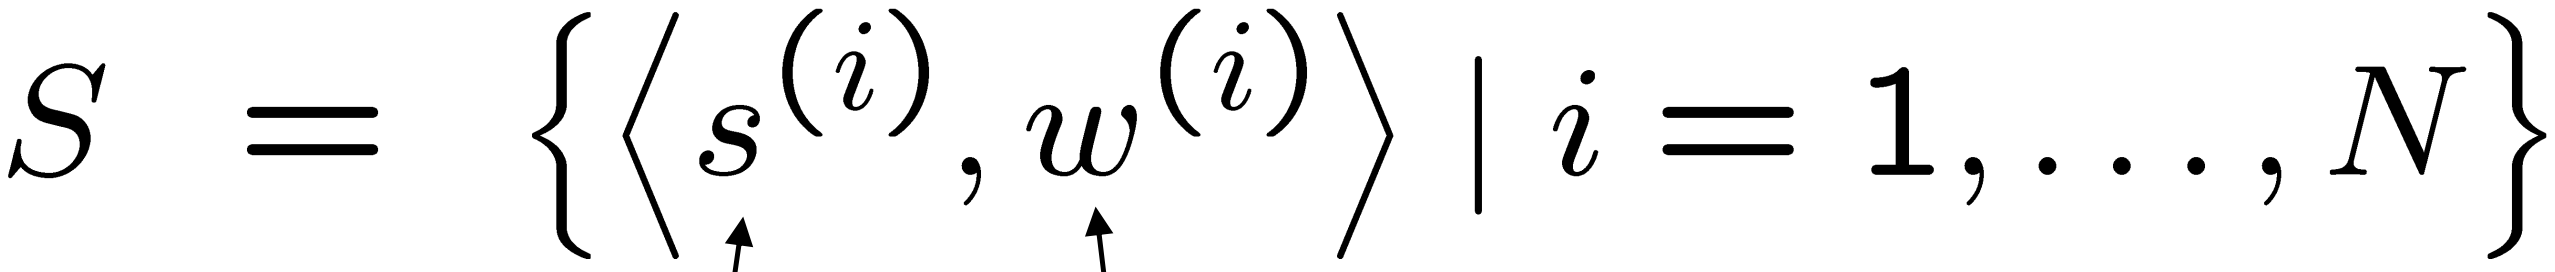
[picture p145: figure]

ß The samples represent the posterior

State hypothesis Importance weight

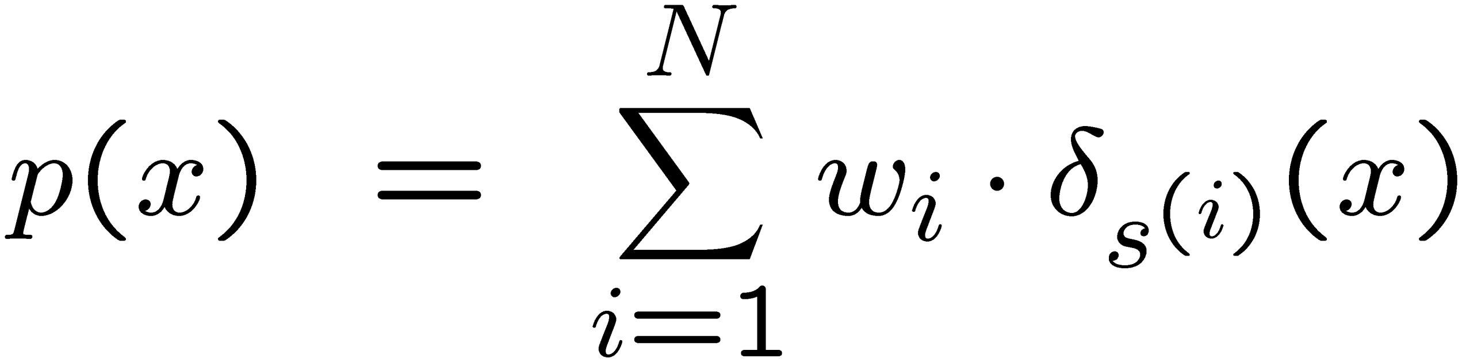
[picture p146: figure]

ß Particle sets can be used to approximate functions

## Posterior Approximation

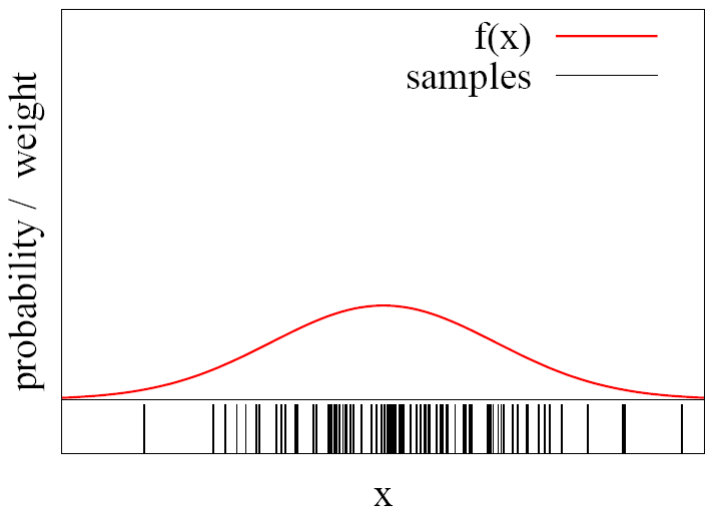
[picture p147: figure]
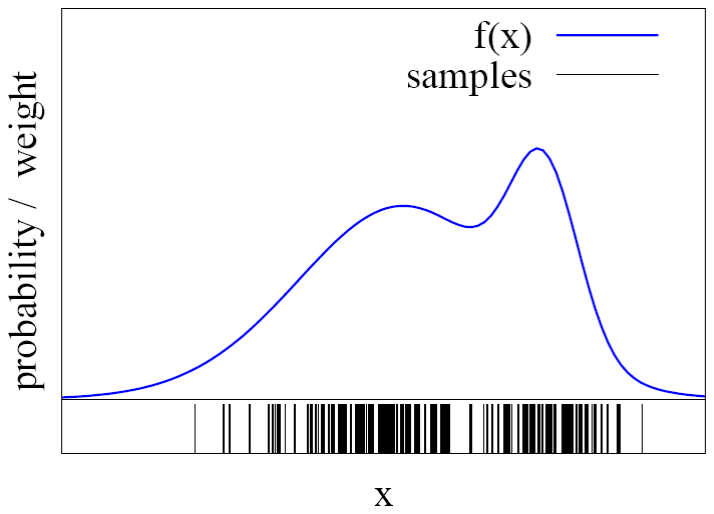
[picture p148: figure]

ß The more particles fall into an interval, the higher the probability of that interval

ß How to draw samples form a function/distribution?

ß Let us assume that f(x)<1 for all x
ß Sample x from a uniform distribution ß Sample c from [0,1]
ß if f(x) > c | keep the sample
otherwise | reject the sample

## Rejection Sampling

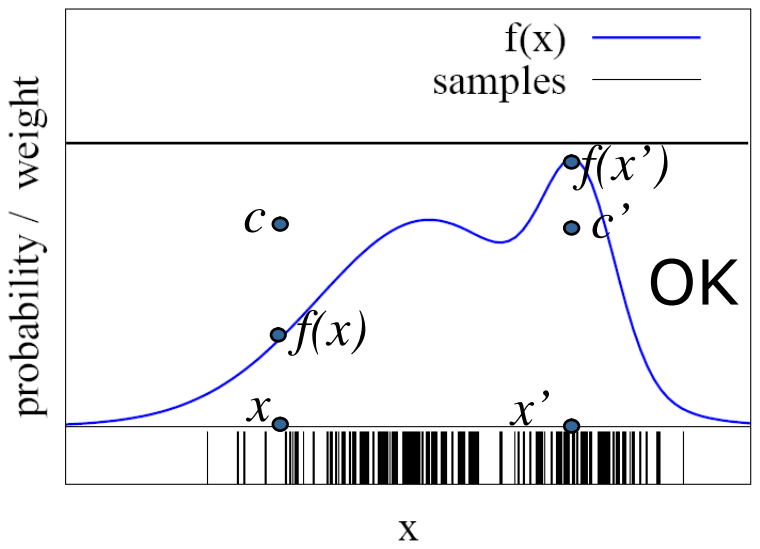
[picture p149: figure]

ß We can even use a different distribution g to generate samples from f
ß By introducing an importance weight w, we can account for the “differences between g and f ” ß w = f / g
ß f is called target
ß g is called
proposal

## Importance Sampling Principle

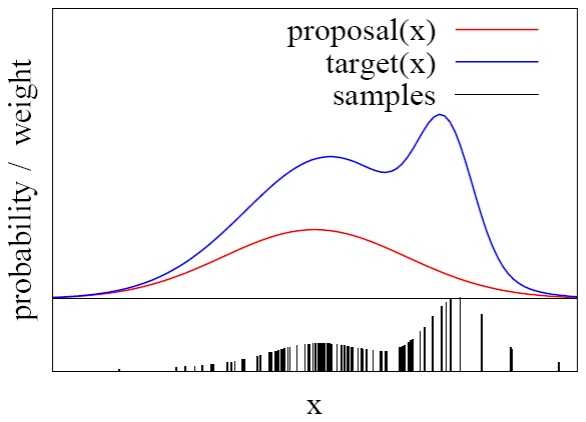
[picture p150: figure]

ß Set of samples describes the posterior
ß Updates are based on actions and observations

Three sequential steps:

### 1. Sampling from the proposal distribution

(Bayes filter: prediction step)

### 2. Compute the particle weight (importance sampling)

(Bayes filter: correction step)

### 3. Resampling

## From Sampling to a Particle Filter

ß For each motion Δ do:
ß Sampling: Generate from each sample in a new sample according to the motion model

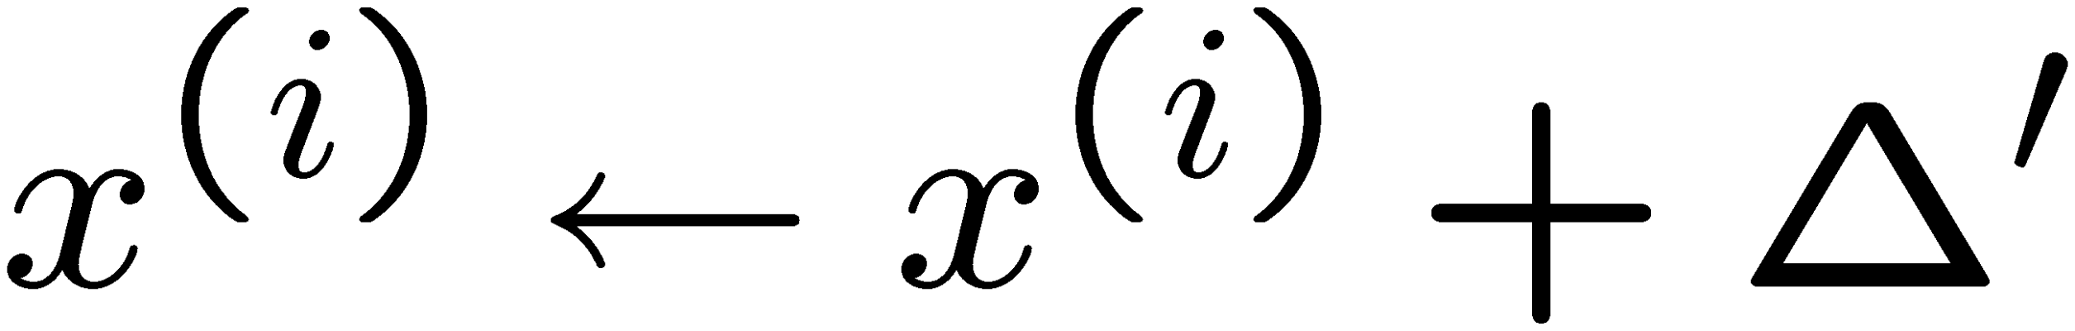
[picture p151: figure]

ß For each observation do:
ß Weight the samples with the observation likelihood

ß Resampling

## Monte-Carlo Localization

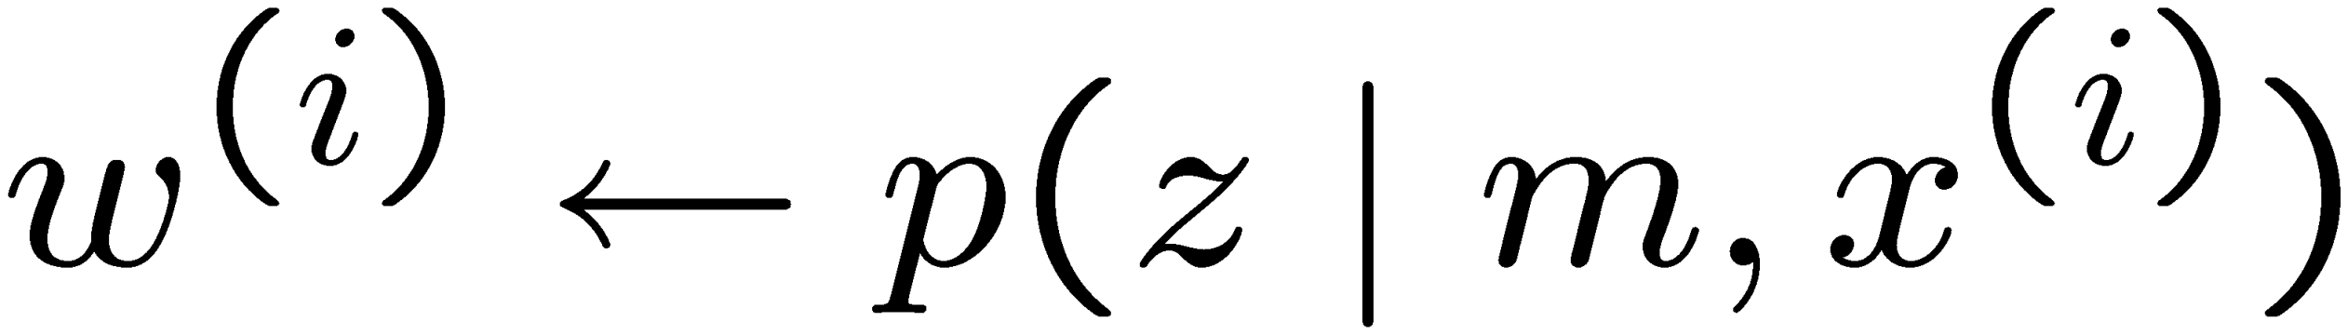
[picture p152: figure]

## Sample-based Localization (sonar)

## Grids Maps

ß Grid maps are a discretization of the environment into free and occupied cells ß Mapping with known robot poses is easy.

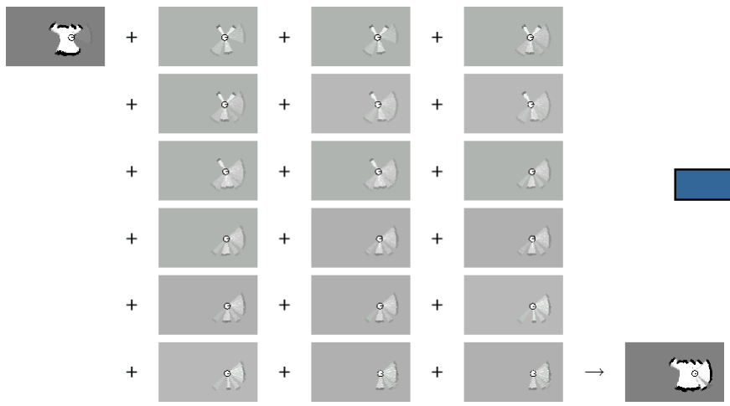
[picture p153: figure]
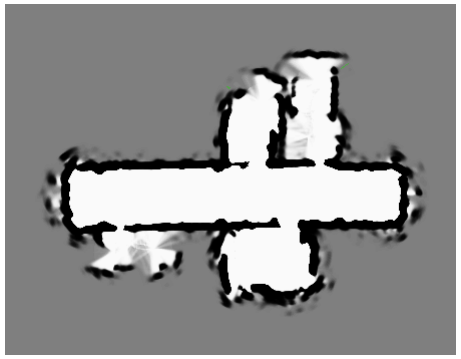
[picture p154: figure]

## Mapping using Raw Odometry

ß Why is SLAM hard? Chicken and egg problem: ß a map is needed to localize the robot and ß a pose estimate is needed to build a map

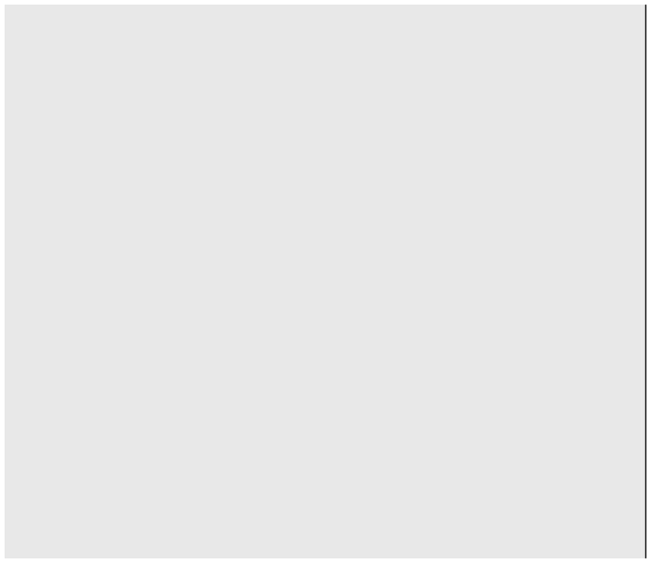
[picture p155: figure]

Courtesy of Dirk Haehnel [video]

ß Particle filters have successfully been applied to localization, can we use them to solve the SLAM problem?
ß Posterior over poses x and maps m

Observations:

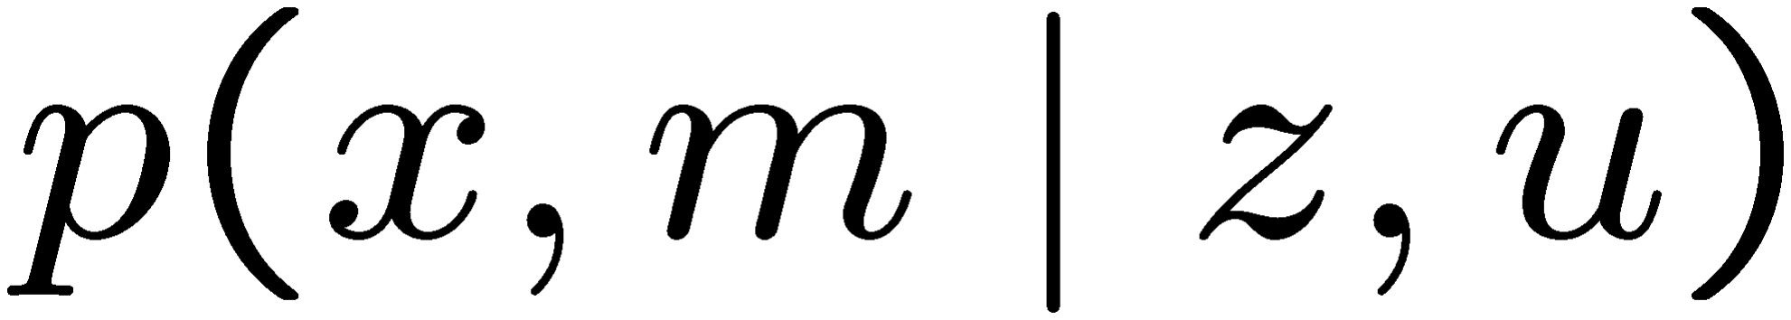
[picture p156: figure]

ß The map depends on the poses of the robot during data acquisition
ß If the poses are known, mapping is easy

## SLAM with Particle Filters

(localization) | (SLAM)

## Rao-Blackwellization

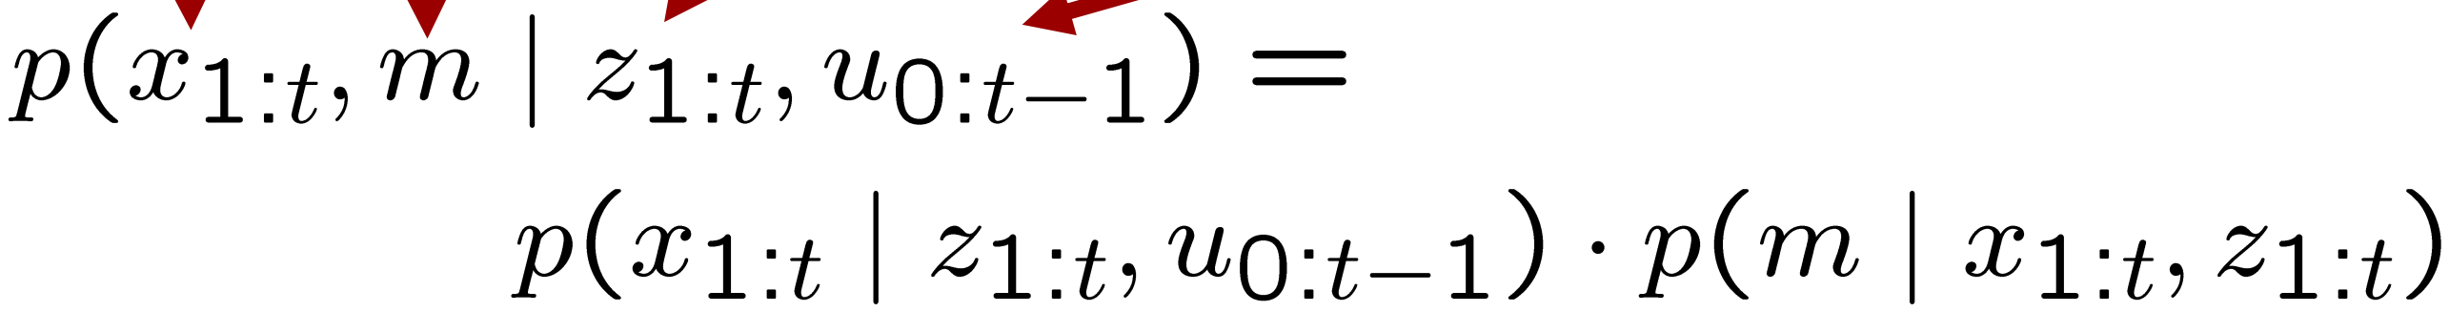
[picture p157: figure]

Factorization first introduced by Murphy in 1999

### poses map observations & movements

## Rao-Blackwellization

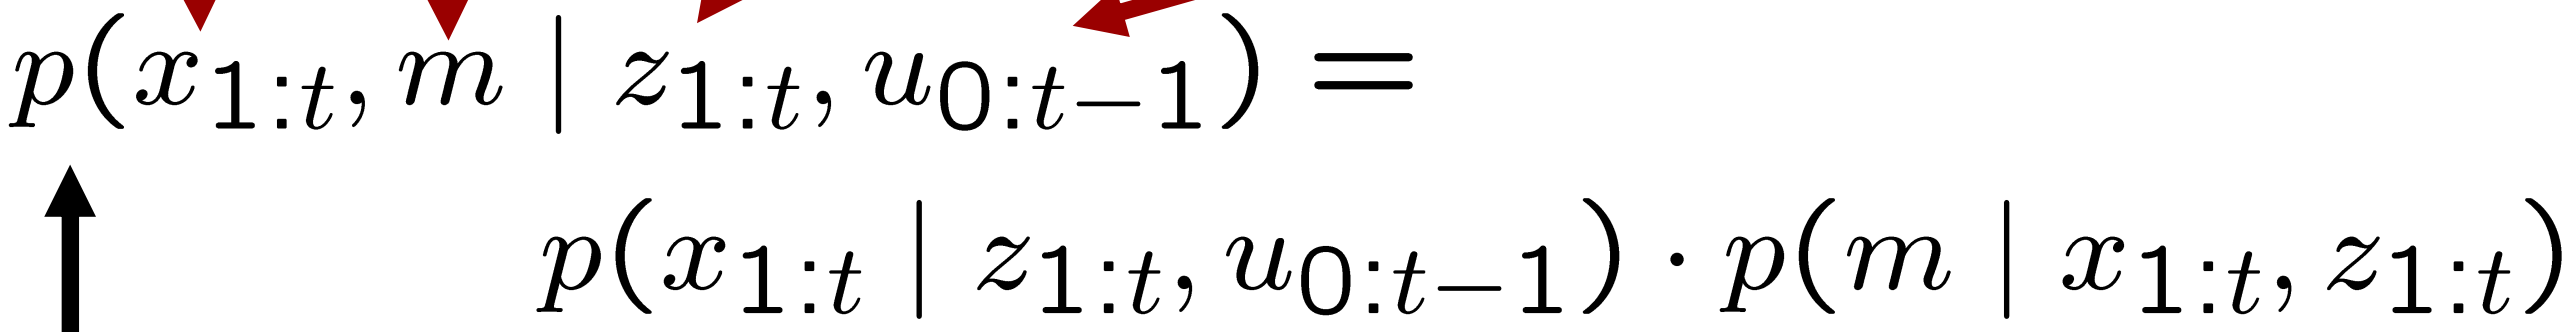
[picture p158: figure]

### SLAM posterior

### Robot path posterior

### Mapping with known poses

Factorization first introduced by Murphy in 1999

### poses map observations & movements

## Rao-Blackwellization

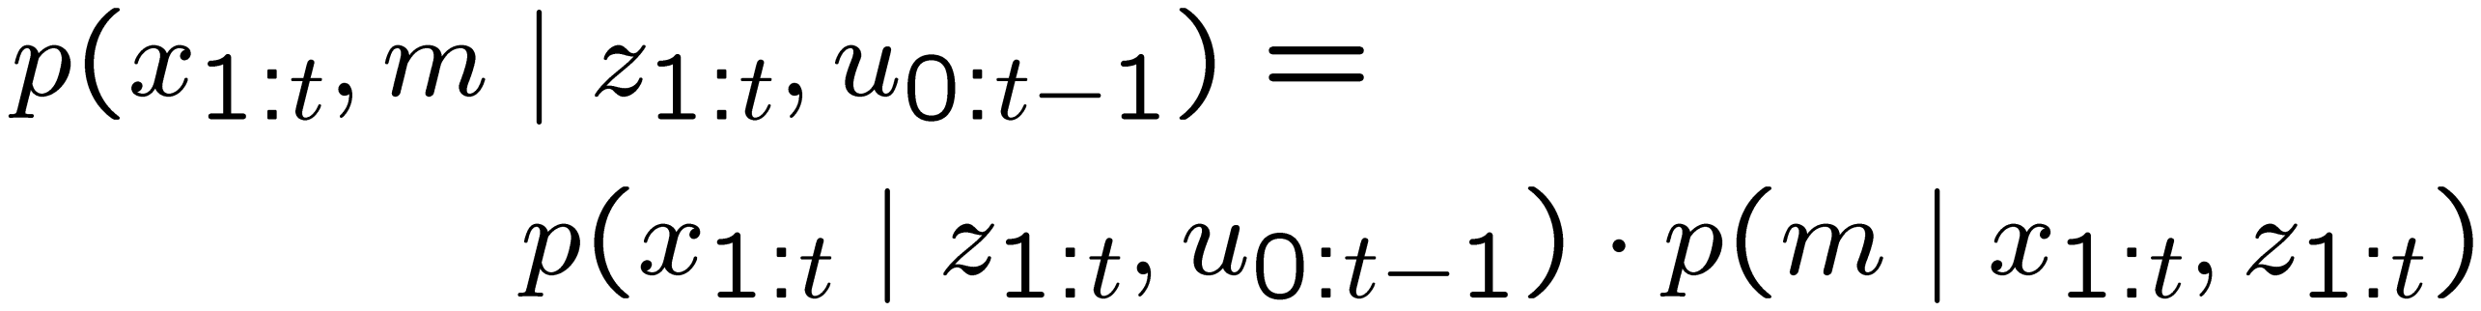
[picture p159: figure]

### This is localization, use MCL

### Use the pose estimate from the MCL and apply mapping with known poses

## A Solution to the SLAM Problem

n Use a particle filter to represent potential trajectories of the robot

n Each particle carries its own map

n Each particle survives with a probability proportional to the likelihood of the observations relative to its own map

n We have a joint posterior about the poses of the robot and the map

[Murphy, 99; Montemerlo et al., 03; Haehnel et al., 03; Eliazar and Parr, 03; Grisetti et al., 05]

## Example

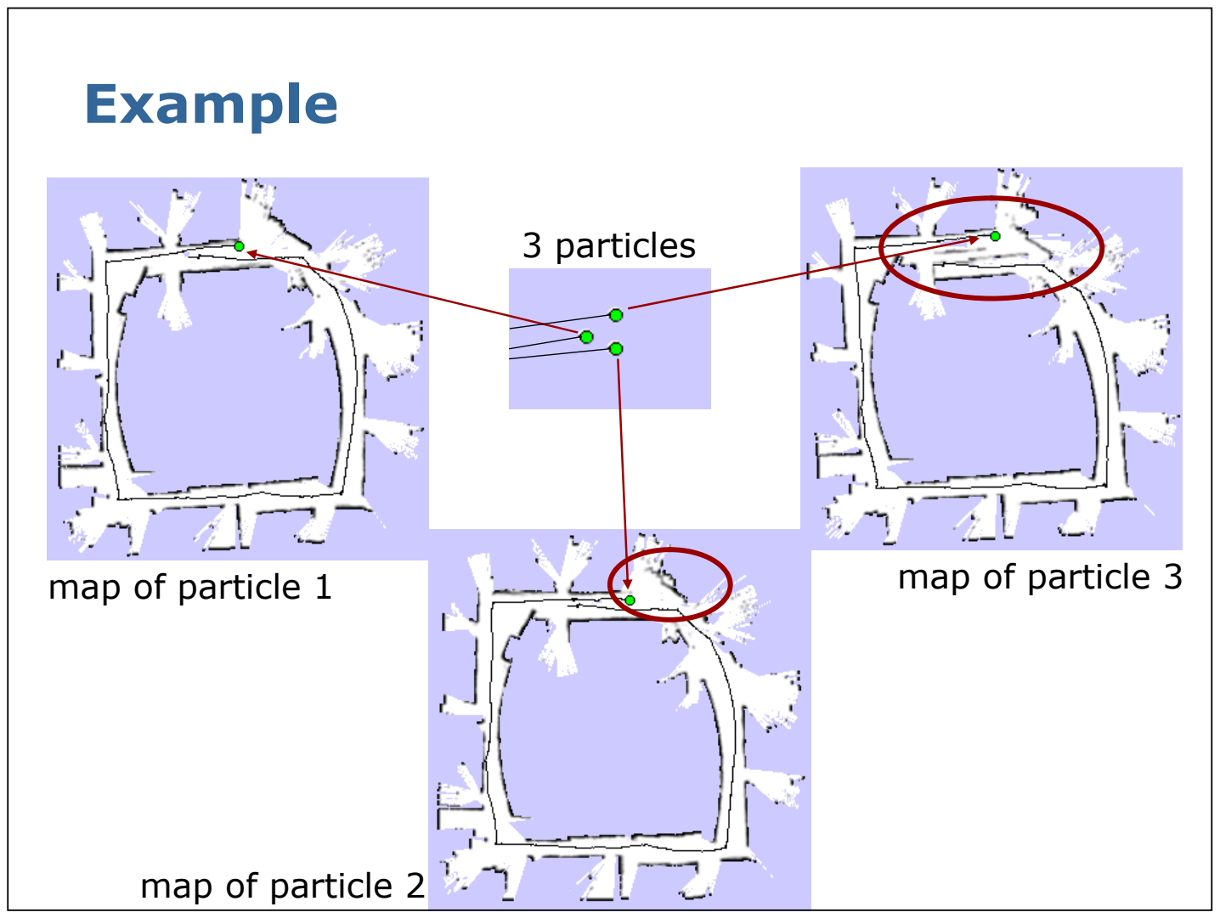
[picture p160: page 21]

map of particle 1 | map of particle 3

map of particle 2

### 3 particles

## A Graphical Model of Rao-Blackwellized Mapping

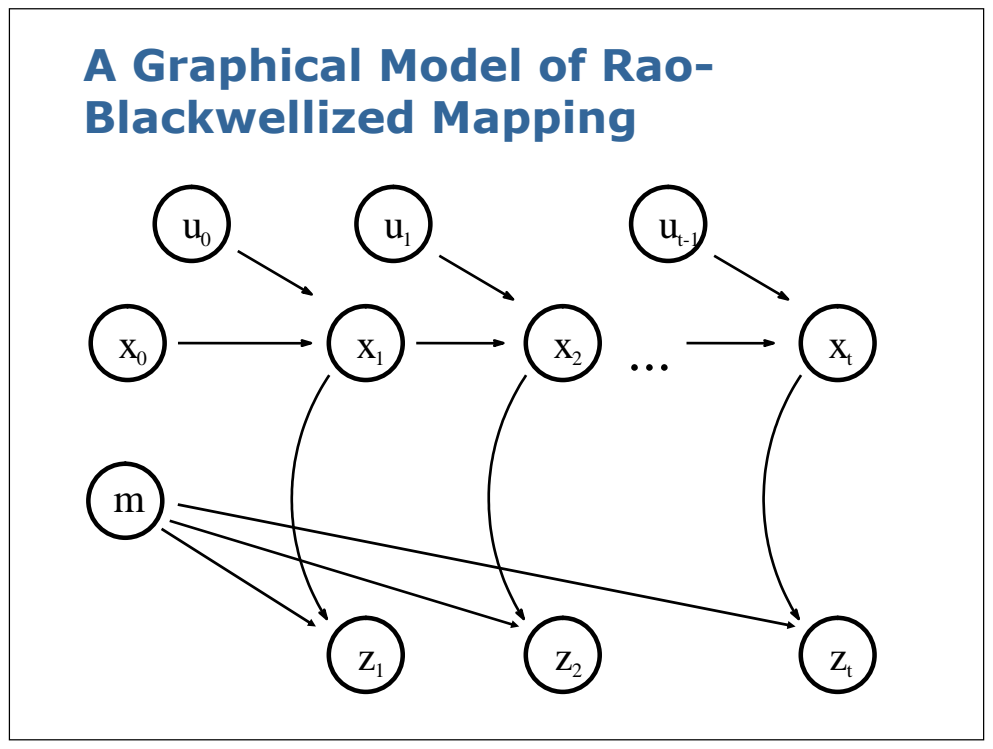
[picture p161: page 22]

## Problems in Practice

ß Each map is quite big in case of grid maps ß Since each particle maintains its own map ß Therefore, one needs to keep the number of particles small

ß Solution:
Compute better proposal distributions

ß Idea:
Improve the pose estimate before applying the particle filter

## Pose Correction Using Scan Matching

## Maximize the likelihood of the i-th pose relative to the (i-1)-th pose

current measurement | robot motion

map constructed so far

## Motion Model for Scan Matching

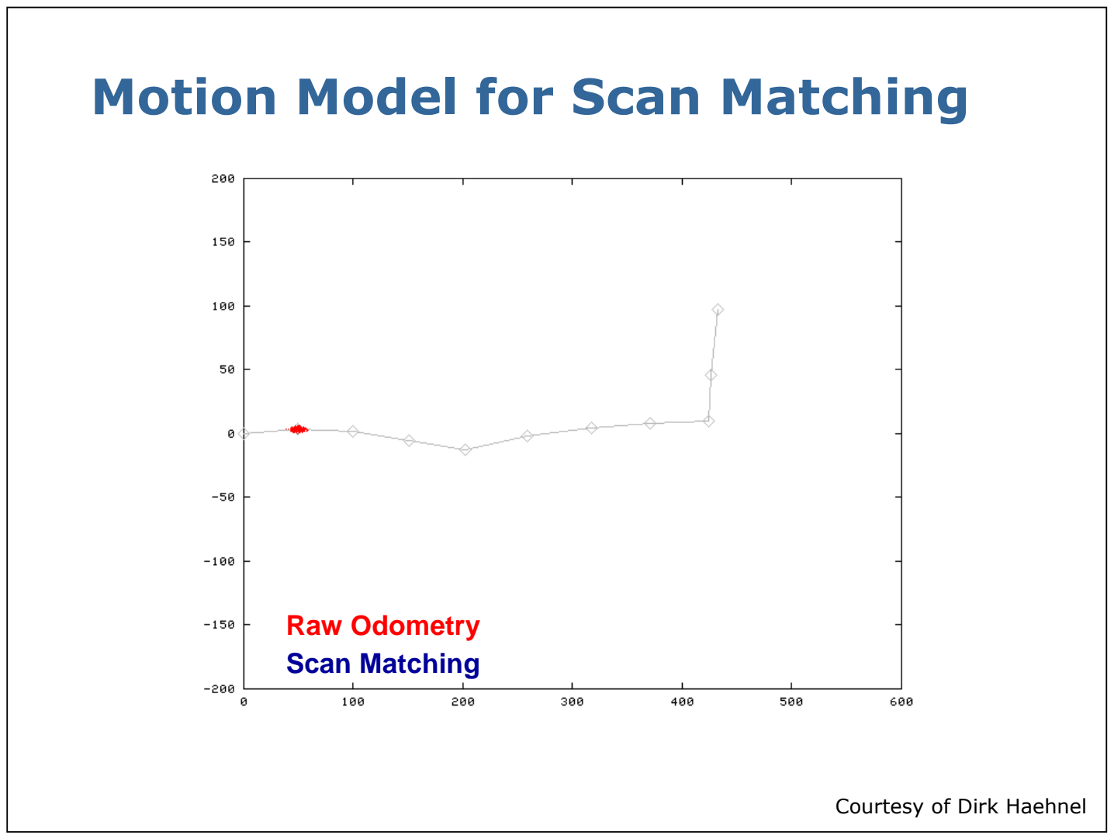
[picture p162: page 25]

Raw Odometry
Scan Matching

Courtesy of Dirk Haehnel

## Mapping using Scan Matching

Courtesy of Dirk Haehnel

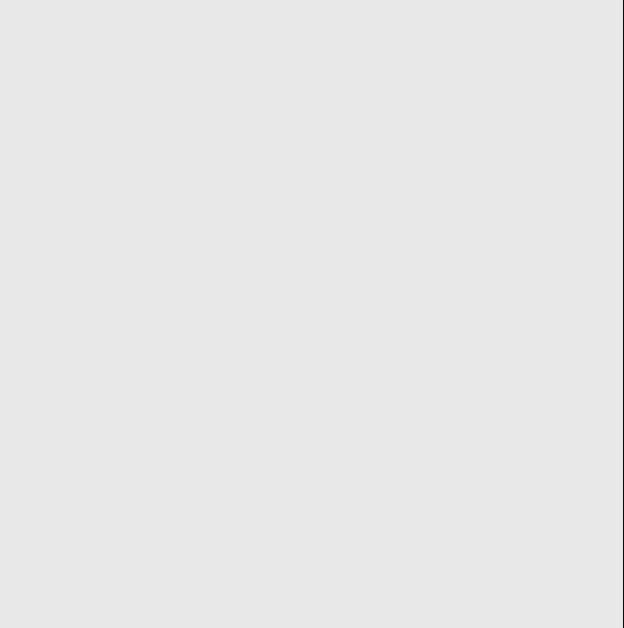
[picture p163: figure]

[video]

## RBPF-SLAM with Improved Odometry

ß Scan-matching provides a locally consistent pose correction

ß Pre-correct short odometry sequences using scan-matching and use them as input to the Rao-Blackwellized PF

ß Fewer particles are needed, since the error in the input in smaller

[Haehnel et al., 2003]

## RBPF-SLAM with Scan-Matching

M

a

p: I

n

t

el R

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
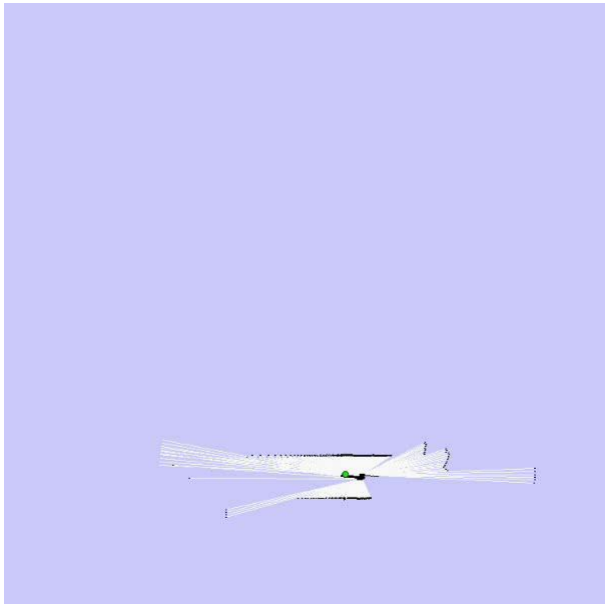
[picture p164: figure]

Courtesy of Dirk Haehnel [video]

## Graphical Model for Mapping with Improved Odometry

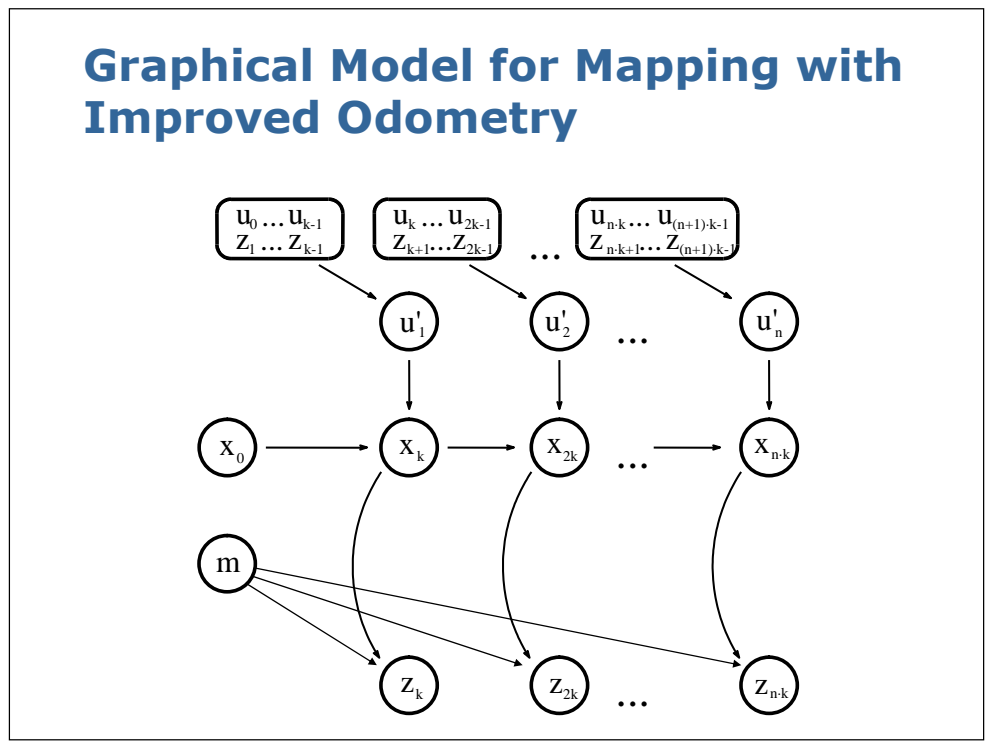
[picture p165: page 29]

Comparison to Standard RBPF-SLAM

ß Same model for observations
ß Odometry instead of scan matching as input ß Number of particles varying from 500 to 2.000 ß Typical result:

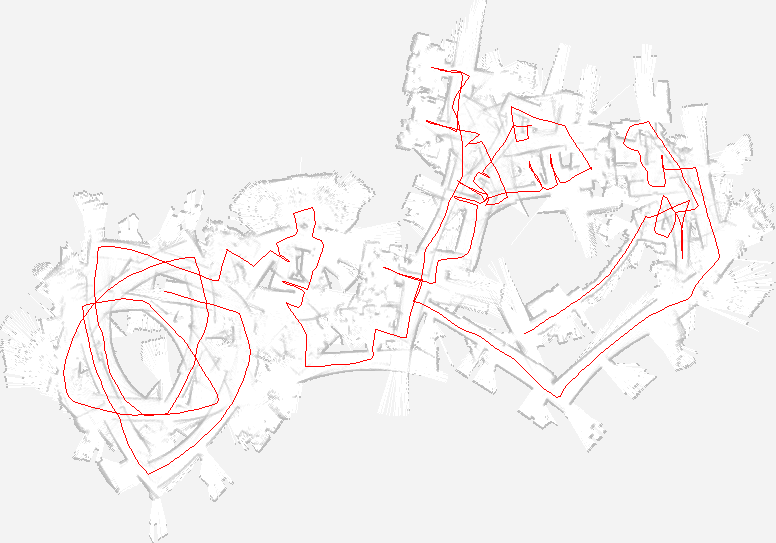
[picture p166: figure]

Courtesy of Dirk Haehnel

## Conclusion (so far…)

n The presented approach is efficient
n It is easy to implement
n Scan matching is used to transform sequences of laser measurements into odometry measurements n Provides good results for most datasets

## What’s Next?

n Further reduce the number of particles n Improved proposals will lead to more accurate maps
n Use the properties of our sensor when drawing the next generation of particles

## The Optimal Proposal Distribution

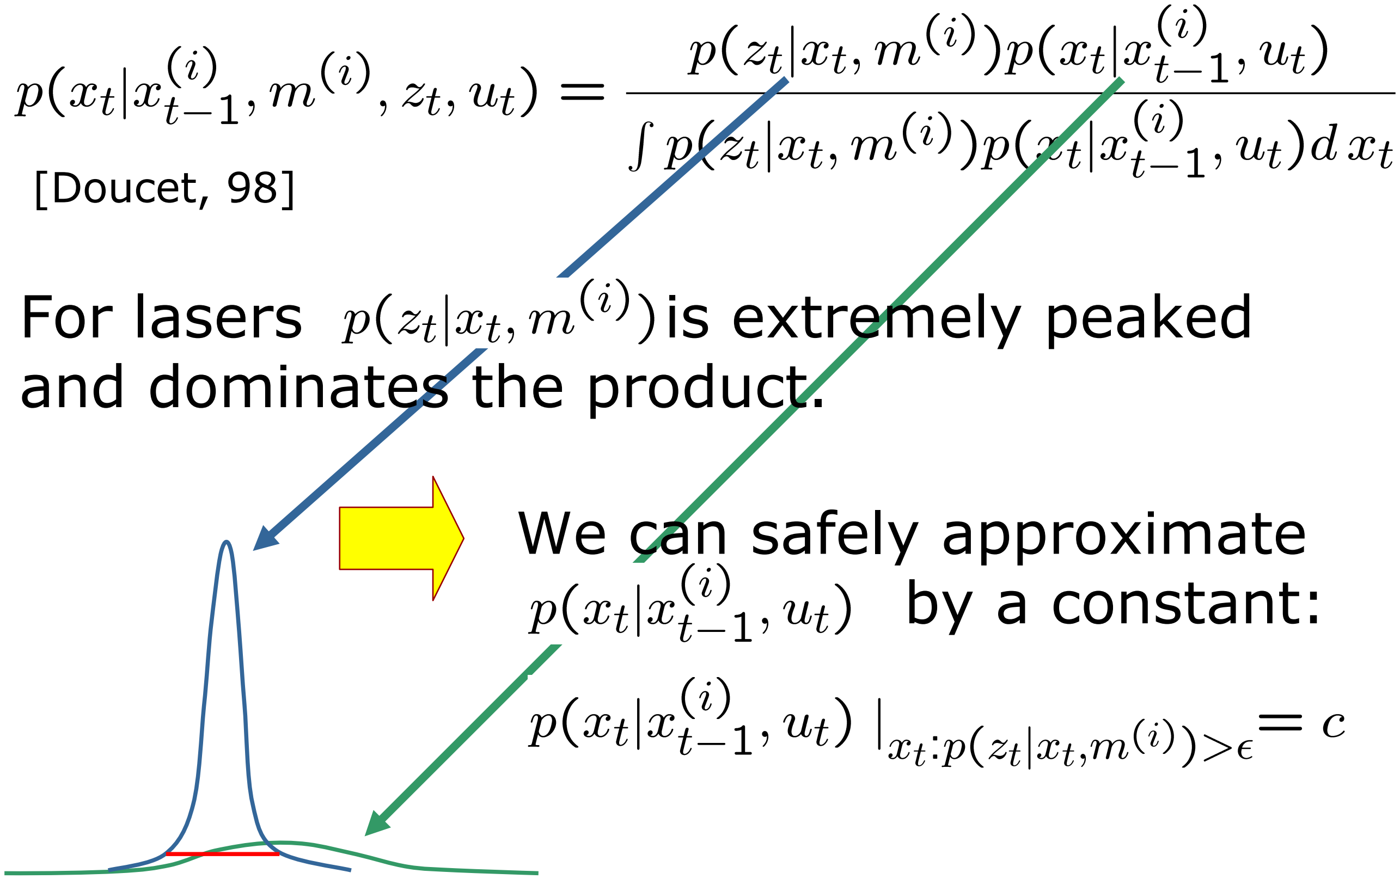
[picture p167: figure]
For lasers; is extremely peaked; and dominates the product.; [Doucet, 98]; We can safely approximate by a constant:

## Resulting Proposal Distribution

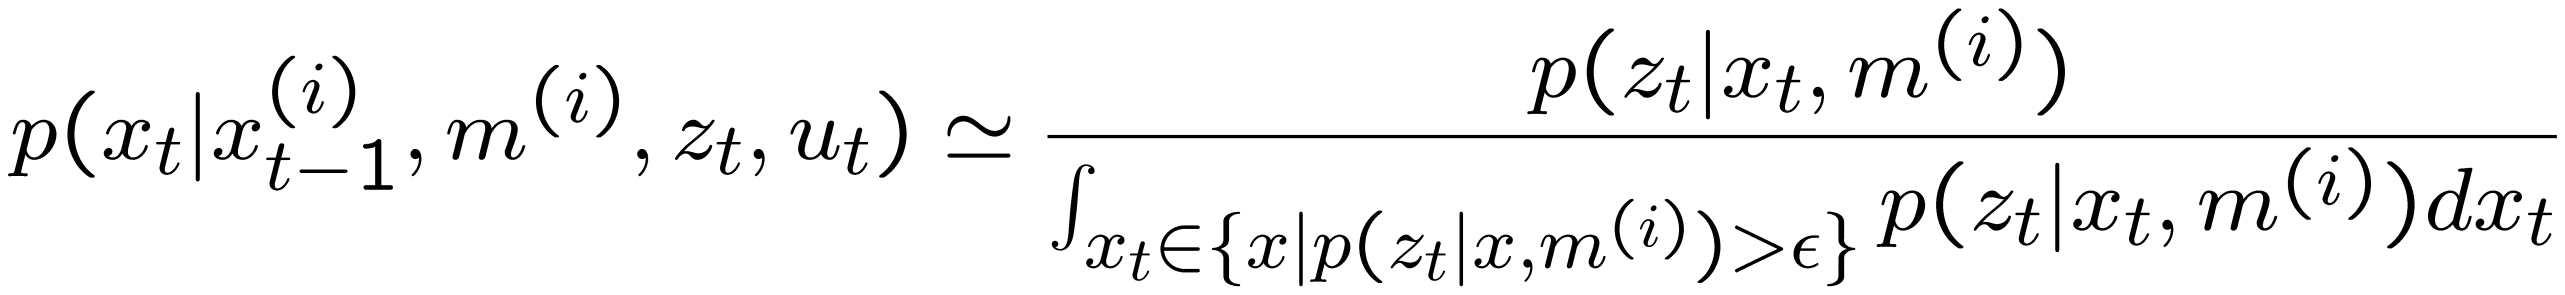
[picture p168: figure]

Approximate this equation by a Gaussian:

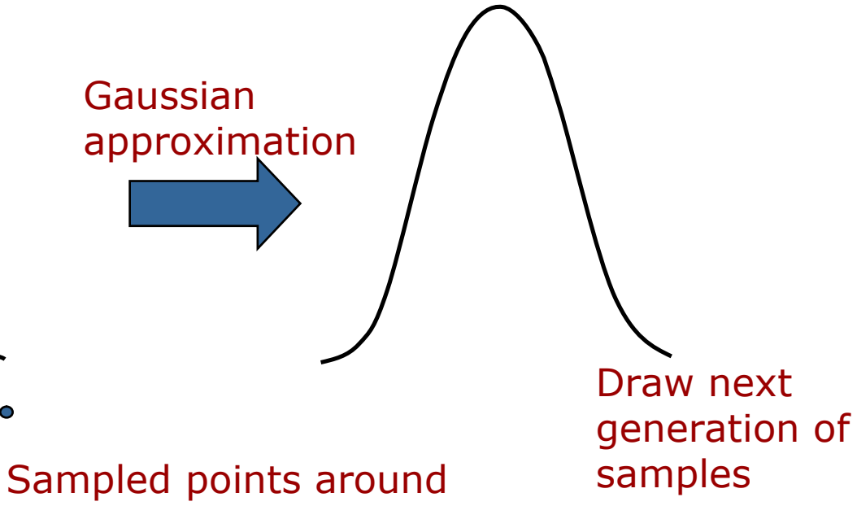
[picture p169: figure]
Sampled points around; Gaussian approximation; Draw next generation of samples
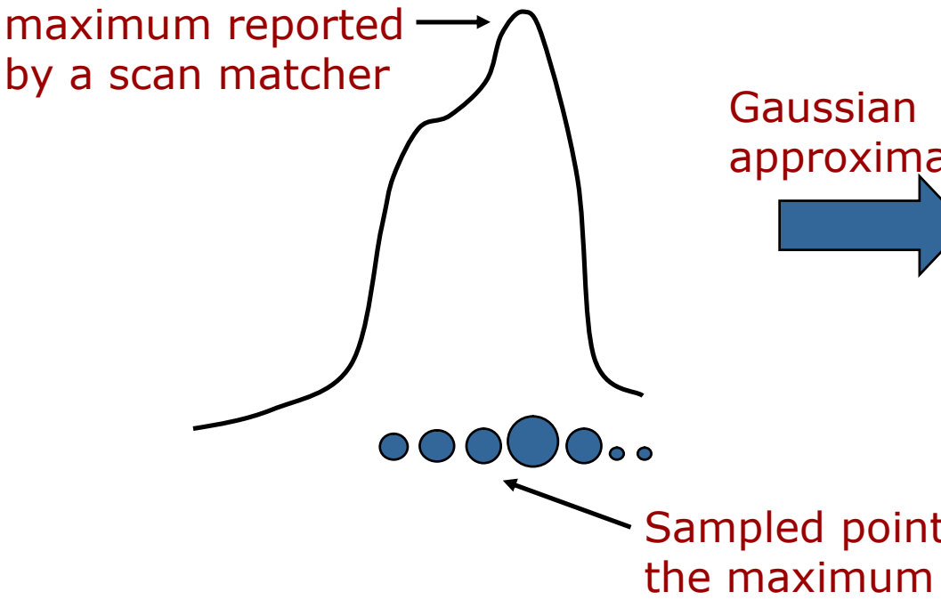
[picture p170: figure]
the maximum; maximum reported by a scan matcher

## Resulting Proposal Distribution

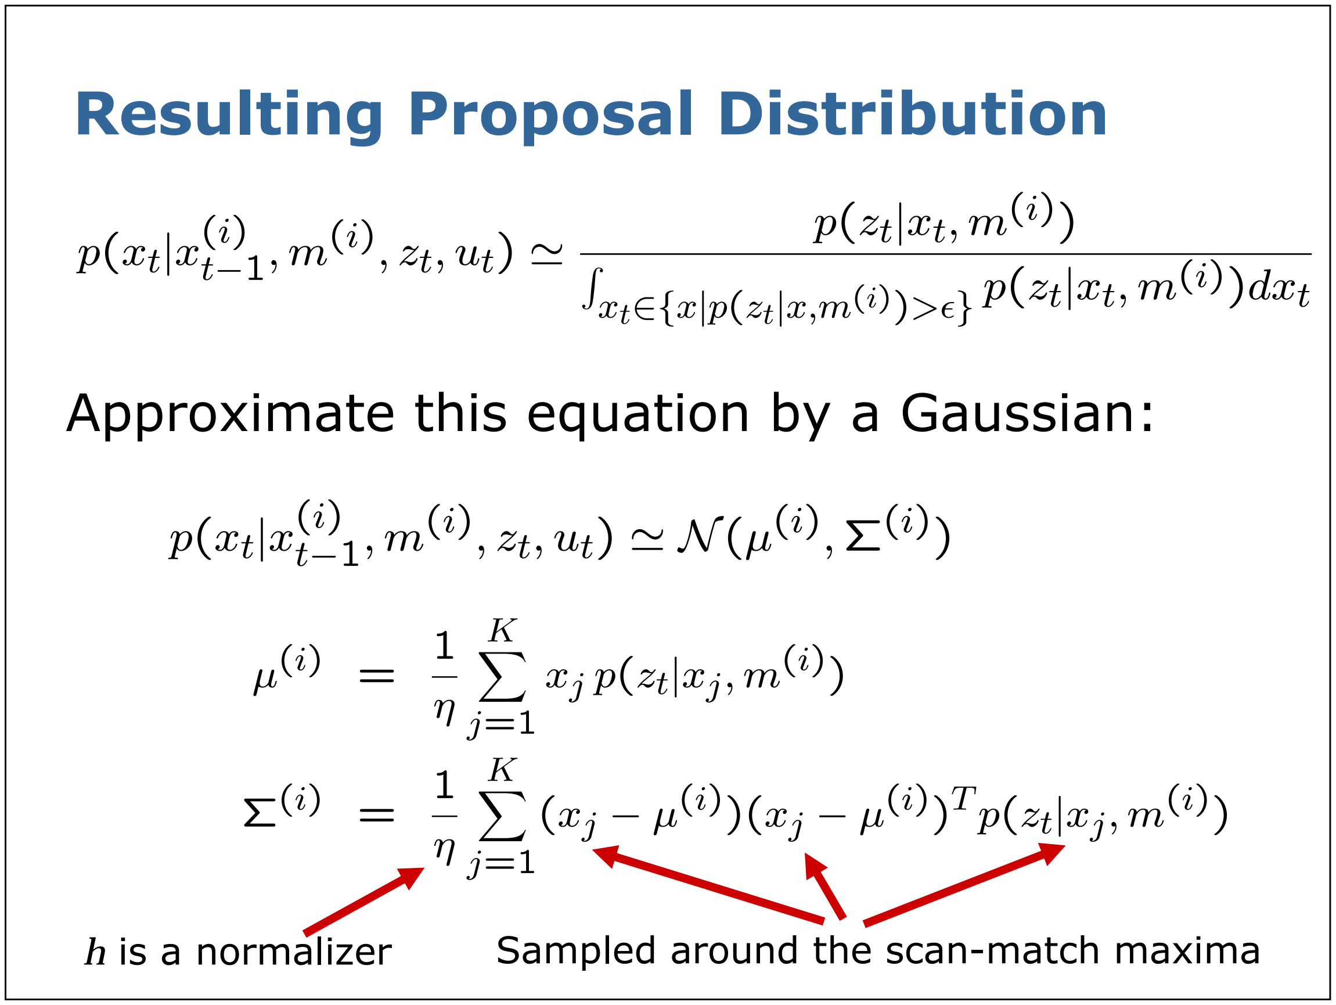
[picture p171: page 35]

h is a normalizer Sampled around the scan-match maxima

Approximate this equation by a Gaussian:

## Computing the Importance Weight

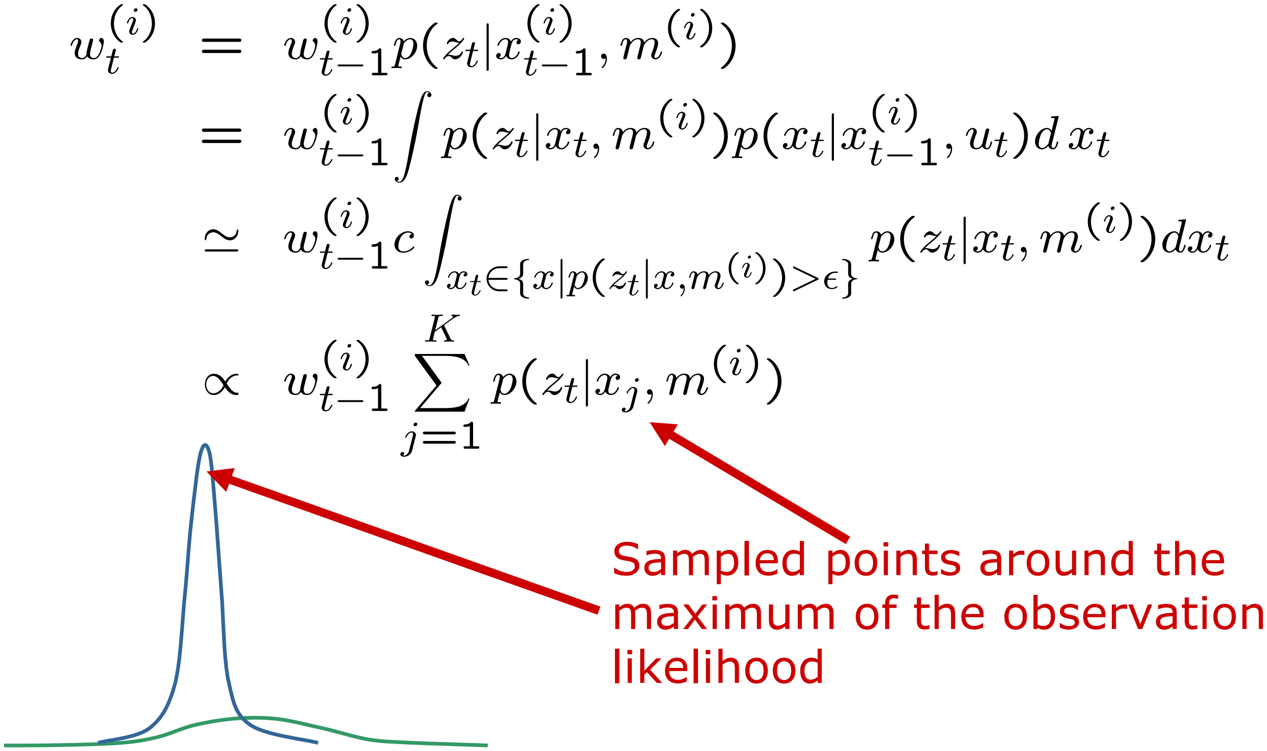
[picture p172: figure]
Sampled points around the maximum of the observation likelihood

## Improved Proposal

End of a corridor:

Corridor:

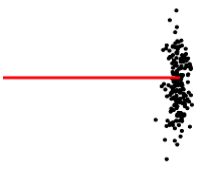
[picture p173: figure]

Free space:

## Resampling

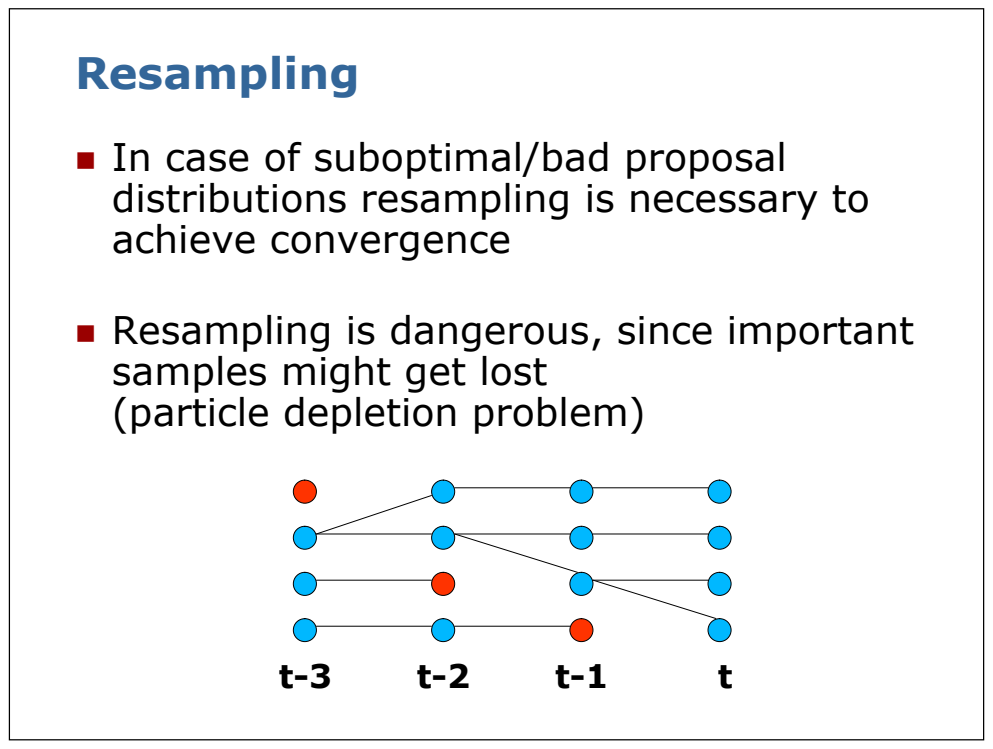
[picture p174: page 38]

n In case of suboptimal/bad proposal
distributions resampling is necessary to
achieve convergence

n Resampling is dangerous, since important
samples might get lost
(particle depletion problem)

## When to Resample?

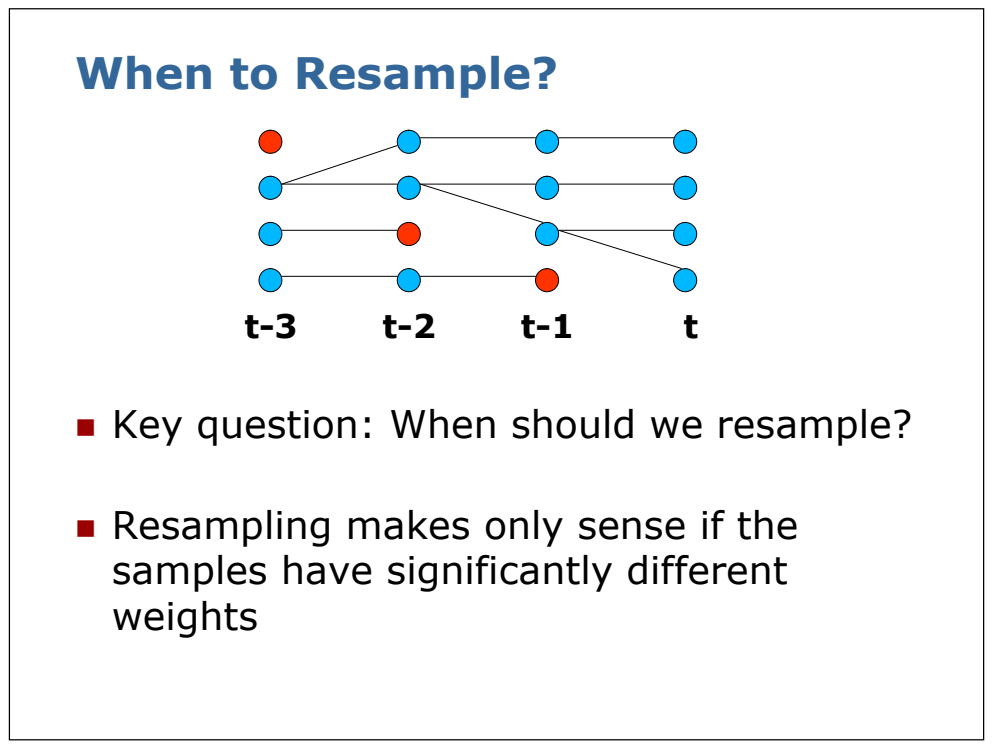
[picture p175: page 39]

n Key question: When should we resample?

n Resampling makes only sense if the
samples have significantly different
weights

## Effective Number of Particles

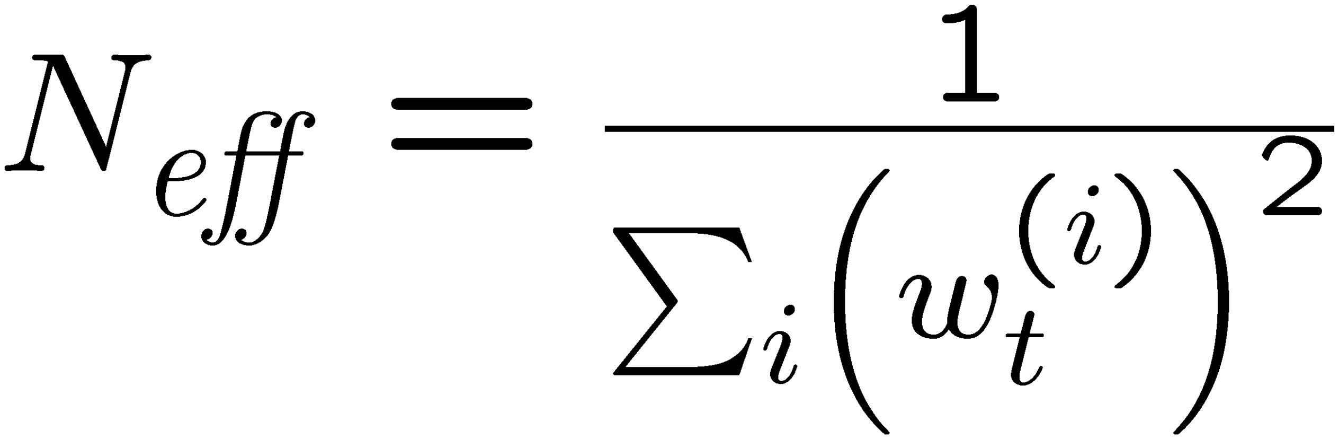
[picture p176: figure]

nEmpirical measure of how well the goal distribution is approximated by samples
drawn from the proposal
n Neff describes “the variance of the particle weights” n Neff is maximal for equal weights. In this case, the distribution is close to the proposal

## Resampling with Neff

n If our approximation is close to the proposal, no resampling is needed

n We only resample when Neff drops below a given threshold (N/2)

n See [Doucet,

’98; Arulampalam,

’01]

## Typical Evolution of Neff

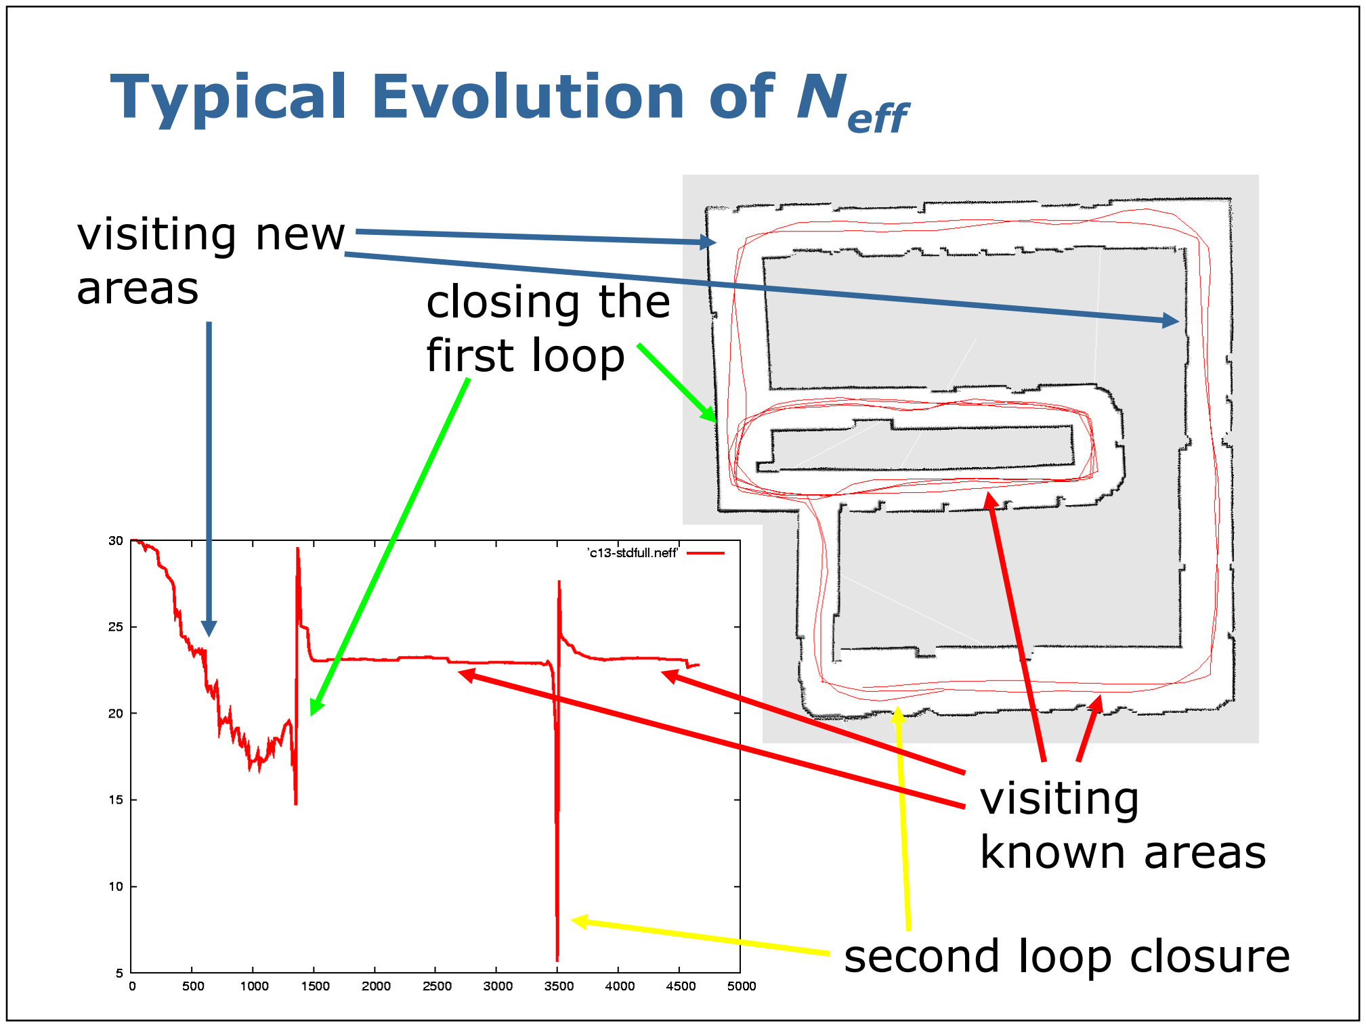
[picture p177: page 42]

visiting new
areas | closing the
| first loop

second loop closure

visiting
known areas

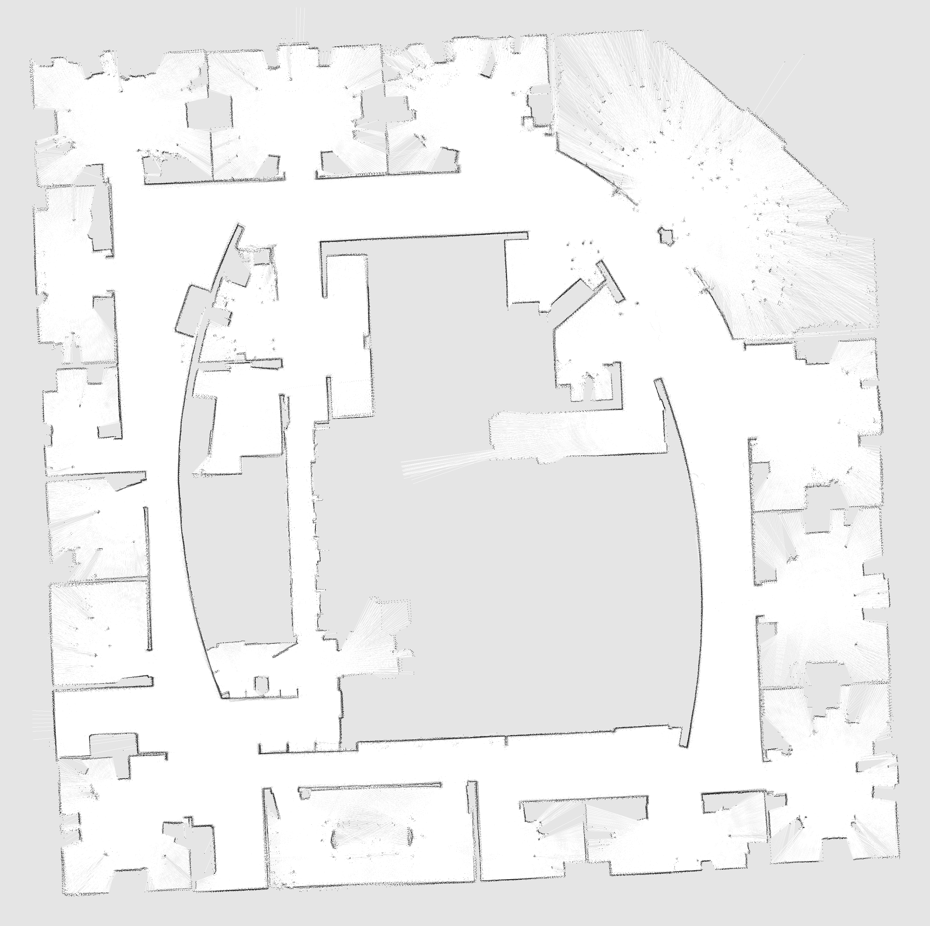
[picture p178: figure]

ß 15 particles
ß four times faster
than real-time
P4, 2.8GHz
ß 5cm resolution
during scan
matching
ß 1cm resolution in
final map

## Intel Research Lab

[video]

## Outdoor Campus Map

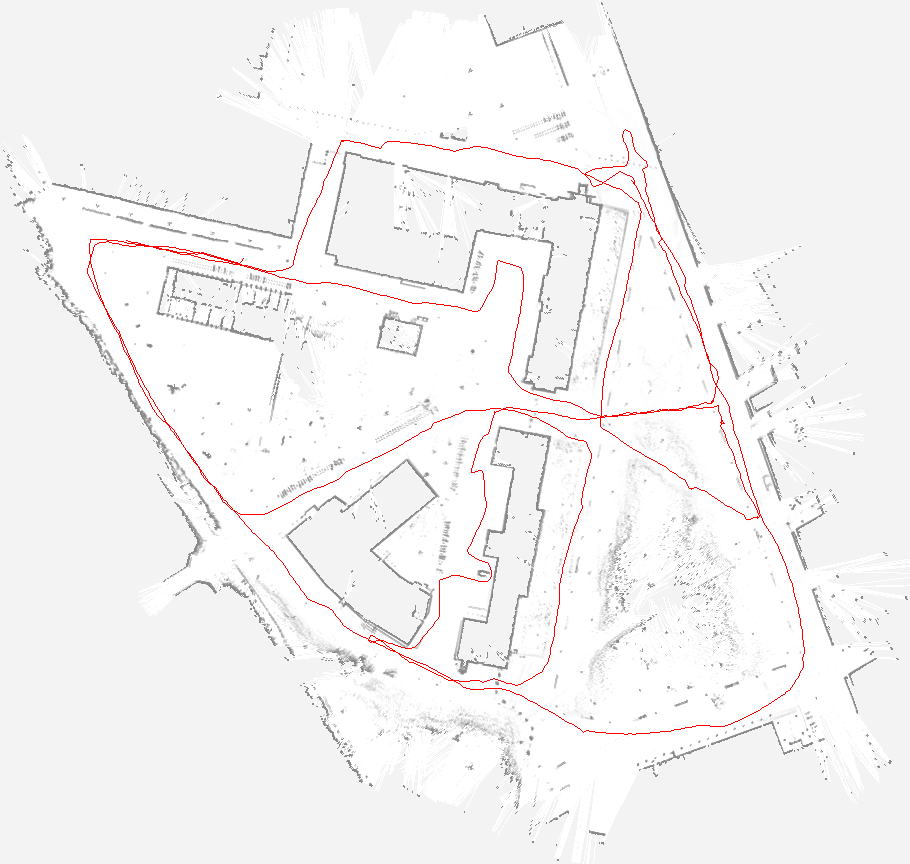
[picture p179: figure]

ß 30 particles
ß 250x250m²
ß 1.75 km
(odometry)
ß 20cm resolution
during scan
matching
ß 30cm resolution
in final map

ß 30 particles
ß 250x250m²
ß 1.088 miles
(odometry)
ß 20cm resolution
during scan
matching
ß 30cm resolution
in final map

[video]

## MIT Killian Court

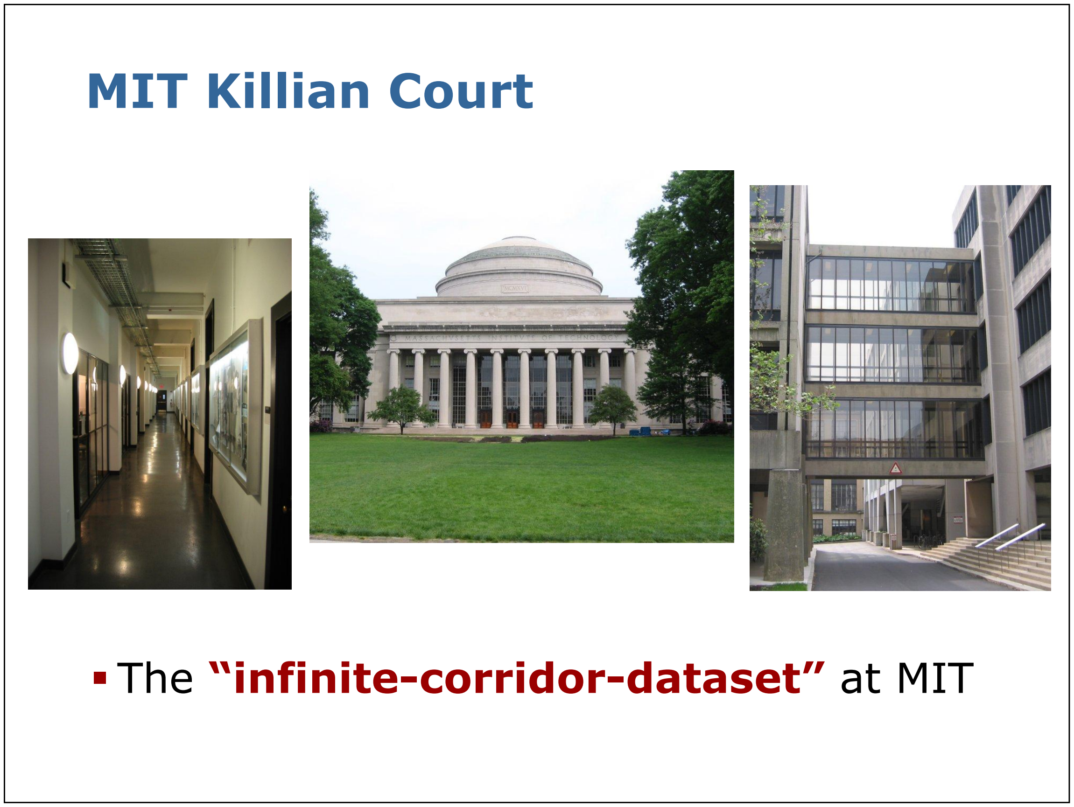
[picture p180: page 45]

ß The “infinite-corridor-dataset” at MIT

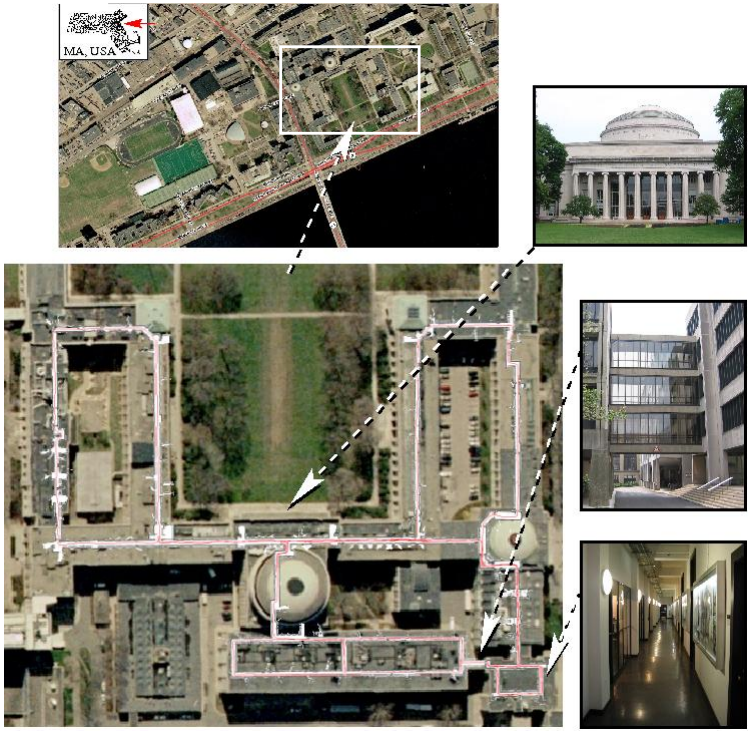
[picture p181: figure]

## MIT Killian Court

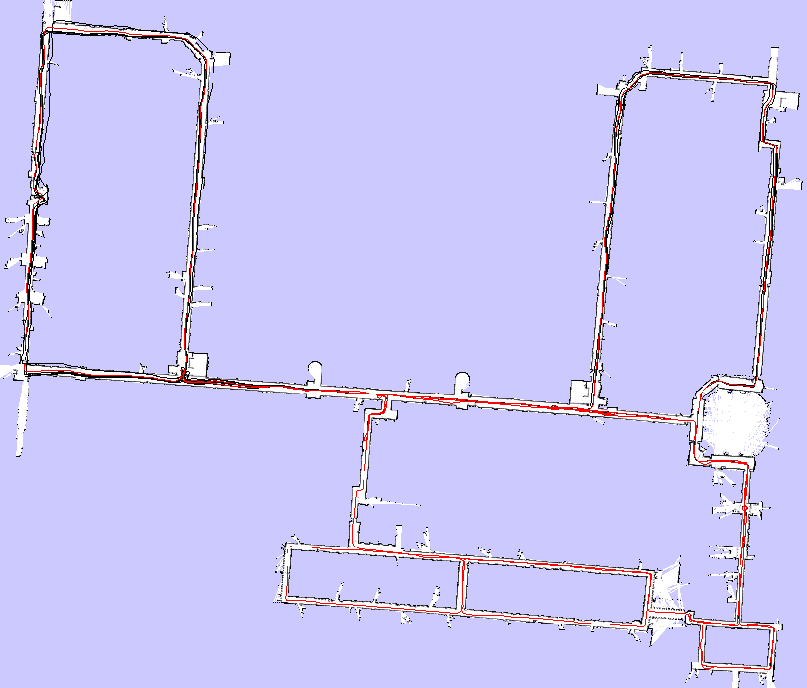
[picture p182: page 47]

## MIT Killian Court

Dataset courtesy of Mike Bosse and John Leonard

[

video]

## Problems of the Gaussian Proposal

n Gaussians are uni-model distributions
n In case of loop-closures, the likelihood function might be multi-modal

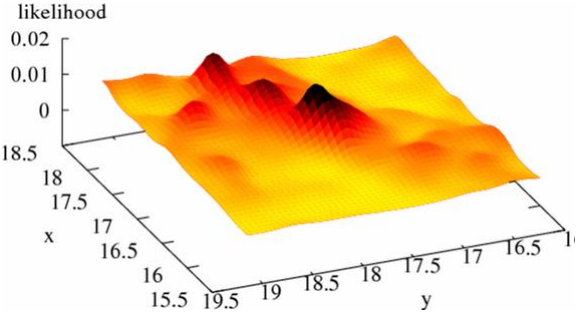
[picture p183: figure]

## Is a Gaussian an Accurate Representation for the Proposal?

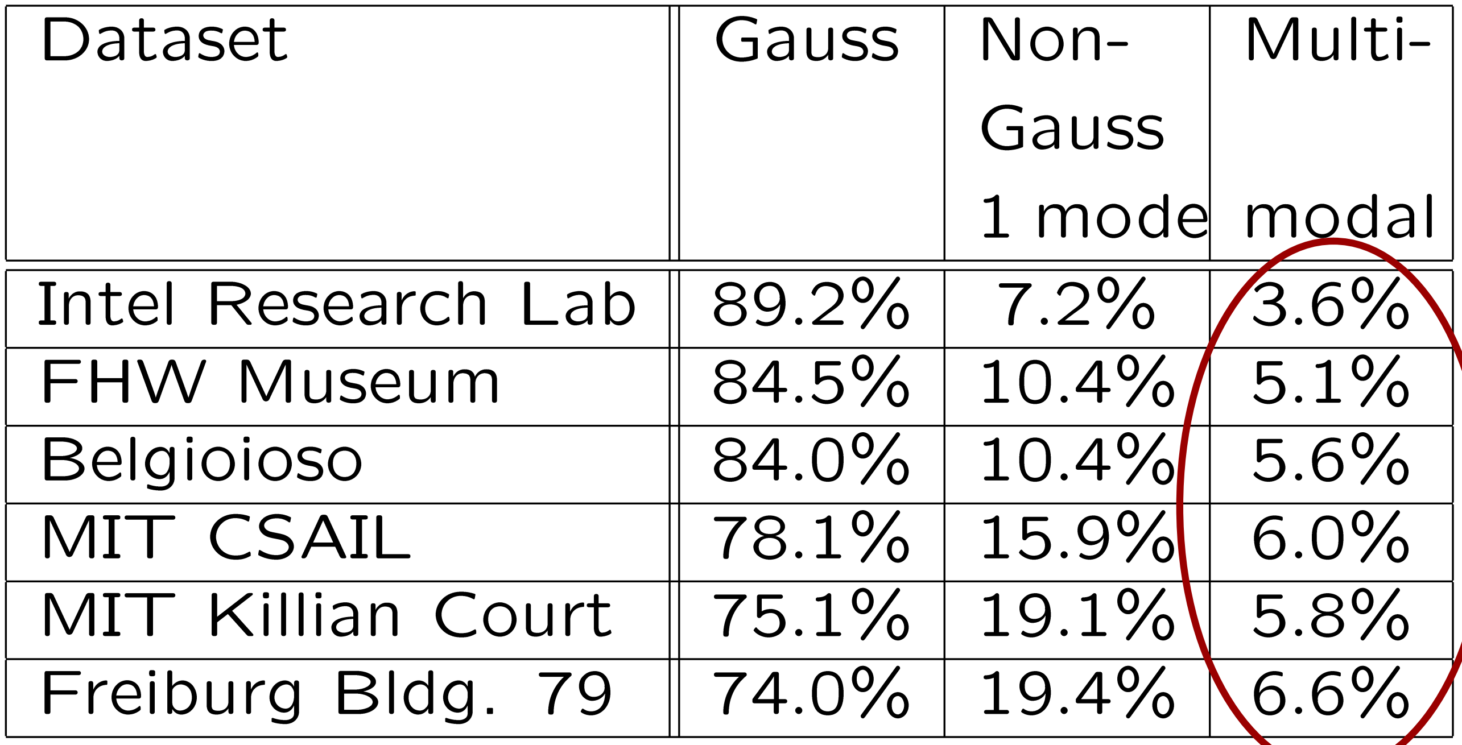
[picture p184: figure]

## Problems of the Gaussian Proposal

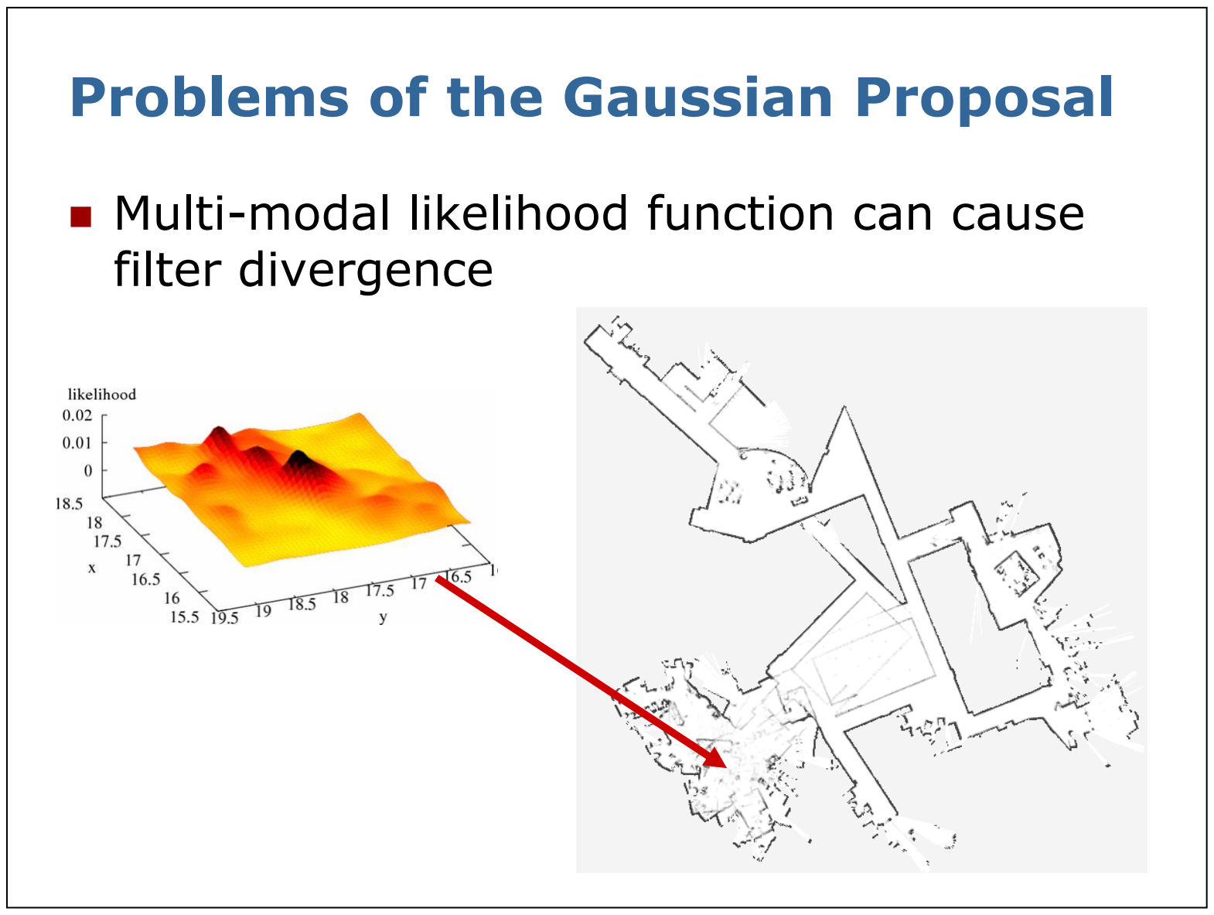
[picture p185: page 50]

n Multi-modal likelihood function can cause filter divergence

## n Sampling from the optimal proposal:

n Compute the full 3d histogram
n Sample from the histogram

## How to Overcome this Limitation?

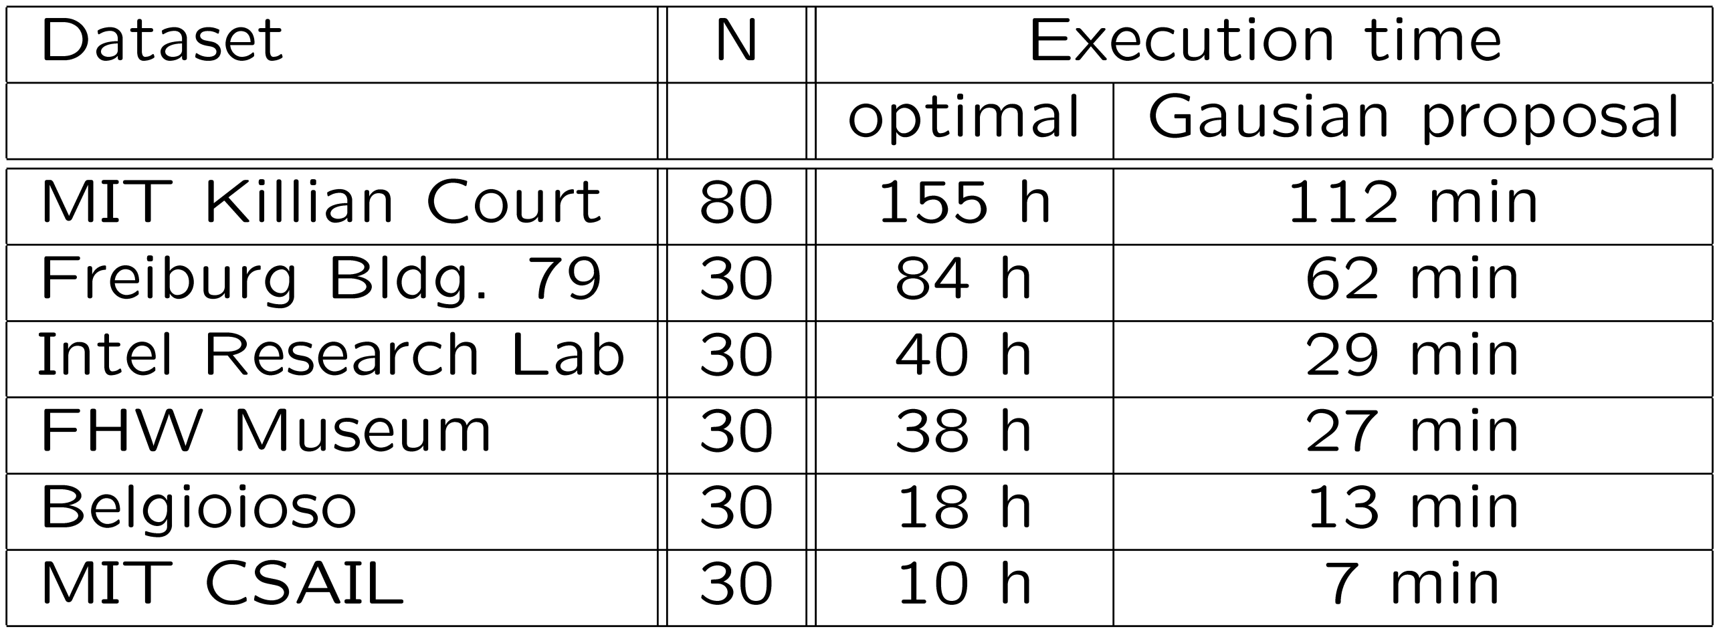
[picture p186: figure]

## How to Overcome this Limitation?

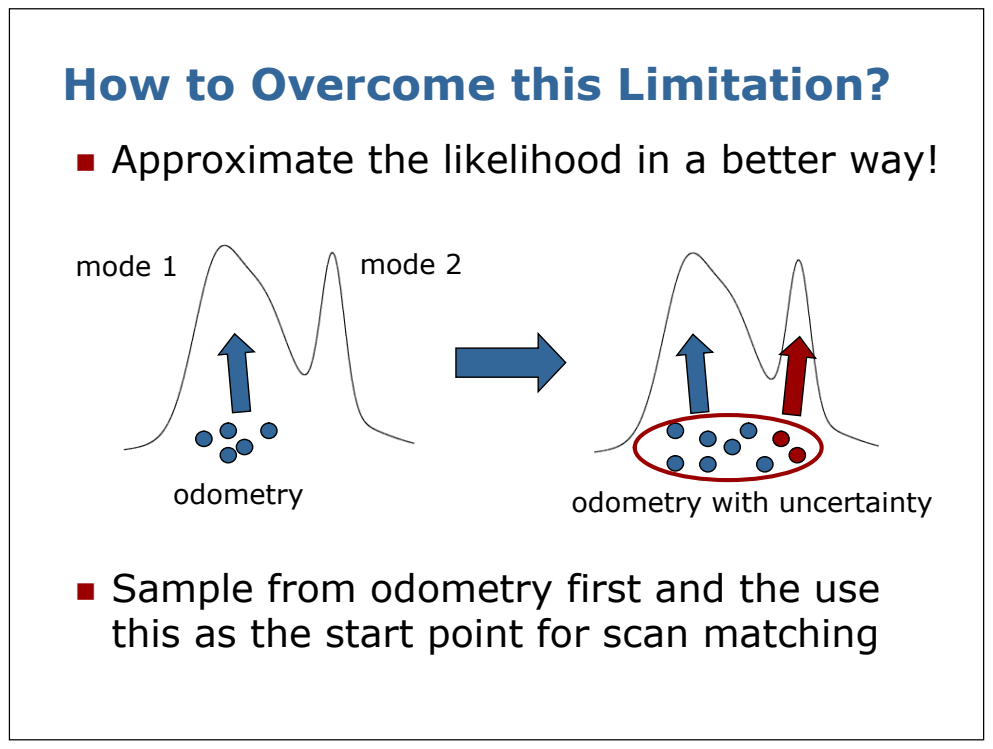
[picture p187: page 52]
mode 1; mode 2

n Approximate the likelihood in a better way!

odometry
n Sample from odometry first and the use
this as the start point for scan matching

odometry with uncertainty

## Final Approach

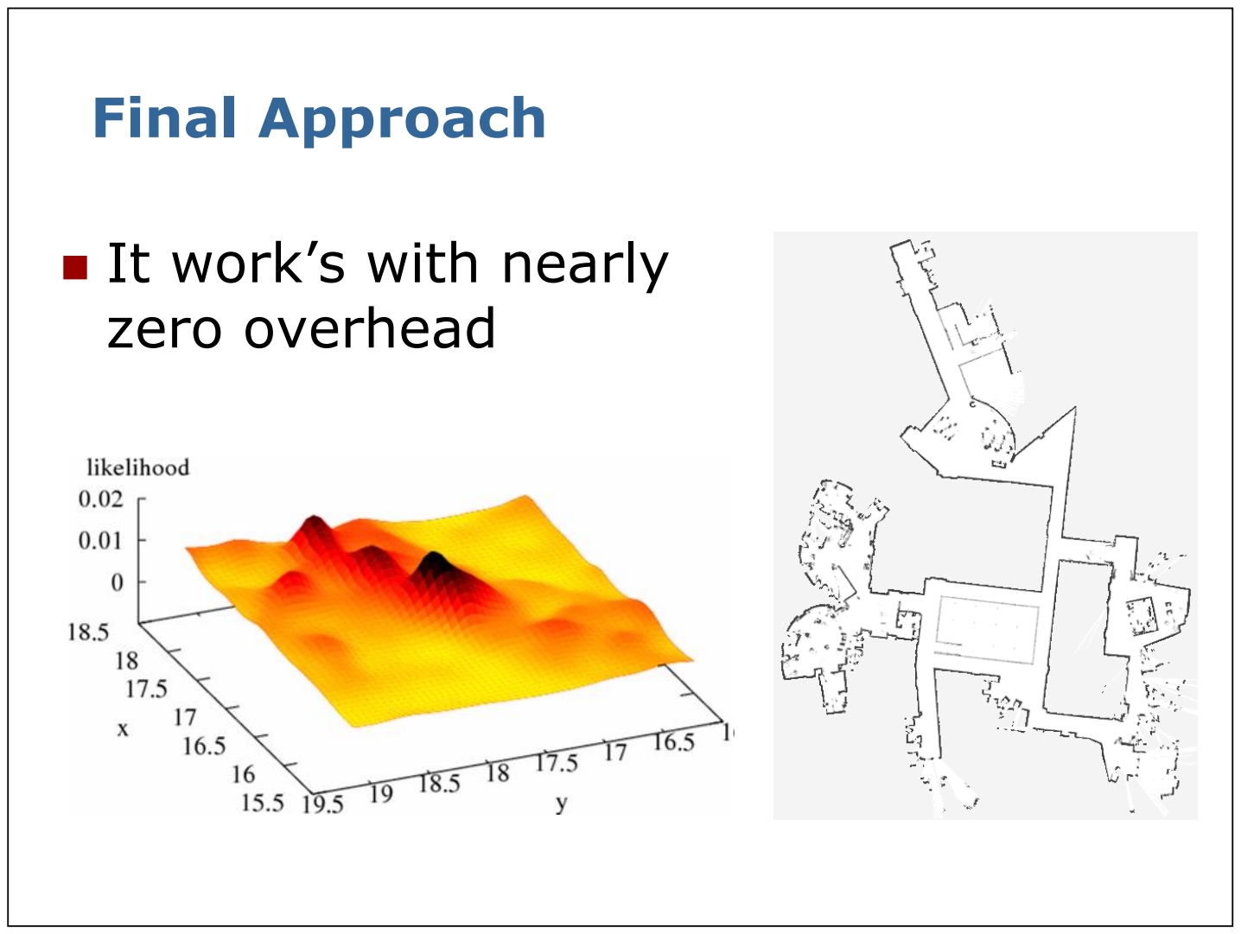
[picture p188: page 53]

## n It work’s with nearly zero overhead

## Conclusion

n Rao-Blackwellized Particle Filters are means to represent a joint posterior about the poses of the robot and the map
n Utilizing accurate sensor observation leads to good proposals and highly efficient filters
n It is similar to scan-matching on a per-particle base with some extra noise
n The number of necessary particles and re-sampling steps can seriously be reduced
n How to deal with non-Gaussian observation likelihood functions
n Highly accurate and large scale map

## More Details

n M. Montemerlo, S. Thrun, D. Koller, and B. Wegbreit. FastSLAM: A factored solution to simultaneous localization and mapping, AAAI02 (The classic FastSLAM paper with landmarks)

n M. Montemerlo, S. Thrun D. Koller, and B. Wegbreit. FastSLAM 2.0: An improved particle filtering algorithm for simultaneous localization and mapping that provably converges, IJCAI03.
(FastSLAM 2.0 – improved proposal for FastSLAM)

n D. Haehnel, W. Burgard, D. Fox, and S. Thrun. An efcient FastSLAM algorithm for generating maps of large-scale cyclic environments from raw laser range measurements, IROS03
(FastSLAM on grid-maps using scan-matched input)

n A. Eliazar and R. Parr. DP-SLAM: Fast, robust simultainous localization and mapping without predetermined landmarks, IJCAI03 (A representation to handle big particle sets)

## More Details (Own Work)

n Giorgio Grisetti, Cyrill Stachniss, and Wolfram Burgard. Improved Techniques for Grid Mapping with Rao-Blackwellized Particle Filters, Transactions on Robotics, Volume 23, pages 34-46, 2007 (Informed proposal using laser observation, adaptive resampling)

n G. Grisetti, C. Stachniss, and W. Burgard. Improving grid-based slam with rao-blackwellized particle filters by adaptive proposals and selective resampling, ICRA’05
(Informed proposal using laser observation, adaptive resampling)

n Cyrill Stachniss, Grisetti Giorgio, Wolfram Burgard, and Nicholas Roy. Analyzing Gaussian Proposal Distributions for Mapping with Rao-Blackwellized Particle Filters, IROS07
(Gaussian assumption for computing the improved proposal)

## From Theory to Practice

### n Implementation available a open source project “GMapping” on www.OpenSLAM.org

### n Written in C++ n Can be used as a black box library

### Now: 1h Practical Course on GMapping
