jochenalt/Pentapod-Design/docs/images/assembly-add-hip.jpg

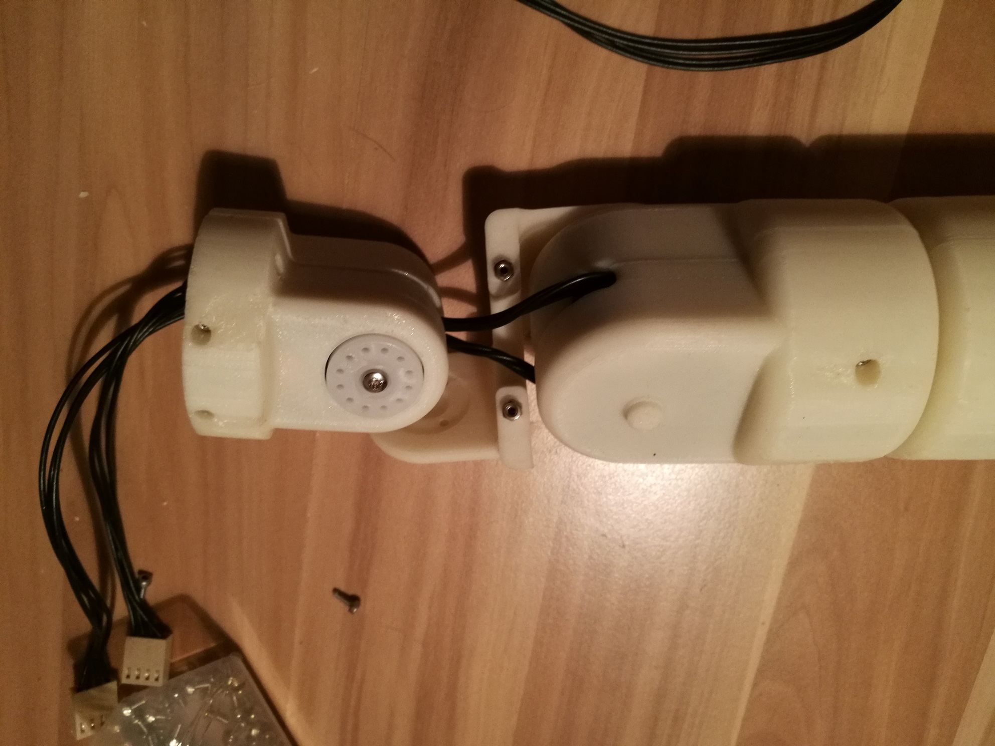
docs/images/assembly-add-hip.jpg
