jochenalt/Pentapod-Design/docs/images/coordinatesystem old.pdf

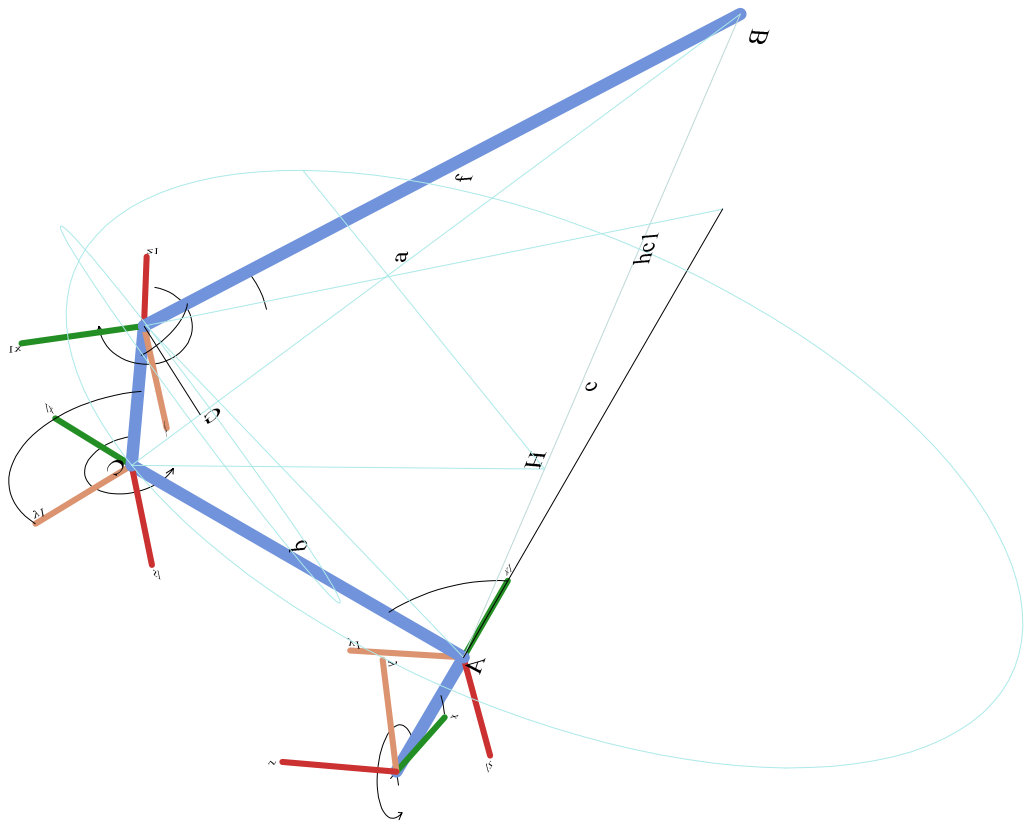
[picture p190: page 1]
