jochenalt/Pentapod-Design/docs/images/IK femur computation old.pdf

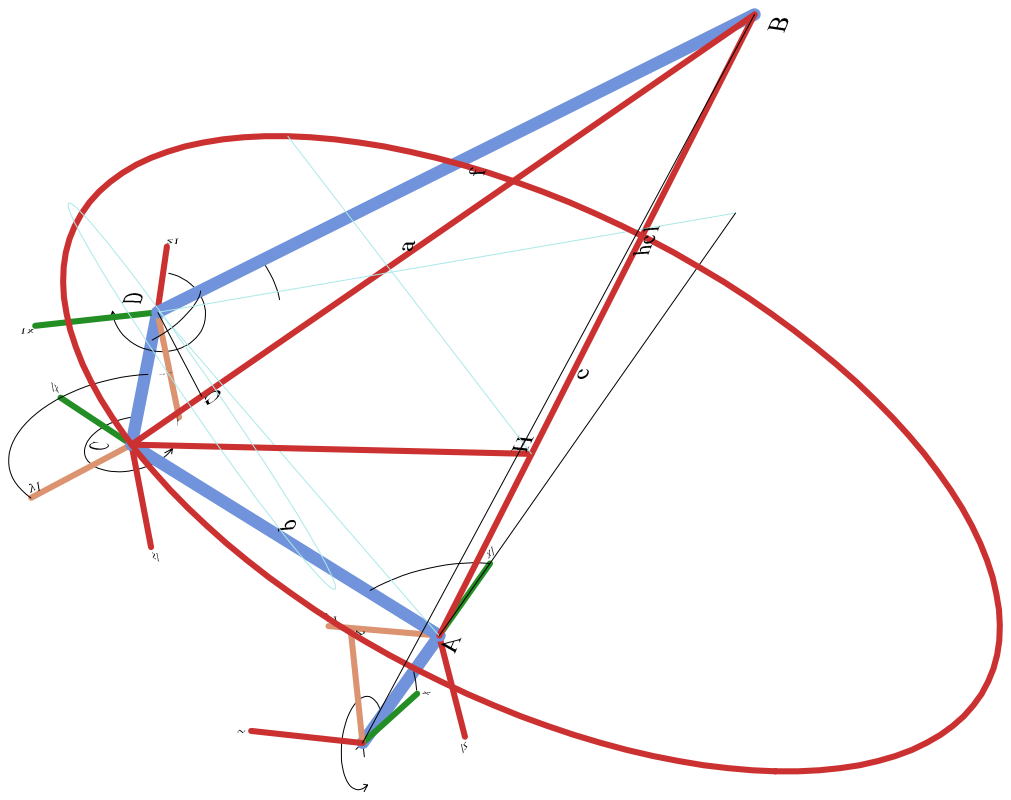
[picture p191: page 1]
