jochenalt/Pentapod-Design/docs/images/IK tibia computation old.pdf

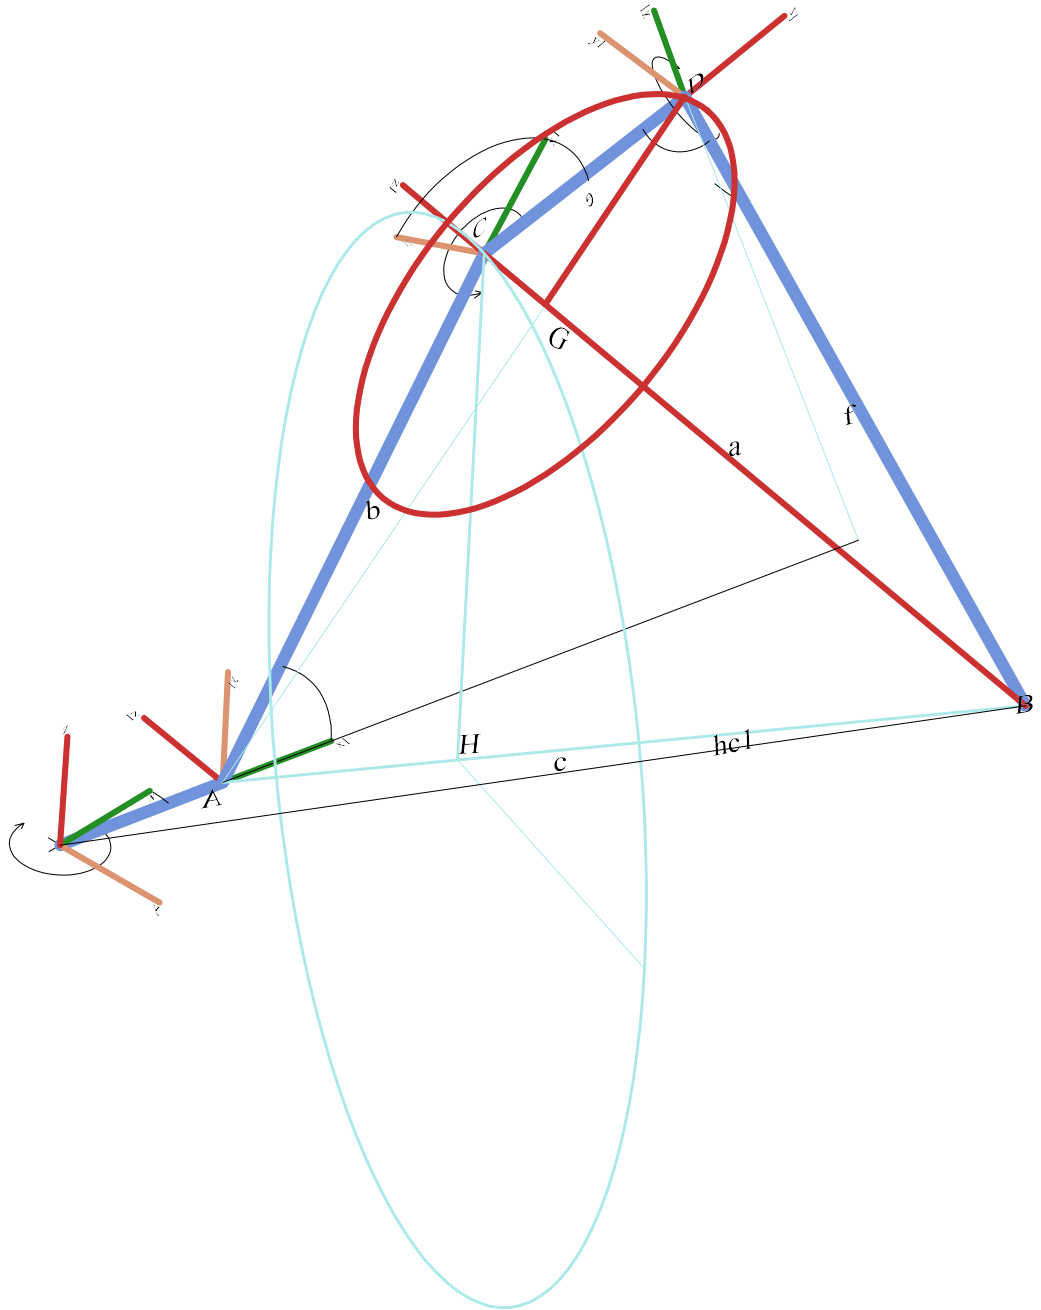
[picture p192: page 1]
