jochenalt/Pentapod-Design/(list of files, drawings)

Other design files:
schematics/CortexBoard/CortexBoard.dsn
