jochenalt/Pentapod-Design/schematics/CortexBoard/CortexBoard.kicad_pcb

## KiCad design schematics/CortexBoard/CortexBoard.kicad_pcb (2017-10-16)

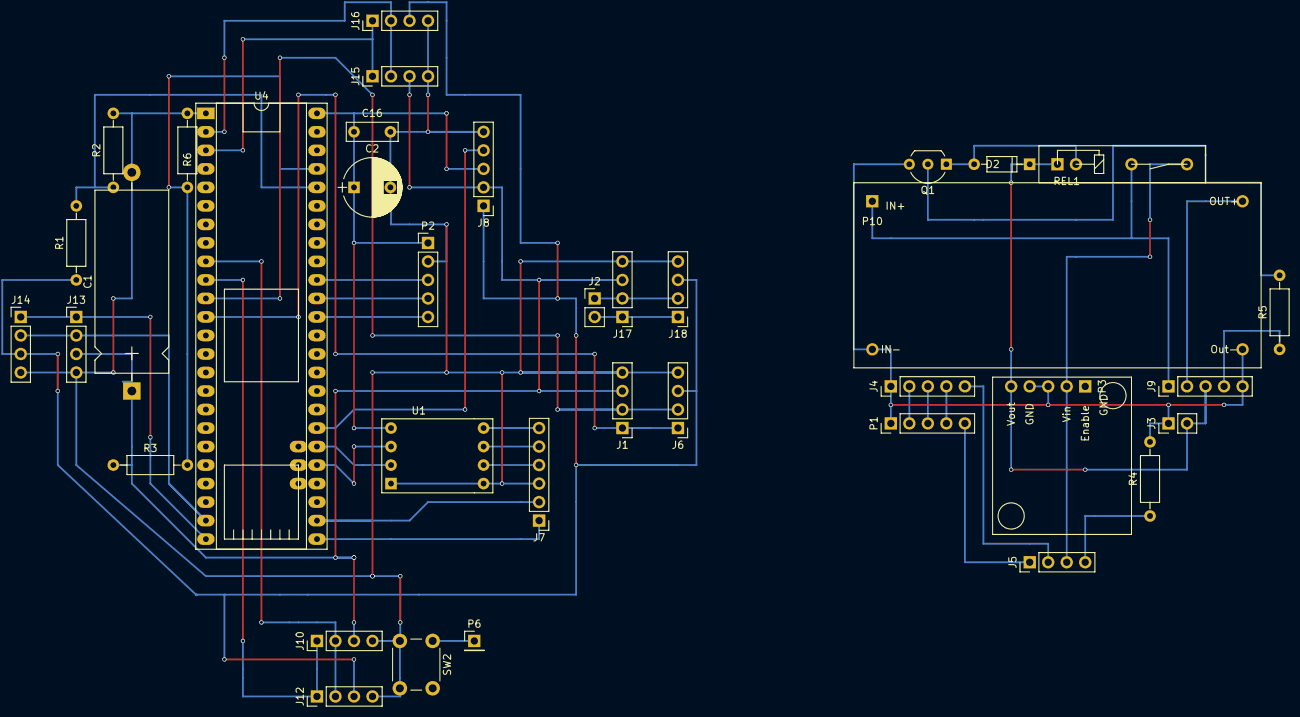
[picture p193: board CortexBoard.kicad_pcb from above]

Board: 2 copper layers, 37 parts (0 on the bottom side), 42 nets.

Parts:
C1: 2200uF; CP_Axial_L25.0mm_D10.0mm_P30.00mm_Horizontal
C2: 220uF; CP_Radial_D8.0mm_P5.00mm
C16: 100nF; C_Rect_L7.0mm_W2.5mm_P5.00mm
D2: D_Schottky; D_DO-35_SOD27_P7.62mm_Horizontal
J1: LEG1-LO; Pin_Header_Straight_1x04_Pitch2.54mm
J2: UART6 Connector; Pin_Header_Straight_1x02_Pitch2.54mm
J3: Odroid Power; Pin_Header_Straight_1x02_Pitch2.54mm
J4: Bodysocket; Pin_Header_Straight_1x05_Pitch2.54mm
J5: LED/Switch; Pin_Header_Straight_1x04_Pitch2.54mm
J6: LEG1-HI; Pin_Header_Straight_1x04_Pitch2.54mm
J7: CORTEX CLI; Pin_Header_Straight_1x06_Pitch2.54mm
J8: Cortex-Power-In; Pin_Header_Straight_1x05_Pitch2.54mm
J9: Cortex-Power-Out; Pin_Header_Straight_1x05_Pitch2.54mm
J10: LEG2-LO; Pin_Header_Straight_1x04_Pitch2.54mm
J12: LEG2-HI; Pin_Header_Straight_1x04_Pitch2.54mm
J13: LEG3-LO; Pin_Header_Straight_1x04_Pitch2.54mm
J14: LEG3-HI; Pin_Header_Straight_1x04_Pitch2.54mm
J15: LEG4-LO; Pin_Header_Straight_1x04_Pitch2.54mm
J16: LEG4-HI; Pin_Header_Straight_1x04_Pitch2.54mm
J17: LEG5-LO; Pin_Header_Straight_1x04_Pitch2.54mm
J18: LEG5-HI; Pin_Header_Straight_1x04_Pitch2.54mm
P1: Battery; Pin_Header_Straight_1x05_Pitch2.54mm
P2: BNO055; Pin_Header_Straight_1x05_Pitch2.54mm
P3: D24V50F5; Pololu_D24V50F5
P6: Teensy RST(49); Pin_Header_Straight_1x01_Pitch2.54mm
P10: XL4015
Q1: BC337(o.ä.); TO-92_Inline_Wide
R1, R3: 150K; R_Axial_DIN0207_L6.3mm_D2.5mm_P10.16mm_Horizontal
R2, R6: 10K; R_Axial_DIN0207_L6.3mm_D2.5mm_P10.16mm_Horizontal
R4: 3.3K; R_Axial_DIN0207_L6.3mm_D2.5mm_P10.16mm_Horizontal
R5: 1K; R_Axial_DIN0207_L6.3mm_D2.5mm_P10.16mm_Horizontal
REL1: HF49FD; Relay_HF49FD
SW2: reset; SW_PUSH_6mm
U1: I2C_LevelShifter
U4: Teensy_3.5

Connections:
/3.3V_ODroid: J7.6, U1.8
/+5V: D2.1, J3.2, J9.3, P3.5, REL1.1
/+10V: C1.1, J1.3, J8.2, J10.3, J13.3, J15.3, J17.3, R3.1
/+14V: J6.3, J8.1, J12.3, J14.3, J16.3, J18.3, R1.1
/Batt1: J4.2, P1.2
/Batt2: J4.3, P1.3
/Batt3: J4.4, P1.4
/Batt+: J4.5, J5.2
/Batt-: J3.1, J4.1, J9.5, P1.1, P3.3, P3.4, P10.2, P10.3, Q1.3, R4.2
/GND: C1.2, C2.2, C16.2, J1.4, J6.4, J7.3, J8.5, J10.4, J12.4, J13.4, J14.4, J15.4, J16.4, J17.4, J18.4, P2.2, R2.2, R6.2, SW2.2, U1.1, U1.5, U4.1, U4.34
/LEDKathode: J5.4, R4.1
/RST: P2.5, U4.37
/RX1: J15.1, J16.1, U4.3
/RX2: J1.1, J6.1, U4.12
/RX3: J10.1, J12.1, U4.10
/RX4: J13.1, J14.1, U4.24
/RX5: J7.2, U4.26
/RX6: J2.2, J17.1, J18.1, U4.51
/Relay-Out: J8.4, U4.31
/SCL: P2.4, U4.38
/SCL0: U1.3, U4.29
/SCL-ODroid: J7.5, U1.7
/SDA: P2.3, U4.39
/SDA0: U1.2, U4.30
/SDA-ODroid: J7.4, U1.6
/SW1/VIN/LEDAnode: J5.3, P3.2, REL1.4
/SW2/Batt: J5.1, P1.5
/TX1: J15.2, J16.2, U4.2
/TX2: J1.2, J6.2, U4.11
/TX3: J10.2, J12.2, U4.9
/TX4: J13.2, J14.2, U4.23
/TX5: J7.1, U4.25
/TX6: J2.1, J17.2, J18.2, U4.50
/VIn+5V: C2.1, C16.1, J8.3, P2.1, U1.4, U4.48
/Vout+10V: J9.2, P10.4
/Vout+14V: J9.1, P10.1, REL1.3
unnamed: D2.2, Q1.1, REL1.2
unnamed: J9.4, R5.1
unnamed: P6.1, SW2.1
unnamed: Q1.2, R5.2
unnamed: R1.2, R2.1, U4.44
unnamed: R3.2, R6.1, U4.45
