jochenalt/Pentapod-Design/schematics/SensorAdapter/SensorAdapter.kicad_pcb

## KiCad design schematics/SensorAdapter/SensorAdapter.kicad_pcb (2017-08-30)

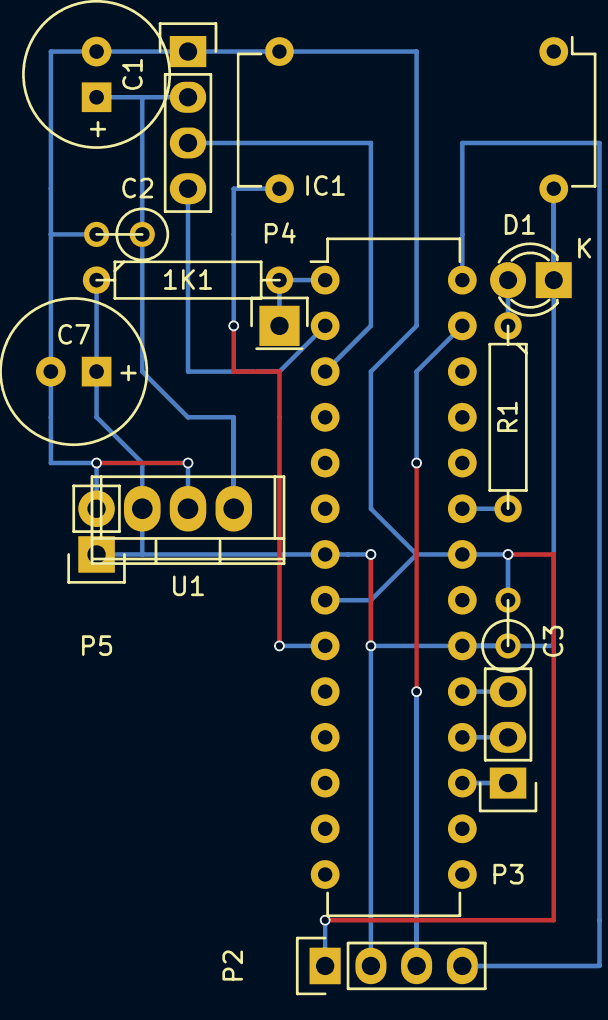
[picture p194: board SensorAdapter.kicad_pcb from above]

Board: 2 copper layers, 15 parts (0 on the bottom side), 14 nets.

Parts:
1K1: 1K; R4
C1, C7: 47uF; C1V8
C2, C3: 100nF; R1
D1: LED; LED-3MM
IC1: ATMEGA328-P; DIP-28_W7.62mm
P1: ServoIN; Pin_Header_Straight_1x04
P2: VL6180X; Pin_Header_Straight_1x04
P3: ISP; Pin_Header_Straight_1x03
P4: RST; Pin_Header_Straight_1x01
P5: VDD-GND; Pin_Header_Straight_1x02
R1: 1K; R4
U1: 7805; TO-220
X1: CRYSTAL_OSSCI; DIP-14_W7.62mm

Connections:
/+5V: 1K1.1, C3.1, C7.1, D1.1, IC1.7, IC1.20, P2.2, P5.1, U1.VO, X1.14
/MISO: IC1.18, P3.2
/MOSI: IC1.17, P3.1
/RX: IC1.2, P1.4
/SCK: IC1.19, P3.3
/SCL: IC1.28, P2.4
/SDA: IC1.27, P2.3
/TX: IC1.3, P1.3
/VDD: C1.1, C2.1, P1.2, U1.VI
GNDPWR: C1.2, C2.2, C3.2, C7.2, IC1.8, IC1.22, P1.1, P2.1, P5.2, U1.GND, X1.7
unnamed: 1K1.2, IC1.1, P4.1
unnamed: D1.2, R1.1
unnamed: IC1.9, X1.8
unnamed: IC1.23, R1.2
