jochenalt/Pentapod-Design/datasheets/ServoFrameWork/Servo.cpp

/*!
 * This file is part of SmartServoFramework.
 * Copyright (c) 2014, INRIA, All rights reserved.
 *
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
 * \file Servo.cpp
 * \date 25/08/2014
 * \author Emeric Grange <emeric.grange@gmail.com>
 */

#include "Dynamixel.h"
#include "DynamixelTools.h"
#include "ControlTablesDynamixel.h"

#include "Servo.h"
#include "minitraces.h"

#include <thread>

Servo::Servo()
{
    //
}

Servo::~Servo()
{
    if (registerTableValues != nullptr)
    {
        delete [] registerTableValues;
        registerTableValues = nullptr;
    }

    if (registerTableCommits != nullptr)
    {
        delete [] registerTableCommits;
        registerTableCommits = nullptr;
    }
}

/* ************************************************************************** */

const int (*(Servo::getControlTable()))[8]
{
    return ct;
}

int Servo::getRegisterCount()
{
    return registerTableSize;
}

int Servo::gid(const int reg)
{
    int id = getRegisterTableIndex(ct, reg);

    // Set fallback id to 0, so nobody try to access negative table index.
    if (id < 0)
    {
        id = 0;
    }

    return id;
}

int Servo::gaddr(const int reg, const int reg_mode)
{
    return getRegisterAddr(ct, reg, reg_mode);
}

/* ************************************************************************** */

int Servo::getStatus()
{
    std::lock_guard <std::mutex> lock(access);
    return statusDetail;
}

void Servo::setStatus(const int status)
{
    std::lock_guard <std::mutex> lock(access);
    statusDetail = status;
}

int Servo::getError()
{
    std::lock_guard <std::mutex> lock(access);
    return statusError;
}

void Servo::setError(const int error)
{
    if (error > 0)
    {
        std::lock_guard <std::mutex> lock(access);
        statusError += error;
        errorCount++;
    }
}

void Servo::clearErrors()
{
    std::lock_guard <std::mutex> lock(access);

    commError = 0;
    statusError = 0;
    statusDetail = 0;
    valueErrors = 0;
    errorCount = 0;
}

int Servo::getErrorCount()
{
    std::lock_guard <std::mutex> lock(access);

    errorCount--;
    return (errorCount + 1);
}

/* ************************************************************************** */

void Servo::action()
{
    std::lock_guard <std::mutex> lock(access);
    actionProgrammed = 1;
}

void Servo::reboot()
{
    std::lock_guard <std::mutex> lock(access);
    rebootProgrammed = 1;
}

void Servo::refresh()
{
    std::lock_guard <std::mutex> lock(access);
    refreshProgrammed = 1;
}

void Servo::reset(int setting)
{
    if (setting == RESET_ALL ||
        setting == RESET_ALL_EXCEPT_ID ||
        setting == RESET_ALL_EXCEPT_ID_BAUDRATE)
    {
        std::lock_guard <std::mutex> lock(access);
        resetProgrammed = setting;
    }
}

void Servo::getActions(int &action, int &reboot, int &refresh, int &reset)
{
    std::lock_guard <std::mutex> lock(access);

    action = actionProgrammed;
    reboot = rebootProgrammed;
    reset = resetProgrammed;
    refresh = refreshProgrammed;

    actionProgrammed = 0;
    rebootProgrammed = 0;
    resetProgrammed = 0;
    refreshProgrammed = 0;
}

int Servo::changeInternalId(int newId)
{
    int retcode = 0;

    if (newId > 0 && newId < 254)
    {
        std::lock_guard <std::mutex> lock(access);
        servoId = newId;
        retcode = 1;
    }

    return retcode;
}

/* ************************************************************************** */

void Servo::status()
{
    std::lock_guard <std::mutex> lock(access);

    TRACE_INFO(SERVO, "Basic status(#%i)", servoId);

    TRACE_INFO(SERVO, "> model      : %i", servoModel);
    TRACE_INFO(SERVO, "> firmware   : %i", registerTableValues[gid(REG_FIRMWARE_VERSION)]);
}

int Servo::getDeviceBrand()
{
    int brand = SERVO_UNKNOWN;

    if (servoModel)
    {
        if (servoModel > SERVO_HERKULEX)
        {
            brand = SERVO_HERKULEX;
        }
        else if (servoModel > SERVO_DYNAMIXEL)
        {
            brand = SERVO_DYNAMIXEL;
        }
    }

    return brand;
}

int Servo::getDeviceSerie()
{
    return servoSerie;
}

int Servo::getDeviceModel()
{
    return servoModel;
}

/* ************************************************************************** */

int Servo::getId()
{
    // This function return the ID currently in use for the servo, and so not
    // the one in registerTableValues[gid(REG_ID)], which could be set to a new
    // value not yet commited to the device.

    std::lock_guard <std::mutex> lock(access);
    return servoId;
}

int Servo::getModelNumber()
{
    std::lock_guard <std::mutex> lock(access);
    return registerTableValues[gid(REG_MODEL_NUMBER)];
}

int Servo::getFirmwareVersion()
{
    std::lock_guard <std::mutex> lock(access);
    return registerTableValues[gid(REG_FIRMWARE_VERSION)];
}

int Servo::getBaudNum()
{
    std::lock_guard <std::mutex> lock(access);
    return registerTableValues[gid(REG_BAUD_RATE)];
}

int Servo::getCwAngleLimit()
{
    std::lock_guard <std::mutex> lock(access);
    return registerTableValues[gid(REG_MIN_POSITION)];
}

int Servo::getCcwAngleLimit()
{
    std::lock_guard <std::mutex> lock(access);
    return registerTableValues[gid(REG_MAX_POSITION)];
}

int Servo::getSteps()
{
    std::lock_guard <std::mutex> lock(access);
    return steps;
}

int Servo::getRunningDegrees()
{
    std::lock_guard <std::mutex> lock(access);
    return runningDegrees;
}

int Servo::getMaxTorque()
{
    std::lock_guard <std::mutex> lock(access);
    return registerTableValues[gid(REG_MAX_TORQUE)];
}

int Servo::getStatusReturnLevel()
{
    std::lock_guard <std::mutex> lock(access);
    return registerTableValues[gid(REG_STATUS_RETURN_LEVEL)];
}

int Servo::getAlarmLed()
{
    std::lock_guard <std::mutex> lock(access);
    return registerTableValues[gid(REG_ALARM_LED)];
}

int Servo::getAlarmShutdown()
{
    std::lock_guard <std::mutex> lock(access);
    return registerTableValues[gid(REG_ALARM_SHUTDOWN)];
}

int Servo::getTorqueEnabled()
{
    std::lock_guard <std::mutex> lock(access);
    return registerTableValues[gid(REG_TORQUE_ENABLE)];
}

int Servo::getLed()
{
    std::lock_guard <std::mutex> lock(access);
    return registerTableValues[gid(REG_LED)];
}

int Servo::getCurrentPosition()
{
    std::lock_guard <std::mutex> lock(access);
    return registerTableValues[gid(REG_CURRENT_POSITION)];
}

int Servo::getCurrentSpeed()
{
    std::lock_guard <std::mutex> lock(access);
    return registerTableValues[gid(REG_CURRENT_SPEED)];
}

int Servo::getCurrentLoad()
{
    std::lock_guard <std::mutex> lock(access);
    return registerTableValues[gid(REG_CURRENT_LOAD)];
}

/* ************************************************************************** */

void Servo::setId(int id)
{
    TRACE_2(SERVO, "[#%i] setId(from %i to %i)", servoId, servoId, id);

    if (id > -1 && id < 254)
    {
        std::lock_guard <std::mutex> lock(access);

        // Maybe check if new ID is not already in use ?
        registerTableValues[gid(REG_ID)] = id;
        registerTableCommits[gid(REG_ID)] = 1;
    }
}

void Servo::setCWLimit(int limit)
{
    TRACE_2(SERVO, "[#%i] setCWLimit(%i)", servoId, limit);

    if (limit > -1 && limit < steps)
    {
        std::lock_guard <std::mutex> lock(access);

        registerTableValues[gid(REG_MIN_POSITION)] = limit;
        registerTableCommits[gid(REG_MIN_POSITION)] = 1;
    }
}

void Servo::setCCWLimit(int limit)
{
    TRACE_2(SERVO, "[#%i] setCCWLimit(%i)", servoId, limit);

    if (limit > -1 && limit < steps)
    {
        std::lock_guard <std::mutex> lock(access);

        registerTableValues[gid(REG_MAX_POSITION)] = limit;
        registerTableCommits[gid(REG_MAX_POSITION)] = 1;
    }
}

/* ************************************************************************** */

int Servo::getValue(int reg_name, int reg_type)
{
    int value = -1;

    // Find register's informations (addr, size...)
    RegisterInfos infos = {-1, -1, -1, -1, -1, -1, -1, -1, -1};
    if (getRegisterInfos(ct, reg_name, infos) == 1)
    {
        if (infos.reg_index >= 0)
        {
            std::lock_guard <std::mutex> lock(access);

            // Get value
            value = registerTableValues[infos.reg_index];
        }
        else
        {
            TRACE_ERROR(SERVO, "[#%i] getValue(reg %i / %s) [REGISTER ID ERROR]",
                        servoId, reg_name, getRegisterNameTxt(reg_name).c_str());
        }
    }
    else
    {
        TRACE_ERROR(SERVO, "[#%i] getValue(reg %i / %s) [REGISTER NAME ERROR]",
                    servoId, reg_name, getRegisterNameTxt(reg_name).c_str());
    }

    return value;
}

int Servo::getValueCommit(int reg_name, int reg_type)
{
    int commit = -1;

    // Find register's informations (addr, size...)
    RegisterInfos infos = {-1, -1, -1, -1, -1, -1, -1, -1, -1};
    if (getRegisterInfos(ct, reg_name, infos) == 1)
    {
        if (infos.reg_index >= 0)
        {
            std::lock_guard <std::mutex> lock(access);

            // Get value
            commit = registerTableCommits[infos.reg_index];
        }
        else
        {
            TRACE_ERROR(SERVO, "[#%i] getValueCommit(reg %i / %s) [REGISTER ID ERROR]",
                        servoId, reg_name, getRegisterNameTxt(reg_name).c_str());
        }
    }
    else
    {
        TRACE_ERROR(SERVO, "[#%i] getValueCommit(reg %i / %s) [REGISTER NAME ERROR]",
                    servoId, reg_name, getRegisterNameTxt(reg_name).c_str());
    }

    return commit;
}

/* ************************************************************************** */

void Servo::setValue(int reg_name, int reg_value, int reg_type)
{
    // Find register's informations (addr, size...)
    RegisterInfos infos = {-1, -1, -1, -1, -1, -1, -1, -1, -1};
    if (getRegisterInfos(ct, reg_name, infos) == 1)
    {
        if (infos.reg_index >= 0)
        {
            // Check if we have permission to write into this register
            if (infos.reg_access_mode == READ_WRITE)
            {
                // Check value
                if (reg_value >= infos.reg_value_min && reg_value <= infos.reg_value_max)
                {
                    std::lock_guard <std::mutex> lock(access);

                    // Set value
                    registerTableValues[infos.reg_index] = reg_value;
                    registerTableCommits[infos.reg_index] = 1;
                }
                else
                {
                    TRACE_ERROR(SERVO, "[#%i] setValue(reg %i / %s to %i) [REGISTER VALUE ERROR] (min: %i / max: %i)",
                                servoId, reg_name, getRegisterNameTxt(reg_name).c_str(),
                                reg_value, infos.reg_value_min, infos.reg_value_max);
                }
            }
            else
            {
                TRACE_ERROR(SERVO, "[#%i] setValue(reg %i / %s) [REGISTER ACCESS ERROR]",
                            servoId, reg_name, getRegisterNameTxt(reg_name).c_str());
            }
        }
        else
        {
            TRACE_ERROR(SERVO, "[#%i] setValue(reg %i / %s) [REGISTER ID ERROR]",
                        servoId, reg_name, getRegisterNameTxt(reg_name).c_str());
        }
    }
    else
    {
        TRACE_ERROR(SERVO, "[#%i] setValue(reg %i / %s) [REGISTER NAME ERROR]",
                    servoId, reg_name, getRegisterNameTxt(reg_name).c_str());
    }
}

void Servo::updateValue(int reg_name, int reg_value, int reg_type)
{
    // Find register's informations (addr, size...)
    RegisterInfos infos = {-1, -1, -1, -1, -1, -1, -1, -1, -1};
    if (getRegisterInfos(ct, reg_name, infos) == 1)
    {
        if (infos.reg_index >= 0)
        {
            // Check value
            if (reg_value >= infos.reg_value_min && reg_value <= infos.reg_value_max)
            {
                std::lock_guard <std::mutex> lock(access);

                // Update value
                registerTableValues[infos.reg_index] = reg_value;
            }
            else
            {
                valueErrors++;
                errorCount++;

                // If the value is out of bound but correspond to an error code [-1;-7], no need to print it as a 'REGISTER VALUE ERROR'
                if ( !(reg_value < 0 && reg_value > -8) )
                {
                    TRACE_ERROR(SERVO, "[#%i] updateValue(reg %i / %s to %i) [REGISTER VALUE ERROR] (min: %i / max: %i)",
                                servoId, reg_name, getRegisterNameTxt(reg_name).c_str(), reg_value, infos.reg_value_min, infos.reg_value_max);
                }
            }
        }
        else
        {
            TRACE_ERROR(SERVO, "[#%i] updateValue(reg %i / %s) [REGISTER ID ERROR]",
                        servoId, reg_name, getRegisterNameTxt(reg_name).c_str());
        }
    }
    else
    {
        TRACE_ERROR(SERVO, "[#%i] updateValue(reg %i / %s) [REGISTER NAME ERROR]",
                    servoId, reg_name, getRegisterNameTxt(reg_name).c_str());
    }
}

void Servo::commitValue(int reg_name, int commit, int reg_type)
{
    // Find register's informations (addr, size...)
    RegisterInfos infos = {-1, -1, -1, -1, -1, -1, -1, -1, -1};
    if (getRegisterInfos(ct, reg_name, infos) == 1)
    {
        if (infos.reg_index >= 0)
        {
            // Check if we have permission to write into this register
            if (infos.reg_access_mode == READ_WRITE)
            {
                if (commit != 0)
                {
                    commit = 1;
                }

                std::lock_guard <std::mutex> lock(access);

                // Set value
                registerTableCommits[infos.reg_index] = commit;
            }
            else
            {
                TRACE_ERROR(SERVO, "[#%i] commitValue(reg %i / %s) [REGISTER ACCESS ERROR]",
                            servoId, reg_name, getRegisterNameTxt(reg_name).c_str());
            }
        }
        else
        {
            TRACE_ERROR(SERVO, "[#%i] commitValue(reg %i / %s) [REGISTER ID ERROR]",
                        servoId, reg_name, getRegisterNameTxt(reg_name).c_str());
        }
    }
    else
    {
        TRACE_ERROR(SERVO, "[#%i] commitValue(reg %i / %s) [REGISTER NAME ERROR]",
                    servoId, reg_name, getRegisterNameTxt(reg_name).c_str());
    }
}

/* ************************************************************************** */
