jochenalt/Pentapod-Design/datasheets/ServoFrameWork/HerkuleXSimpleAPI.cpp

/*!
 * This file is part of SmartServoFramework.
 * Copyright (c) 2014, INRIA, All rights reserved.
 *
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
 * \file HerkuleXSimpleAPI.cpp
 * \date 19/08/2014
 * \author Emeric Grange <emeric.grange@gmail.com>
 */

#include "HerkuleXSimpleAPI.h"
#include "ControlTables.h"
#include "ControlTablesDynamixel.h"
#include "ControlTablesHerkuleX.h"
#include "minitraces.h"

// C++ standard libraries
#include <cstring>
#include <map>

HerkuleXSimpleAPI::HerkuleXSimpleAPI(int servoSerie)
{
    if (servoSerie != SERVO_UNKNOWN)
    {
        if (servoSerie >= SERVO_HERKULEX)
        {
            ackPolicy = 1;
            maxId = 253;

            protocolVersion = PROTOCOL_HKX;
            servoSerie = SERVO_DRS;

            if (servoSerie == SERVO_DRS_0402 || servoSerie == SERVO_DRS_0602)
            {
                ct = DRS0x02_control_table;
            }
            else if (servoSerie == SERVO_DRS_0401 || servoSerie == SERVO_DRS_0601)
            {
                ct = DRS0x01_control_table;
            }
            else
            {
                ct = DRS0101_control_table;
            }

            TRACE_INFO(DAPI, "- Using HerkuleX communication protocol");
        }
        else //if (servos >= SERVO_DYNAMIXEL)
        {
            ackPolicy = 2;
            maxId = 252;

            if (servoSerie >= SERVO_PRO)
            {
                protocolVersion = PROTOCOL_DXLv2;
                servoSerie = SERVO_PRO;
                ct = PRO_control_table;
            }
            else if (servoSerie >= SERVO_X)
            {
                protocolVersion = PROTOCOL_DXLv2;
                servoSerie = SERVO_X;
                ct = XMXH_control_table;
            }
            else if (servoSerie >= SERVO_XL)
            {
                protocolVersion = PROTOCOL_DXLv2;
                servoSerie = SERVO_XL;
                ct = XL320_control_table;
            }
            else // SERVO AX to MX
            {
                // We set the servo serie to 'MX' which is the more capable of the Dynamixel v1 serie
                protocolVersion = PROTOCOL_DXLv1;
                servoSerie = SERVO_MX;
                ct = MX_control_table;

                if (serialDevice == SERIAL_USB2AX)
                {
                    // The USB2AX device uses the ID 253 for itself
                    maxId = 252;
                }
                else
                {
                    maxId = 253;
                }
            }

            if (protocolVersion == PROTOCOL_DXLv2)
            {
                TRACE_INFO(DAPI, "- Using Dynamixel communication protocol version 2");
            }
            else
            {
                TRACE_INFO(DAPI, "- Using Dynamixel communication protocol version 1");
            }
        }
    }
    else
    {
        TRACE_WARNING(DAPI, "Warning: Unknown servo serie!");
    }
}

HerkuleXSimpleAPI::~HerkuleXSimpleAPI()
{
    disconnect();
}

int HerkuleXSimpleAPI::connect(std::string &devicePath, const int baud, const int serialDevice)
{
    this->serialDevice = serialDevice;
    return serialInitialize(devicePath, baud);
}

void HerkuleXSimpleAPI::disconnect()
{
    serialTerminate();
}

bool HerkuleXSimpleAPI::checkId(const int id, const bool broadcast)
{
    bool status = false;

    if ((id >= 0 && id <= maxId) ||
        (id == BROADCAST_ID && broadcast == true))
    {
        status = true;
    }
    else
    {
        if (id == BROADCAST_ID && broadcast == false)
        {
            TRACE_ERROR(DAPI, "Error: Broadcast ID is disabled for the current instruction.");
        }
        else
        {
            TRACE_ERROR(DAPI, "Error: ID '%i' is out of [0;%i] boundaries.", id, maxId);
        }
    }

    return status;
}

std::vector <int> HerkuleXSimpleAPI::servoScan(int start, int stop)
{
    // Check start/stop boundaries
    if (start < 0 || start > (maxId - 1))
        start = 0;

    if (stop < 1 || stop > maxId || stop < start)
        stop = maxId;


    TRACE_INFO(DAPI, "> Scanning for HerkuleX devices on '%s'... Range is [%i,%i]",
               serialGetCurrentDevice().c_str(), start, stop);

    // A vector of HerkuleX IDs found during the scan
    std::vector <int> ids;

    for (int id = start; id <= stop; id++)
    {
        PingResponse pingstats;

        // If the ping gets a response, then we have found a servo
        if (hkx_ping(id, &pingstats) == true)
        {
            setLed(id, 1, LED_GREEN);

            ids.push_back(id);

            TRACE_INFO(DAPI, "[#%i] HerkuleX servo found!", id);
            TRACE_INFO(DAPI, "[#%i] model: %i (%s)", id, pingstats.model_number, hkx_get_model_name(pingstats.model_number).c_str());

            // Other informations, not printed by default:
            TRACE_1(DAPI, "[#%i] firmware: %i", id, pingstats.firmware_version);
            TRACE_1(DAPI, "[#%i] position: %i", id, readCurrentPosition(id));
            TRACE_1(DAPI, "[#%i] speed: %i", id, readCurrentSpeed(id));
            TRACE_1(DAPI, "[#%i] torque: %i", id, getTorqueEnabled(id));
            TRACE_1(DAPI, "[#%i] load: %i", id, readCurrentLoad(id));
            TRACE_1(DAPI, "[#%i] baudrate: %i", id, getSetting(id, REG_BAUD_RATE));

            setLed(id, 0);
        }
        else
        {
            printf(".");
        }
    }

    printf("\n");
    return ids;
}

bool HerkuleXSimpleAPI::ping(const int id, PingResponse *status)
{
    return hkx_ping(id, status);
}

void HerkuleXSimpleAPI::reboot(const int id)
{
    if (checkId(id) == true)
    {
        hkx_reboot(id);
    }
}

void HerkuleXSimpleAPI::reset(const int id, const int setting)
{
    if (checkId(id) == true)
    {
        hkx_reset(id, setting);
    }
}

int HerkuleXSimpleAPI::readModelNumber(const int id)
{
    int value = -1;

    if (checkId(id, false) == true)
    {
        int addr = getRegisterAddr(ct, REG_MODEL_NUMBER);

        value = hkx_read_word(id, addr, REGISTER_ROM);
        if (hkx_print_error() != 0)
        {
            value = -1;
        }
    }

    return value;
}

int HerkuleXSimpleAPI::readFirmwareVersion(const int id)
{
    int value = -1;

    if (checkId(id, false) == true)
    {
        int addr = getRegisterAddr(ct, REG_FIRMWARE_VERSION);

        value = hkx_read_word(id, addr, REGISTER_ROM);
        if (hkx_print_error() != 0)
        {
            value = -1;
        }
    }

    return value;
}

int HerkuleXSimpleAPI::changeId(const int id, const int new_id)
{
    int status = 0;

    // Check 'old' ID
    if (checkId(id, false) == true)
    {
        // Check 'new' ID // Valid IDs are in range [0:maxId]
        if ((new_id >= 0) && (new_id <= maxId))
        {
            // If the ping get a response, then we already have a servo on the new id
            hkx_ping(new_id);

            if (hkx_get_com_status() == COMM_RXSUCCESS)
            {
                TRACE_ERROR(DAPI, "[#%i] Cannot set new ID '%i' for this servo: already in use", id, new_id);
            }
            else
            {
                int addr_rom = getRegisterAddr(ct, REG_ID, REGISTER_ROM);
                hkx_write_byte(id, addr_rom, new_id, REGISTER_ROM);
                if (hkx_print_error() == 0)
                {
                    status = 1;
                }

                int addr_ram = getRegisterAddr(ct, REG_ID, REGISTER_RAM);
                hkx_write_byte(id, addr_ram, new_id, REGISTER_RAM);
                if (hkx_print_error() == 0)
                {
                    status = 1;
                }
            }
        }
        else
        {
            TRACE_ERROR(DAPI, "[#%i] Cannot set new ID '%i' for this servo: out of range", id, new_id);
        }
    }

    return status;
}

int HerkuleXSimpleAPI::changeBaudRate(const int id, const int baudnum)
{
    int status = 0;

    if (checkId(id) == true)
    {
        // Valid baudnums are in range [0:34]
        if ((baudnum >= 0) && (baudnum <= 34))
        {
            int addr_rom = getRegisterAddr(ct, REG_BAUD_RATE, REGISTER_ROM);
            hkx_write_byte(id, addr_rom, baudnum, REGISTER_ROM);
            if (hkx_print_error() == 0)
            {
                status = 1;
            }

            int addr_ram = getRegisterAddr(ct, REG_BAUD_RATE, REGISTER_RAM);
            hkx_write_byte(id, addr_ram, baudnum, REGISTER_RAM);
            if (hkx_print_error() == 0)
            {
                status = 1;
            }
        }
        else
        {
            TRACE_ERROR(DAPI, "[#%i] Cannot set new baudnum '%i' for this servo: out of range", id, baudnum);
        }
    }

    return status;
}

void HerkuleXSimpleAPI::getMinMaxPositions(const int id, int &min, int &max)
{
    if (checkId(id, false) == true)
    {
        int addr_min_ram = getRegisterAddr(ct, REG_MIN_POSITION, REGISTER_RAM);
        int addr_max_ram = getRegisterAddr(ct, REG_MAX_POSITION, REGISTER_RAM);

        min = hkx_read_word(id, addr_min_ram, REGISTER_RAM);
        if (hkx_print_error() == 0)
        {
            // Valid positions are in range [0:1023] for most servo series, and [0:4095] for high-end servo series
            if ((min < 0) || (min > 4095))
            {
                min = -1;
            }
        }
        else
        {
            min = -1;
        }

        max = hkx_read_word(id, addr_max_ram, REGISTER_RAM);
        if (hkx_print_error() == 0)
        {
            // Valid positions are in range [0:1023] for most servo series, and [0:4095] for high-end servo series
            if ((max < 0) || (max > 4095))
            {
                max = -1;
            }
        }
        else
        {
            max = -1;
        }
    }
}

int HerkuleXSimpleAPI::setMinMaxPositions(const int id, const int min, const int max)
{
    int status = 0;

    if (checkId(id) == true)
    {
        // Valid positions are in range [0:1023] for most servo series, and [0:4095] for high-end servo series
        if ((min < 0) || (min > 4095) || (max < 0) || (max > 4095))
        {
            TRACE_ERROR(DAPI, "[#%i] Cannot set new min/max positions '%i/%i' for this servo: out of range", id, min, max);
        }
        else
        {
            // ROM
            {
                int addr_min_rom = getRegisterAddr(ct, REG_MIN_POSITION, REGISTER_ROM);
                int addr_max_rom = getRegisterAddr(ct, REG_MAX_POSITION, REGISTER_ROM);

                // Write min value
                hkx_write_word(id, addr_min_rom, min, REGISTER_ROM);
                if (hkx_print_error() == 0)
                {
                    status = 1;
                }

                // Write max value
                hkx_write_word(id, addr_max_rom, max, REGISTER_ROM);
                if (hkx_print_error() == 0)
                {
                    status = 1;
                }
            }

            // RAM
            {
                int addr_min_ram = getRegisterAddr(ct, REG_MIN_POSITION, REGISTER_RAM);
                int addr_max_ram = getRegisterAddr(ct, REG_MAX_POSITION, REGISTER_RAM);

                // Write min value
                hkx_write_word(id, addr_min_ram, min, REGISTER_RAM);
                if (hkx_print_error() == 0)
                {
                    status = 1;
                }

                // Write max value
                hkx_write_word(id, addr_max_ram, max, REGISTER_RAM);
                if (hkx_print_error() == 0)
                {
                    status = 1;
                }
            }
        }
    }

    return status;
}

int HerkuleXSimpleAPI::getTorqueEnabled(const int id)
{
    int value = -1;

    if (checkId(id, false) == true)
    {
        int addr_ram = getRegisterAddr(ct, REG_TORQUE_ENABLE, REGISTER_RAM);
        value = hkx_read_byte(id, addr_ram, REGISTER_RAM);

        if (hkx_print_error() != 0)
        {
            value = -1;
        }
    }

    return value;
}

int HerkuleXSimpleAPI::setTorqueEnabled(const int id, int torque)
{
    int status = 0;

    if (checkId(id) == true)
    {
        // Normalize value, 1 means 'torque on' for Dynamixel devices
        if (torque == 1)
        {
            torque = 0x60;
        }

        // Valid torque are in range [0:254]
        if (torque == 0x00 || torque == 0x40 || torque == 0x60)
        {
            int addr_ram = getRegisterAddr(ct, REG_TORQUE_ENABLE, REGISTER_RAM);
            hkx_write_byte(id, addr_ram, torque, REGISTER_RAM);
            if (hkx_print_error() == 0)
            {
                status = 1;
            }
        }
        else
        {
            TRACE_ERROR(DAPI, "[#%i] Cannot set torque_enabled '%i' for this servo: out of range", id, torque);
        }
    }

    return status;
}

int HerkuleXSimpleAPI::getLed(const int id)
{
    int value = -1;

    if (checkId(id, false) == true)
    {
        int addr = getRegisterAddr(ct, REG_LED, REGISTER_RAM);
        value = hkx_read_byte(id, addr, REGISTER_RAM);

        if (hkx_print_error() != 0)
        {
            value = -1;
        }
    }

    return value;
}

int HerkuleXSimpleAPI::setLed(const int id, int led, const int color)
{
    int status = 0;

    if (checkId(id) == true)
    {
        // Normalize value
        if (led >= 1)
        {
            led = 0;

            if (color & LED_GREEN)
            { led += 0x01; }
            if (color & LED_BLUE)
            { led += 0x02; }
            if (color & LED_RED)
            { led += 0x04; }
        }
        else
        {
            led = 0;
        }

        // Execute command
        int addr = getRegisterAddr(ct, REG_LED, REGISTER_RAM);
        if (addr >= 0)
        {
            hkx_write_byte(id, addr, led, REGISTER_RAM);

            // Check for error
            if (hkx_print_error() == 0)
            {
                status = 1;
            }
        }
    }

    return status;
}

int HerkuleXSimpleAPI::turn(const int id, const int velocity)
{
    int status = 0;

    if (checkId(id) == true)
    {
        hkx_i_jog(id, 1, velocity);
        if (hkx_print_error() == 0)
        {
            status = 1;
        }
    }

    return status;
}

int HerkuleXSimpleAPI::getGoalPosition(const int id)
{
    int value = -1;

    if (checkId(id) == true)
    {
        int addr = getRegisterAddr(ct, REG_GOAL_POSITION, REGISTER_RAM);

        value = hkx_read_byte(id, addr, REGISTER_RAM);
        if (hkx_print_error() != 0)
        {
            value = -1;
        }
    }

    return value;
}

int HerkuleXSimpleAPI::setGoalPosition(const int id, const int position)
{
    int status = 0;

    if (checkId(id) == true)
    {
        // Valid positions are in range [0:1023] for most servo series, and [0:4095] for high-end servo series
        if ((position >= 0) && (position <= 4095))
        {
            hkx_i_jog(id, 0, position);
            if (hkx_print_error() == 0)
            {
                status = 1;
            }
        }
        else
        {
            TRACE_ERROR(DAPI, "[#%i] Cannot set goal position '%i' for this servo: out of range", id, position);
        }
    }

    return status;
}

int HerkuleXSimpleAPI::setGoalPosition(const int id, const int position, const int speed)
{
    int status = 0;

    //TODO Set goal speed, and if success proceed to set goal position

    if (checkId(id) == true)
    {
        // Valid positions are in range [0:1023] for most servo series, and [0:4095] for high-end servo series
        if ((position >= 0) && (position <= 4095))
        {
            hkx_i_jog(id, 0, position);
            if (hkx_print_error() == 0)
            {
                status = 1;
            }
        }
        else
        {
            TRACE_ERROR(DAPI, "[#%i] Cannot set goal position '%i' for this servo: out of range", id, position);
        }
    }

    return status;
}

int HerkuleXSimpleAPI::readCurrentPosition(const int id)
{
    int value = -1;

    if (checkId(id, false) == true)
    {
        int addr = getRegisterAddr(ct, REG_CURRENT_TEMPERATURE, REGISTER_RAM);

        value = hkx_read_byte(id, addr, REGISTER_RAM);
        if (hkx_print_error() != 0)
        {
            value = -1;
        }
    }

    return value;
}

int HerkuleXSimpleAPI::readCurrentSpeed(const int id)
{
    int value = -1;

    if (checkId(id, false) == true)
    {
        //
    }

    return value;
}

int HerkuleXSimpleAPI::readCurrentLoad(const int id)
{
    int value = -1;

    if (checkId(id, false) == true)
    {
        //
    }

    return value;
}

double HerkuleXSimpleAPI::readCurrentTemperature(const int id)
{
    double value = 0.0;

    if (checkId(id, false) == true)
    {
        int addr = getRegisterAddr(ct, REG_CURRENT_TEMPERATURE, REGISTER_RAM);

        value = static_cast<double>(hkx_read_byte(id, addr, REGISTER_RAM));
        if (hkx_print_error() == 0)
        {
            // FIXME temperature is using a non linear scale
            value *= 0.326;
        }
        else
        {
            value = 0.0;
        }
    }

    return value;
}

double HerkuleXSimpleAPI::readCurrentVoltage(const int id)
{
    double value = 0.0;

    if (checkId(id, false) == true)
    {
        int addr = getRegisterAddr(ct, REG_CURRENT_VOLTAGE, REGISTER_RAM);

        value = static_cast<double>(hkx_read_byte(id, addr, REGISTER_RAM));
        if (hkx_print_error() == 0)
        {
            value *= 0.074074;
        }
        else
        {
            value = 0.0;
        }
    }

    return value;
}

int HerkuleXSimpleAPI::getSetting(const int id, const int reg_name, int reg_type, const int device)
{
    int value = -1;

    if (checkId(id, false) == true)
    {
        // Device detection
        const int (*cctt)[8] = getRegisterTable(device);

        if (cctt == nullptr)
        {
            // Using default control table from this SimpleAPI isntance
            cctt = ct;
        }

        if (cctt)
        {
            // Find register's informations (addr, size...)
            RegisterInfos infos = {-1, -1, -1, -1, -1, -1, -1, -1, -1};
            if (getRegisterInfos(cctt, reg_name, infos) == 1)
            {
                // Register type
                if (reg_type == REGISTER_AUTO)
                {
                    if (infos.reg_addr_rom >= 0 && infos.reg_addr_ram >= 0)
                        reg_type = REGISTER_RAM; // Cannot return both values, so default is set to RAM
                    else if (infos.reg_addr_rom >= 0)
                        reg_type = REGISTER_ROM;
                    else if (infos.reg_addr_ram >= 0)
                        reg_type = REGISTER_RAM;
                }

                // Read value
                if (reg_type == REGISTER_ROM)
                {
                    if (infos.reg_size == 1)
                    {
                        value = hkx_read_byte(id, infos.reg_addr_rom, REGISTER_ROM);
                    }
                    else if (infos.reg_size == 2)
                    {
                        value = hkx_read_word(id, infos.reg_addr_rom, REGISTER_ROM);
                    }
                }
                else if (reg_type == REGISTER_RAM)
                {
                    if (infos.reg_size == 1)
                    {
                        value = hkx_read_byte(id, infos.reg_addr_ram, REGISTER_RAM);
                    }
                    else if (infos.reg_size == 2)
                    {
                        value = hkx_read_word(id, infos.reg_addr_ram, REGISTER_RAM);
                    }
                }

                // Check status
                if (hkx_print_error() == 0)
                {
                    // Check value
                    if (value < infos.reg_value_min && value > infos.reg_value_max)
                    {
                        value = -1;
                    }
                }
                else
                {
                    value = -1;
                }
            }
            else
            {
                TRACE_ERROR(DAPI, "[#%i] getSetting(reg %i / %s) [REGISTER NAME ERROR]", id, reg_name, getRegisterNameTxt(reg_name).c_str());
            }
        }
        else
        {
            TRACE_ERROR(DAPI, "[#%i] getSetting(reg %i / %s) [CONTROL TABLE ERROR]", id, reg_name, getRegisterNameTxt(reg_name).c_str());
        }
    }
    else
    {
        TRACE_ERROR(DAPI, "[#%i] getSetting(reg %i / %s) [DEVICE ID ERROR]", id, reg_name, getRegisterNameTxt(reg_name).c_str());
    }

    return value;
}

int HerkuleXSimpleAPI::setSetting(const int id, const int reg_name, const int reg_value, int reg_type, const int device)
{
    int status = 0;

    if (checkId(id) == true)
    {
        // Device detection
        const int (*cctt)[8] = getRegisterTable(device);

        if (cctt == nullptr)
        {
            // Using default control table from this SimpleAPI isntance
            cctt = ct;
        }

        if (cctt)
        {
            // Find register's informations (addr, size...)
            RegisterInfos infos = {-1, -1, -1, -1, -1, -1, -1, -1, -1};
            if (getRegisterInfos(cctt, reg_name, infos) == 1)
            {
                // Check if we have permission to write into this register
                if (infos.reg_access_mode == READ_WRITE)
                {
                    // Check value
                    if (reg_value >= infos.reg_value_min && reg_value <= infos.reg_value_max)
                    {
                        // Register type
                        if (reg_type == REGISTER_AUTO)
                        {
                            if (infos.reg_addr_rom >= 0 && infos.reg_addr_ram >= 0)
                                reg_type = REGISTER_BOTH;
                            else if (infos.reg_addr_rom >= 0)
                                reg_type = REGISTER_ROM;
                            else if (infos.reg_addr_ram >= 0)
                                reg_type = REGISTER_RAM;
                        }

                        // Set value(s)
                        if (reg_type == REGISTER_ROM || reg_type == REGISTER_BOTH)
                        {
                            // Write value
                            if (infos.reg_size == 1)
                            {
                                hkx_write_byte(id, infos.reg_addr_rom, reg_value, REGISTER_ROM);
                            }
                            else if (infos.reg_size == 2)
                            {
                                hkx_write_word(id, infos.reg_addr_rom, reg_value, REGISTER_ROM);
                            }

                            // Check for error
                            if (hkx_print_error() == 0)
                            {
                                status = 1;
                            }
                        }

                        if (reg_type == REGISTER_RAM || reg_type == REGISTER_BOTH)
                        {
                            // Write value
                            if (infos.reg_size == 1)
                            {
                                hkx_write_byte(id, infos.reg_addr_ram, reg_value, REGISTER_RAM);
                            }
                            else if (infos.reg_size == 2)
                            {
                                hkx_write_word(id, infos.reg_addr_ram, reg_value, REGISTER_RAM);
                            }

                            // Check for error
                            if (hkx_print_error() == 0)
                            {
                                status = 1;
                            }
                        }
                    }
                    else
                    {
                        TRACE_ERROR(DAPI, "[#%i] setSetting(reg %i / %s) [VALUE ERROR] (min: %i / max: %i)",
                                    id, reg_name, getRegisterNameTxt(reg_name).c_str(), infos.reg_value_min, infos.reg_value_max);
                    }
                }
                else
                {
                    TRACE_ERROR(DAPI, "[#%i] setSetting(reg %i / %s) [REGISTER ACCESS ERROR]", id, reg_name, getRegisterNameTxt(reg_name).c_str());
                }
            }
            else
            {
                TRACE_ERROR(DAPI, "[#%i] setSetting(reg %i / %s) [REGISTER NAME ERROR]", id, reg_name, getRegisterNameTxt(reg_name).c_str());
            }
        }
        else
        {
            TRACE_ERROR(DAPI, "[#%i] setSetting(reg %i / %s) [CONTROL TABLE ERROR]", id, reg_name, getRegisterNameTxt(reg_name).c_str());
        }
    }
    else
    {
        TRACE_ERROR(DAPI, "[#%i] setSetting(reg %i / %s) [DEVICE ID ERROR]", id, reg_name, getRegisterNameTxt(reg_name).c_str());
    }

    return status;
}
