jochenalt/Pentapod-Design/datasheets/ServoFrameWork/HerkuleX.cpp

/*!
 * This file is part of SmartServoFramework.
 * Copyright (c) 2014, INRIA, All rights reserved.
 *
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
 * \file HerkuleX.cpp
 * \date 07/07/2014
 * \author Emeric Grange <emeric.grange@gmail.com>
 */

#include "HerkuleX.h"
#include "minitraces.h"

// C++ standard libraries
#include <cstdio>
#include <cstdlib>
#include <cstring>
#include <map>
#include <mutex>
#include <iostream>

/* ************************************************************************** */

// Enable latency timer
//#define LATENCY_TIMER

// Enable packet debugger
//#define PACKET_DEBUGGER

/* ************************************************************************** */

/*!
 * \brief The different instructions available with the HerkuleX protocol.
 */
enum HerkuleXProtocol {
    CMD_EEP_WRITE  = 1,
    CMD_EEP_READ   = 2,
    CMD_RAM_WRITE  = 3,
    CMD_RAM_READ   = 4,
    CMD_I_JOG      = 5,
    CMD_S_JOG      = 6,
    CMD_STAT       = 7,
    CMD_ROLLBACK   = 8,
    CMD_REBOOT     = 9,

    ACK_EEP_WRITE  = 0x41,
    ACK_EEP_READ   = 0x42,
    ACK_RAM_WRITE  = 0x43,
    ACK_RAM_READ   = 0x44,
    ACK_I_JOG      = 0x45,
    ACK_S_JOG      = 0x46,
    ACK_STAT       = 0x47,
    ACK_ROLLBACK   = 0x48,
    ACK_REBOOT     = 0x49,
};

/*!
 * \brief Addresses of the various fields forming a packet.
 */
enum {
    PKT_HEADER0     = 0,            //!< "0xFF". The 2 bytes header indicate the beginning of a packet.
    PKT_HEADER1     = 1,            //!< "0xFF"
    PKT_LENGTH      = 2,
    PKT_ID          = 3,            //!< ID of HerkuleX device which will receive the Instruction Packet. Range is [0;254].
    PKT_CMD         = 4,
    PKT_CHECKSUM1   = 5,            //!< Instruction Packet's error. Only used with status packet.
    PKT_CHECKSUM2   = 6,            //!< Note: parameter field as an address of 9 (and not 8) when found in status packet.
    PKT_DATA        = 7,            //!< Note: parameter field as an address of 9 (and not 8) when found in status packet.
};

/* ************************************************************************** */

HerkuleX::HerkuleX()
{
    //
}

HerkuleX::~HerkuleX()
{
    serialTerminate();
}

int HerkuleX::serialInitialize(std::string &devicePath, const int baud)
{
    int status = 0;

    if (serial != nullptr)
    {
        serialTerminate();
    }

    // Instanciate a different serial subclass, depending on the current OS
#if defined(FEATURE_QTSERIAL)
    serial = new SerialPortQt(devicePath, baud, serialDevice, servoSerie);
#else
#if defined(__linux__) || defined(__gnu_linux)
    serial = new SerialPortLinux(devicePath, baud, serialDevice, servoSerie);
#elif defined(_WIN32) || defined(_WIN64)
    serial = new SerialPortWindows(devicePath, baud, serialDevice, servoSerie);
#elif defined(__APPLE__) || defined(__MACH__)
    serial = new SerialPortMacOS(devicePath, baud, serialDevice, servoSerie);
#else
    #error "No compatible operating system detected!"
#endif
#endif

    // Initialize the serial link
    if (serial != nullptr)
    {
        status = serial->openLink();

        if (status > 0)
        {
            TRACE_INFO(DXL, "> Serial interface successfully opened on '%s' @ %i bps", devicePath.c_str(), baud);
        }
    }
    else
    {
        TRACE_ERROR(HKX, "> Failed to open serial interface on '%s' @ %i bps. Exiting...", devicePath.c_str(), baud);
    }

    return status;
}

void HerkuleX::serialTerminate()
{
    if (serial != nullptr)
    {
        // Close serial link
        serial->closeLink();
        delete serial;
        serial = nullptr;

        // Clear incoming packet?
        rxPacketSize = 0;
        memset(rxPacket, 0, sizeof(rxPacket));
    }
}

std::string HerkuleX::serialGetCurrentDevice()
{
    std::string serialName;

    if (serial != nullptr)
    {
        serialName = serial->getDevicePath();
    }
    else
    {
        serialName = "unknown";
    }

    return serialName;
}

std::vector <std::string> HerkuleX::serialGetAvailableDevices()
{
    std::vector <std::string> devices;

    if (serial == nullptr)
    {
        TRACE_ERROR(HKX, "Serial interface is not initialized!");
    }
    else
    {
        devices = serial->scanSerialPorts();
    }

    return devices;
}

void HerkuleX::serialSetLatency(int latency)
{
    serial->setLatency(latency);
}

void HerkuleX::setAckPolicy(int ack)
{
    if (ackPolicy >= ACK_NO_REPLY && ack <= ACK_REPLY_ALL)
    {
        ackPolicy = ack;
    }
    else
    {
        TRACE_ERROR(HKX, "Invalid ack policy: '%i', not in [0;2] range.", ack);
    }
}

void HerkuleX::hkx_tx_packet()
{
    if (serial == nullptr)
    {
        TRACE_ERROR(HKX, "Serial interface is not initialized!");
        return;
    }

    if (commLock == 1)
    {
        return;
    }
    commLock = 1;

    // Make sure serial link is "clean"
    if (commStatus == COMM_RXTIMEOUT || commStatus == COMM_RXCORRUPT)
    {
        serial->flush();
    }

    // Make sure the packet is properly formed
    if (hkx_validate_packet() == 0)
    {
        return;
    }

    int txPacketSize = hkx_get_txpacket_size();
    unsigned char txPacketSizeSent = 0;

    // Generate a checksum and write it into the last two bytes of the packet
    unsigned short crc = hkx_checksum_packet(txPacket, txPacketSize);
    txPacket[PKT_CHECKSUM1] = get_lowbyte(crc);
    txPacket[PKT_CHECKSUM2] = get_highbyte(crc);

    // Send packet
    if (serial != nullptr)
    {
        txPacketSizeSent = serial->tx(txPacket, txPacketSize);
    }
    else
    {
        TRACE_ERROR(HKX, "Serial interface has been destroyed!");
        return;
    }

    // Check if we send the whole packet
    if (txPacketSize != txPacketSizeSent)
    {
        commStatus = COMM_TXFAIL;
        commLock = 0;
        return;
    }

    // Set a timeout for the response packet
    // Min size of an RX packet is 9
    if (txPacket[PKT_CMD] == CMD_EEP_READ || txPacket[PKT_CMD] == CMD_RAM_READ)
    {
        serial->setTimeOut(9 + txPacket[PKT_DATA+1]);
    }
    else
    {
        serial->setTimeOut(9);
    }

    commStatus = COMM_TXSUCCESS;
}

void HerkuleX::hkx_rx_packet()
{
    if (serial == nullptr)
    {
        TRACE_ERROR(HKX, "Serial interface is not initialized!");
        return;
    }

    // No lock mean no packet has just been sent, so why wait for an answer (?)
    if (commLock == 0)
    {
        return;
    }

    // Packet sent to a broadcast address? No need to wait for a status packet.
    if (txPacket[PKT_ID] == BROADCAST_ID)
    {
        commStatus = COMM_RXSUCCESS;
        commLock = 0;
        return;
    }

    // Minimum status packet size estimation
    if (commStatus == COMM_TXSUCCESS)
    {
        // Min size of an RX packet is 9
        rxPacketSize = 9;
        rxPacketSizeReceived = 0;
    }

    // Receive packet
    int nRead = 0;
    if (serial != nullptr)
    {
        nRead = serial->rx((unsigned char*)&rxPacket[rxPacketSizeReceived], rxPacketSize - rxPacketSizeReceived);
        rxPacketSizeReceived += nRead;

        // Check if we received the whole packet
        if (rxPacketSizeReceived < rxPacketSize)
        {
            if (serial->checkTimeOut() == 1)
            {
                if (rxPacketSizeReceived == 0)
                {
                    commStatus = COMM_RXTIMEOUT;
                }
                else
                {
                    commStatus = COMM_RXCORRUPT;
                }

                commLock = 0;
                return;
            }
        }
    }
    else
    {
        TRACE_ERROR(HKX, "Serial interface has been destroyed!");
        return;
    }

    // Find packet header
    unsigned char i, j;
    for (i = 0; i < (rxPacketSizeReceived - 1); i++)
    {
        if (rxPacket[i] == 0xFF &&
            rxPacket[i+1] == 0xFF)
        {
            break;
        }
        else if (i == (rxPacketSizeReceived - 2) &&
                 rxPacket[rxPacketSizeReceived-1] == 0xFF)
        {
            break;
        }
    }

    if (i > 0)
    {
        for (j = 0; j < (rxPacketSizeReceived-i); j++)
        {
            rxPacket[j] = rxPacket[j + i];
        }

        rxPacketSizeReceived -= i;
    }

    // Incomplete packet?
    if (rxPacketSizeReceived < rxPacketSize)
    {
        commStatus = COMM_RXWAITING;
        return;
    }

    // Check ID pairing
    if (txPacket[PKT_ID] != rxPacket[PKT_ID])
    {
        commStatus = COMM_RXCORRUPT;
        commLock = 0;
        return;
    }

    // Rx packet size
    rxPacketSize = hkx_get_rxpacket_size();

    if (rxPacketSizeReceived < rxPacketSize)
    {
        nRead = serial->rx(&rxPacket[rxPacketSizeReceived], rxPacketSize - rxPacketSizeReceived);
        rxPacketSizeReceived += nRead;

        if (rxPacketSizeReceived < rxPacketSize)
        {
            commStatus = COMM_RXWAITING;
            return;
        }
    }

    // Generate a checksum of the incoming packet
    {
        unsigned short checksum = hkx_checksum_packet(rxPacket, rxPacketSize);

        // Compare it with the internal packet checksum
        if (rxPacket[PKT_CHECKSUM1] != get_lowbyte(checksum) &&
            rxPacket[PKT_CHECKSUM2] != get_highbyte(checksum))
        {
            commStatus = COMM_RXCORRUPT;
            commLock = 0;
            return;
        }
    }

    commStatus = COMM_RXSUCCESS;
    commLock = 0;
}

void HerkuleX::hkx_txrx_packet(int ack)
{
#ifdef LATENCY_TIMER
    // Latency timer for a complete transaction (instruction sent and status received)
    std::chrono::time_point<std::chrono::high_resolution_clock> start, end;
    start = std::chrono::high_resolution_clock::now();
#endif

    hkx_tx_packet();

    if (commStatus != COMM_TXSUCCESS)
    {
        TRACE_ERROR(HKX, "Unable to send TX packet on serial link: '%s'", serialGetCurrentDevice().c_str());
        return;
    }

    // Depending on 'ackPolicy' value and current instruction, we wait for an answer to the packet we just sent
    if (ack == ACK_DEFAULT)
    {
        ack = ackPolicy;
    }

    if (ack != ACK_NO_REPLY)
    {
        int cmd = txPacket[PKT_CMD];

        if ((ack == ACK_REPLY_ALL) ||
            (ack == ACK_REPLY_READ && (cmd == CMD_STAT || cmd == CMD_EEP_READ || cmd == CMD_RAM_READ)))
        {
            do {
                hkx_rx_packet();
            }
            while (commStatus == COMM_RXWAITING);
        }
        else
        {
            commStatus = COMM_RXSUCCESS;
            commLock = 0;
        }
    }
    else
    {
        commStatus = COMM_RXSUCCESS;
        commLock = 0;
    }

#ifdef PACKET_DEBUGGER
    printTxPacket();
    printRxPacket();
#endif

#ifdef LATENCY_TIMER
    end = std::chrono::high_resolution_clock::now();
    int loopd = std::chrono::duration_cast<std::chrono::microseconds>(end-start).count();
    TRACE_1(HKX, "TX > RX loop: %iµs", loopd);
#endif
}

// Low level API
////////////////////////////////////////////////////////////////////////////////

void HerkuleX::hkx_set_txpacket_header()
{
    txPacket[PKT_HEADER0] = 0xFF;
    txPacket[PKT_HEADER1] = 0xFF;
}

void HerkuleX::hkx_set_txpacket_id(int id)
{
    txPacket[PKT_ID] = get_lowbyte(id);
}

void HerkuleX::hkx_set_txpacket_length_field(int length)
{
    txPacket[PKT_LENGTH] = get_lowbyte(length);
}

void HerkuleX::hkx_set_txpacket_instruction(int instruction)
{
    txPacket[PKT_CMD] = get_lowbyte(instruction);
}

void HerkuleX::hkx_set_txpacket_parameter(int index, int value)
{
        txPacket[PKT_DATA+index] = get_lowbyte(value);
}

unsigned short HerkuleX::hkx_checksum_packet(unsigned char *packetData, const int packetSize)
{
    // Generate checksum
    unsigned short checksum = 0;

    // (PacketSize ^ pID ^ CMD ^ Data[0] ^ Data[1] ^ ... ^ Data[n])&0xFE
    int Sum1 = packetData[PKT_LENGTH];
    Sum1 ^= packetData[PKT_ID];
    Sum1 ^= packetData[PKT_CMD];
    for (int i = PKT_DATA; i < packetSize; i++)
    {
        Sum1 ^= packetData[i];
    }
    Sum1 &= 0xFE;

    //
    int Sum2 = (~Sum1) & 0xFE;

    // Make a word from these two bytes
    checksum  = get_lowbyte(Sum1);
    checksum += get_lowbyte(Sum2) << 8;

    return checksum;
}

int HerkuleX::hkx_get_txpacket_length_field()
{
    // The length field represent the full size of the packet
    return static_cast<int>(txPacket[PKT_LENGTH]);
}

int HerkuleX::hkx_get_txpacket_size()
{
    // The length field represent the full size of the packet
    return static_cast<int>(txPacket[PKT_LENGTH]);
}

int HerkuleX::hkx_validate_packet()
{
    int retcode = 1;

    // Check if packet size is valid
    if (hkx_get_txpacket_size() > MAX_PACKET_LENGTH_hkx)
    {
        commStatus = COMM_TXERROR;
        commLock = 0;
        retcode = 0;
    }

    // Check if packet instruction is valid
    if (txPacket[PKT_CMD] != CMD_EEP_WRITE &&
        txPacket[PKT_CMD] != CMD_EEP_READ &&
        txPacket[PKT_CMD] != CMD_RAM_WRITE &&
        txPacket[PKT_CMD] != CMD_RAM_READ &&
        txPacket[PKT_CMD] != CMD_I_JOG &&
        txPacket[PKT_CMD] != CMD_S_JOG &&
        txPacket[PKT_CMD] != CMD_STAT &&
        txPacket[PKT_CMD] != CMD_ROLLBACK &&
        txPacket[PKT_CMD] != CMD_REBOOT)
    {
        commStatus = COMM_TXERROR;
        commLock = 0;
        retcode = 0;
    }

    // Write sync header
    hkx_set_txpacket_header();

    return retcode;
}

int HerkuleX::hkx_get_rxpacket_error()
{
    int error = (rxPacket[rxPacketSize - 2] & 0xFD);
    return error;
}

int HerkuleX::hkx_get_rxpacket_status_detail()
{
    int status = (rxPacket[rxPacketSize - 1] & 0xFD);
    return status;
}

int HerkuleX::hkx_get_rxpacket_size()
{
    // The length field represent the full size of the packet
    return static_cast<int>(rxPacket[PKT_LENGTH]);
}

int HerkuleX::hkx_get_rxpacket_length_field()
{
    // The length field represent the full size of the packet
    return static_cast<int>(rxPacket[PKT_LENGTH]);
}

int HerkuleX::hkx_get_rxpacket_parameter(int index)
{
    return static_cast<int>(rxPacket[PKT_DATA + index]);
}

int HerkuleX::hkx_get_last_packet_id()
{
    // We want to use the ID of the last status packet received through the serial link
    int id = rxPacket[PKT_ID];

    // In case no status packet has been received (ex: RX timeout) we try to use the ID from the last packet sent
    if (id == 0)
    {
        id = txPacket[PKT_ID];
    }

    return id;
}

int HerkuleX::hkx_get_com_status()
{
    return commStatus;
}

int HerkuleX::hkx_get_com_error()
{
    if (commStatus < 0)
    {
        return commStatus;
    }

    return 0;
}

int HerkuleX::hkx_get_com_error_count()
{
    if (commStatus < 0)
    {
        return 1;
    }

    return 0;
}

int HerkuleX::hkx_print_error()
{
    int id = hkx_get_last_packet_id(); // Get device id which produce the error
    int error = 0;
    int status = 0;

    switch (commStatus)
    {
    case COMM_RXSUCCESS:
    case COMM_TXSUCCESS:
        // Get error bitfield
        error = hkx_get_rxpacket_error();

        if (error & ERRBIT_VOLTAGE)
            TRACE_ERROR(HKX, "[#%i] Protocol Error: ERRBIT_VOLTAGE", id);
        if (error & ERRBIT_ALLOWED_POT)
            TRACE_ERROR(HKX, "[#%i] Protocol Error: ERRBIT_ALLOWED_POT", id);
        if (error & ERRBIT_OVERHEAT)
            TRACE_ERROR(HKX, "[#%i] Protocol Error: ERRBIT_OVERHEAT", id);
        if (error & ERRBIT_INVALID_PKT)
        {
            TRACE_ERROR(HKX, "[#%i] Protocol Error: ERRBIT_INVALID_PKT:", id);

            // Get status bitfield
            status = hkx_get_rxpacket_status_detail();

            if (status & STATBIT_CHECKSUM_FLAG)
                TRACE_ERROR(HKX, "[#%i]   Packet Error: STATBIT_CHECKSUM_FLAG", id);
            if (status & STATBIT_UNKWOWN_CMD)
                TRACE_ERROR(HKX, "[#%i]   Packet Error: STATBIT_UNKWOWN_CMD", id);
            if (status & STATBIT_RANGE)
                TRACE_ERROR(HKX, "[#%i]   Packet Error: STATBIT_RANGE", id);
            if (status & STATBIT_GARBAGE)
                TRACE_ERROR(HKX, "[#%i]   Packet Error: STATBIT_GARBAGE", id);
        }
        if (error & ERRBIT_OVERLOAD)
            TRACE_ERROR(HKX, "[#%i] Protocol Error: ERRBIT_OVERLOAD", id);
        if (error & ERRBIT_DRIVER_FAULT)
            TRACE_ERROR(HKX, "[#%i] Protocol Error: ERRBIT_DRIVER_FAULT", id);
        if (error & ERRBIT_EEP_REG_DIST)
            TRACE_ERROR(HKX, "[#%i] Protocol Error: ERRBIT_EEP_REG_DIST", id);
        break;

    case COMM_UNKNOWN:
        TRACE_ERROR(HKX, "[#%i] COMM_UNKNOWN: Unknown communication error!", id);
        break;

    case COMM_TXFAIL:
        TRACE_ERROR(HKX, "[#%i] COMM_TXFAIL: Failed transmit instruction packet!", id);
        break;

    case COMM_TXERROR:
        TRACE_ERROR(HKX, "[#%i] COMM_TXERROR: Incorrect instruction packet!", id);
        break;

    case COMM_RXFAIL:
        TRACE_ERROR(HKX, "[#%i] COMM_RXFAIL: Failed get status packet from device!", id);
        break;

    case COMM_RXWAITING:
        TRACE_ERROR(HKX, "[#%i] COMM_RXWAITING: Now recieving status packet!", id);
        break;

    case COMM_RXTIMEOUT:
        TRACE_ERROR(HKX, "[#%i] COMM_RXTIMEOUT: Timeout reached while waiting for a status packet!", id);
        break;

    case COMM_RXCORRUPT:
        TRACE_ERROR(HKX, "[#%i] COMM_RXCORRUPT: Status packet is corrupted!", id);
        break;

    default:
        TRACE_ERROR(HKX, "[#%i] commStatus has an unknown error code: '%i'", id, commStatus);
        break;
    }

    return error;
}

int HerkuleX::hkx_print_status()
{
    int id = hkx_get_last_packet_id(); // Get device id which produce the error
    int error = 0;
    int status = 0;

    switch (commStatus)
    {
    case COMM_RXSUCCESS:
    case COMM_TXSUCCESS:
        // Get status bitfield
        status = hkx_get_rxpacket_status_detail();

        if (error & ERRBIT_VOLTAGE)
            TRACE_ERROR(HKX, "[#%i] Protocol Error: ERRBIT_VOLTAGE", id);
        if (error & ERRBIT_ALLOWED_POT)
            TRACE_ERROR(HKX, "[#%i] Protocol Error: ERRBIT_ALLOWED_POT", id);
        if (error & ERRBIT_OVERHEAT)
            TRACE_ERROR(HKX, "[#%i] Protocol Error: ERRBIT_OVERHEAT", id);
        if (error & ERRBIT_INVALID_PKT)
            TRACE_ERROR(HKX, "[#%i] Protocol Error: ERRBIT_INVALID_PKT", id);
        if (error & ERRBIT_OVERLOAD)
            TRACE_ERROR(HKX, "[#%i] Protocol Error: ERRBIT_OVERLOAD", id);
        if (error & ERRBIT_DRIVER_FAULT)
            TRACE_ERROR(HKX, "[#%i] Protocol Error: ERRBIT_DRIVER_FAULT", id);
        if (error & ERRBIT_EEP_REG_DIST)
            TRACE_ERROR(HKX, "[#%i] Protocol Error: ERRBIT_EEP_REG_DIST", id);

        if (status & STATBIT_MOVING)
            { TRACE_INFO(HKX, "[#%i] Protocol Status: STATBIT_MOVING", id); }
        if (status & STATBIT_INPOSITION)
            { TRACE_INFO(HKX, "[#%i] Protocol Status: STATBIT_INPOSITION", id); }
        if (status & STATBIT_CHECKSUM_FLAG)
            TRACE_ERROR(HKX, "[#%i] Packet Status: STATBIT_CHECKSUM_FLAG", id);
        if (status & STATBIT_UNKWOWN_CMD)
            TRACE_ERROR(HKX, "[#%i] Packet Status: STATBIT_UNKWOWN_CMD", id);
        if (status & STATBIT_RANGE)
            TRACE_ERROR(HKX, "[#%i] Packet Status: STATBIT_RANGE", id);
        if (status & STATBIT_GARBAGE)
            TRACE_ERROR(HKX, "[#%i] Packet Status: STATBIT_GARBAGE", id);
        if (status & STATBIT_TORQUE_ON)
        { TRACE_INFO(HKX, "[#%i] Protocol Status: STATBIT_TORQUE_ON", id); }
        break;
    }

    return error;
}

void HerkuleX::printRxPacket()
{
    printf("Packet recv [ ");
    printf("0x%.2X 0x%.2X ", rxPacket[0], rxPacket[1]);
    printf("{0x%.2X} ", rxPacket[2]);
    printf("0x%.2X ", rxPacket[3]);
    printf("(0x%.2X) ", rxPacket[4]);
    printf("{0x%.2X 0x%.2X} ", rxPacket[5], rxPacket[6]);
    for (int i = 7; i < rxPacketSize; i++)
    {
        printf("0x%.2X ", rxPacket[i]);
    }
    printf("]\n");
}

void HerkuleX::printTxPacket()
{
    printf("Packet sent [ ");
    printf("0x%.2X 0x%.2X ", txPacket[0], txPacket[1]);
    printf("{0x%.2X} ", txPacket[2]);
    printf("0x%.2X ", txPacket[3]);
    printf("(0x%.2X) ", txPacket[4]);
    printf("{0x%.2X 0x%.2X} ", txPacket[5], txPacket[6]);
    // The length field represent the full size of the packet
    for (int i = 7; i < txPacket[PKT_LENGTH]; i++)
    {
        printf("0x%.2X ", txPacket[i]);
    }
    printf("]\n");
}

bool HerkuleX::hkx_ping(const int id, PingResponse *status, const int ack)
{
    bool retcode = false;

    while(commLock);

    // We do not use a READ instruction directly instead of STAT, because it may
    // not receive an answer depending on ack policy value.

    txPacket[PKT_ID] = get_lowbyte(id);
    txPacket[PKT_CMD] = CMD_STAT;
    txPacket[PKT_LENGTH] = 7;

    hkx_txrx_packet(ack);

    if (commStatus == COMM_RXSUCCESS)
    {
        retcode = true;

        if (status != nullptr)
        {
            // Emulate ping response from Dynamixel protocol v2
            status->model_number = hkx_read_word(id, 0, REGISTER_ROM, ack);
            status->firmware_version = hkx_read_word(id, 2, REGISTER_ROM, ack);
        }
    }

    return retcode;
}

void HerkuleX::hkx_reset(const int id, int setting, const int ack)
{
    while(commLock);

    txPacket[PKT_LENGTH] = 9;
    txPacket[PKT_ID] = get_lowbyte(id);
    txPacket[PKT_CMD] = CMD_ROLLBACK;

    if (setting == RESET_ALL_EXCEPT_ID)
    {
        txPacket[PKT_DATA]   = 1;
        txPacket[PKT_DATA+1] = 0;
    }
    else if (setting == RESET_ALL_EXCEPT_ID_BAUDRATE)
    {
        txPacket[PKT_DATA]   = 1;
        txPacket[PKT_DATA+1] = 1;
    }
    else
    {
        // RESET_ALL
    }

    hkx_txrx_packet(ack);
}

void HerkuleX::hkx_reboot(const int id, const int ack)
{
    while(commLock);

    txPacket[PKT_LENGTH] = 7;
    txPacket[PKT_ID] = get_lowbyte(id);
    txPacket[PKT_CMD] = CMD_REBOOT;

    hkx_txrx_packet(ack);
}

int HerkuleX::hkx_read_byte(const int id, const int address, const int register_type, const int ack)
{
    int value = -1;

    if (id == 254)
    {
        TRACE_ERROR(HKX, "Cannot send 'Read' instruction to broadcast address!");
    }
    else if (ack == ACK_NO_REPLY)
    {
        TRACE_ERROR(HKX, "Cannot send 'Read' instruction if ACK_NO_REPLY is set!");
    }
    else
    {
        while(commLock);

        txPacket[PKT_LENGTH] = 7 + 2;
        txPacket[PKT_ID] = get_lowbyte(id);
        if (register_type == REGISTER_RAM)
            txPacket[PKT_CMD] = CMD_RAM_READ;
        else
            txPacket[PKT_CMD] = CMD_EEP_READ;

        txPacket[PKT_DATA] = get_lowbyte(address);
        txPacket[PKT_DATA+1] = 1;
    }

    hkx_txrx_packet(ack);

    if ((ack == ACK_DEFAULT && ackPolicy > ACK_NO_REPLY) ||
        (ack > ACK_NO_REPLY))
    {
        if (commStatus == COMM_RXSUCCESS)
        {
            value = static_cast<int>(rxPacket[PKT_DATA+2]);
        }
        else
        {
            value = commStatus;
        }
    }

    return value;
}

void HerkuleX::hkx_write_byte(const int id, const int address, const int value, const int register_type, const int ack)
{
    while(commLock);

    txPacket[PKT_LENGTH] = 7 + 3;
    txPacket[PKT_ID] = get_lowbyte(id);
    if (register_type == REGISTER_RAM)
        txPacket[PKT_CMD] = CMD_RAM_WRITE;
    else
        txPacket[PKT_CMD] = CMD_EEP_WRITE;

    txPacket[PKT_DATA] = get_lowbyte(address);
    txPacket[PKT_DATA+1] = 1;
    txPacket[PKT_DATA+2] = get_lowbyte(value);

    hkx_txrx_packet(ack);
}

int HerkuleX::hkx_read_word(const int id, const int address, const int register_type, const int ack)
{
    int value = -1;

    if (id == 254)
    {
        TRACE_ERROR(HKX, "Cannot send 'Read' instruction to broadcast address!");
    }
    else if (ack == ACK_NO_REPLY)
    {
        TRACE_ERROR(HKX, "Cannot send 'Read' instruction if ACK_NO_REPLY is set!");
    }
    else
    {
        while(commLock);

        txPacket[PKT_LENGTH] = 7 + 2;
        txPacket[PKT_ID] = get_lowbyte(id);
        if (register_type == REGISTER_RAM)
            txPacket[PKT_CMD] = CMD_RAM_READ;
        else
            txPacket[PKT_CMD] = CMD_EEP_READ;

        txPacket[PKT_DATA] = get_lowbyte(address);
        txPacket[PKT_DATA+1] = 2;

        hkx_txrx_packet(ack);

        if ((ack == ACK_DEFAULT && ackPolicy > ACK_NO_REPLY) ||
            (ack > ACK_NO_REPLY))
        {
            if (commStatus == COMM_RXSUCCESS)
            {
                value = make_short_word(rxPacket[PKT_DATA+2], rxPacket[PKT_DATA+3]);
            }
            else
            {
                value = commStatus;
            }
        }
    }

    return value;
}

void HerkuleX::hkx_write_word(const int id, const int address, const int value, const int register_type, const int ack)
{
    while(commLock);

    txPacket[PKT_LENGTH] = 7 + 4;
    txPacket[PKT_ID] = get_lowbyte(id);
    if (register_type == REGISTER_RAM)
        txPacket[PKT_CMD] = CMD_RAM_WRITE;
    else
        txPacket[PKT_CMD] = CMD_EEP_WRITE;

    txPacket[PKT_DATA] = get_lowbyte(address);
    txPacket[PKT_DATA+1] = 2;
    txPacket[PKT_DATA+2] = get_lowbyte(value);
    txPacket[PKT_DATA+3] = get_highbyte(value);

    hkx_txrx_packet(ack);
}

void HerkuleX::hkx_i_jog(const int id, const int mode, const int value, const int ack)
{
    int JOG = 0;
    int SET = 0;
    while(commLock);

    txPacket[PKT_LENGTH] = 7 + 5;
    txPacket[PKT_ID] = get_lowbyte(id);
    txPacket[PKT_CMD] = CMD_I_JOG;

    if (mode == 0) // Position control
    {
        JOG = value; // goal position
        SET = 0x04; // position control with green led
    }
    else // if (mode == 1) // Continuous rotation
    {
        if (value >= 0)
        {
            JOG = value; // speed
        }
        else
        {
            JOG = std::abs(value); // speed
            JOG += 0x4000; // direction
        }
        SET = 0x0A; // continuous rotation with blue led
    }

    // I_JOG(0)
    txPacket[PKT_DATA]   = get_lowbyte(JOG);
    txPacket[PKT_DATA+1] = get_highbyte(JOG);
    txPacket[PKT_DATA+2] = get_lowbyte(SET);
    txPacket[PKT_DATA+3] = get_lowbyte(id); // id
    txPacket[PKT_DATA+4] = 0x3c; // playtime

    hkx_txrx_packet(ack);
}

void HerkuleX::hkx_s_jog(const int id, const int mode, const int value, const int ack)
{
    int JOG = 0;
    int SET = 0;
    while(commLock);

    txPacket[PKT_LENGTH] = 7 + 5;
    txPacket[PKT_ID] = get_lowbyte(id);
    txPacket[PKT_CMD] = CMD_S_JOG;
    txPacket[PKT_DATA] = 0x3c; // playtime

    if (mode == 0) // Position control
    {
        JOG = value; // goal position
        SET = 0x04; // position control with green led
    }
    else // if (mode == 1) // Continuous rotation
    {
        if (value >= 0)
        {
            JOG = value; // goal position
        }
        else
        {
            JOG = std::abs(value); // speed
            JOG += 0x4000; // direction
        }
        SET = 0x0A; // continuous rotation with blue led
    }

    // S_JOG(0)
    txPacket[PKT_DATA+1] = get_lowbyte(JOG);
    txPacket[PKT_DATA+2] = get_highbyte(JOG);
    txPacket[PKT_DATA+3] = get_lowbyte(SET);
    txPacket[PKT_DATA+4] = get_lowbyte(id); // id

    hkx_txrx_packet(ack);
}
