jochenalt/Pentapod-Design/(commit log)

2017-08-30 added cad
    [3296W.ipt, BNO055.ipt, BOTTOM_CASE_290.ipt, BatterPackHolder.dwg, BatterPackHolder.ipt, Battery 18650.ipt, Battery 26500.ipt, Battery Pack.iam]
2017-08-31 layout improvements
    [Body.stl, CortexBoard.kicad_pcb, CortexBoard.sch, Hip.stl, HipJoint.stl, Knee.stl, Thigh.stl, foot.stl]
2017-09-01 made new power supply board
    [BatterPackHolder.ipt, CortexBoard.csv, CortexBoard.kicad_pcb, CortexBoard.sch]
2017-09-03 Body is too tight., gave it 5mm more headroom
    [BatterPackHolder.ipt, Battery Pack.iam, Body-40x.ipt, CortexBoard.kicad_pcb, CortexBoard.sch, Lidar-Holder-40x.ipt]
2017-09-03 adapted body
    [BatterPackHolder.ipt, Battery Pack.iam, Body-40x.ipt, CortexBoard.sch, Lidar-Holder-40x.ipt, ODroid Holder-40x.ipt]
2017-09-13 added documentation for navigation stack
    [BatterPackHolder.ipt, Battery Pack.iam, Body-40x.iam, Pentapod Bom.xlsx]
2017-09-16 Made Body smaller again
    [Battery Pack.iam, Body-40x.iam, Body-40x.ipt, ODroid Holder-40x.ipt]
2017-09-16 new Elko to stabilize servo voltage
    [CortexBoard.kicad_pcb, CortexBoard.sch]
2017-09-17 body changed such that it does not look like a vase anymore
    [BatterPackHolder.ipt, Battery Pack.iam, Body-40x.iam, Body-40x.ipt, CortexBoard.sch, Leg-40x.iam]
2017-09-17 made body socket nicer
    [Body-40x.iam, Body-40x.ipt]
2017-09-19 changed socket board in body and made Hip to fit to the body's plane
    [Body-40x.iam, Body-40x.ipt, Hip-40x.ipt, Leg-40x.iam]
2017-09-20 found CAD model of servo Herkulex DRS-0401 and integrated it
    [Body-40x.iam, Herkulex DRS-040x.ipt, HipJoint-40x.ipt, Kegelräder1.iam, Leg-40x.iam, Thigh-40x.iam, Thigh-40x.ipt]
2017-09-22 Wire-hole for leg No.4 was too low
    [Body-40x.iam, Body-40x.ipt, Hip-40x.ipt, Leg-40x.iam]
2017-09-24 a weekend's work
    [BatterPackHolder.ipt, Battery Pack.iam, Body-40x.iam, Body-40x.ipt, CortexBoard.kicad_pcb, CortexBoard.sch, Foot-40x.iam, Foot-40x.ipt]
2017-09-25 Started preparation for DRS-0401 servo (already ordered)
    [BatterPackHolder.ipt, Battery Pack.iam, Body-40x.iam, CortexBoard.kicad_pcb, CortexBoard.sch, Foot-40x.ipt, HipJoint-40x.ipt, Kegelräder1.iam]
2017-09-26 Big design change to support upcoming DRS-0401 servos
    [Foot-40x.iam, Foot-40x.ipt, HerkuleX DRS-0201.iam, Hip-40x.ipt, HipJoint-40x.ipt, Kegelrad11.ipt, Kegelrad21.ipt, Kegelräder 040x.iam]
2017-09-27 made a nice view of all objects
    [BOTTOM_CASE_290.ipt, CASE_228.ipt, HORN_44.ipt, HerkuleX DRS-0101.iam, Herkulex DRS-040x.ipt, HipJoint-40x.ipt, Kegelrad11.ipt, Kegelrad21.ipt]
2017-09-29 Many changes due to first test with DRS-0401
    [Foot-40x.iam, Foot-40x.ipt, HipJoint-40x.ipt, HipJoint.ipt, Kegelrad11.ipt, Kegelrad21.ipt, Kegelräder 040x.iam, Kegelräder1.iam]
2017-09-30 first try with DRS-0401 PCB
    [CortexBoard.kicad_pcb, CortexBoard.sch]
2017-10-03 corrections after assembly of 040x leg
    [Foot-40x.iam, Foot-40x.ipt, Kegelrad11.ipt, Kegelrad21.ipt, Kegelräder 040x.iam, Kegelräder1.iam, Knee-40x.ipt, Leg-40x.iam]
2017-10-03 updated kinematics docs
2017-10-03 last minute changes before printing
    [Foot-40x.iam, Foot-40x.ipt, Knee-40x.ipt, Leg-40x.iam, Thigh Bushing 040x.ipt, Thigh-40x.iam, Thigh-40x.ipt]
2017-10-04 Tried a knee zylinder with fase
    [Kegelrad21.ipt, Knee-40x.ipt, Leg-40x.iam, Pentapod Bom.xlsx, Thigh Bushing 040x.ipt, Thigh-40x.iam]
2017-10-06 new CAD pictures
2017-10-06 new videos
    [Kegelräder 040x.iam, Kegelräder Construction.iam, Kegelräder1.iam, Knee-40x.ipt, Leg-40x.iam, Thigh-40x.iam, ThighKneeGear.iam]
2017-10-07 added STL files
    [Big-Bevel-Gear.stl, Dampener-disk.stl, Dampener-shape-holder.stl, Dampener-shape-inside.stl, Dampener-shape-left.stl, Dampener-shape-right.stl, Foot-left.stl, Foot-right.stl]
2017-10-07 Removed red cross in some parts
    [Foot-40x.ipt, Hip-40x.ipt, Kegelrad11.ipt, Knee-40x.ipt, Leg-40x.iam, Thigh Bushing 040x.ipt, Thigh-40x.iam, ThighKneeGear.iam]
2017-10-09 adapted Hip to get thicker walls
    [Foot-40x.iam, Foot-40x.ipt, Hip-40x.iam, Hip-40x.ipt, Knee-40x.ipt, Leg-40x.iam, Thigh-40x.iam]
2017-10-10 small dimension corrections
    [3296W.ipt, BNO055.ipt, BatterPackHolder.ipt, Battery 18650.ipt, Battery Pack.iam, Body-40x.iam, Body-40x.ipt, CAPAE-D10.0x10.2.ipt]
2017-10-15 increased height of body by 4 mm to make more space for cortex
    [BatterPackHolder.ipt, Battery Pack.iam, Body-40x.iam, Body-40x.ipt, Foot-40x.iam, Hip-40x.iam, Leg-40x.iam, Lidar-Holder-40x.ipt]
2017-10-18 lowered thread to make more space for cortex
    [Battery Pack.iam, Body-40x.iam, Body-40x.ipt, Leg-40x.iam, Lidar-Holder-40x.ipt, ODroid Holder-40x.ipt, Pentapod Bom.xlsx]
2017-10-20 printed new body shape
    [Body-40x.iam, Body-40x.ipt, HipJoint-left.stl, HipJoint-right.stl, Lidar-Holder.stl, ODroid-Holder.stl, Servo-Axis.stl]
2017-10-20 reshaped hip curve to match body-shape
    [Body-40x.iam, Body-40x.ipt, Hip-40x.iam, Hip-40x.ipt, Hip-bottom.stl, Hip-top.stl, Leg-40x.iam]
2017-10-27 removed pre-040x parts
    [Body-40x.iam, Foot-40x.iam, Foot-40x.ipt, Hip-40x.iam, Hip-40x.ipt, Hip-bottom.stl, Hip-top.stl, HipJoint-40x.ipt]
2017-10-28 removed legacy designs
    [Body Inside-40x.iam, Body Inside.iam, Body-40x.iam, Body-40x.ipt, Body.iam, Body.ipt, Foot-40x.iam, Foot-40x.ipt]
2017-10-28 renamed, removed legacy
    [SimplifiedBody.ipt, SimplifiedFoot.ipt, SimplifiedHip.ipt, SimplifiedHipJoint.ipt, SimplifiedKnee.ipt, SimplifiedLeg.iam, SimplifiedLeg040x.iam, SimplifiedThigh.ipt]
2017-11-05 corrected foot dampener, introduced design for Odroid XU4 and renamed old 040x stuff
    [Body Xu4.iam, CortexBoard.csv, CortexBoard.dsn, CortexBoard.kicad_pcb, CortexBoard.sch, Dampener-Holder.stl, Dampener-Shape-1.stl, Dampener-disk.stl]
2017-11-11 a litte more space for servo
    [Foot.ipt]
2017-11-17 mode room for foot servo
    [Foot-V2.ipt, Foot-left.stl, Foot-right.stl, Foot.ipt, Pentapod Bom.xlsx]
2017-12-29 made all M3 screw holes 0,5mm bigger
    [Foot-left.stl, Foot-right.stl, Foot.iam, Foot.ipt, Hip-bottom.stl, Hip-top.stl, Hip.iam, Hip.ipt]
2017-12-30 Amended some drill holes to use M6/8 screws only
    [Foot.iam, Foot.ipt, Knee.ipt, Leg.iam, Thigh.iam]
