jochenalt/Pentapod-Design/(notices)

Notices in the files:
datasheets/ServoFrameWork/Utils.h:
SmartServoFramework is free software; you can redistribute it and/or modify
it under the terms of the GNU Lesser General Public License as published by
the Free Software Foundation; either version 3 of the License, or
(at your option) any later version.
along with this software. If not, see <http://www.gnu.org/licenses/lgpl-3.0.txt>.
